Kevinchu77/MobileRobot/0.1.Hardware/0.1.Solidworks/switch/Rocker Switch_KCD1-11_2pin_03.png

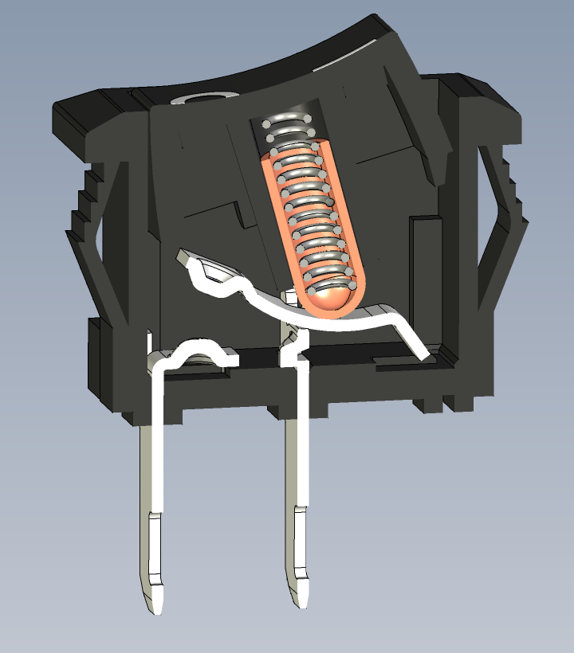
0.1.Hardware/0.1.Solidworks/switch/Rocker Switch_KCD1-11_2pin_03.png
