Kevinchu77/MobileRobot/README.md

# MobileRobot
Line Follower Robot

Date Start:
Date Finished:
