Kevinchu77/MobileRobot/0.1.Hardware/0.1.Solidworks/7c035552-377d-488c-9ed5-d222bd1f89a3.jpg

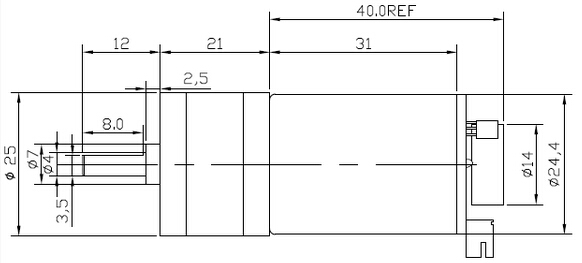
0.1.Hardware/0.1.Solidworks/7c035552-377d-488c-9ed5-d222bd1f89a3.jpg
