Kevinchu77/MobileRobot/0.1.Hardware/0.1.Solidworks/GA DONG CO GM 25 SERVOGEAR MOTOR.jpg

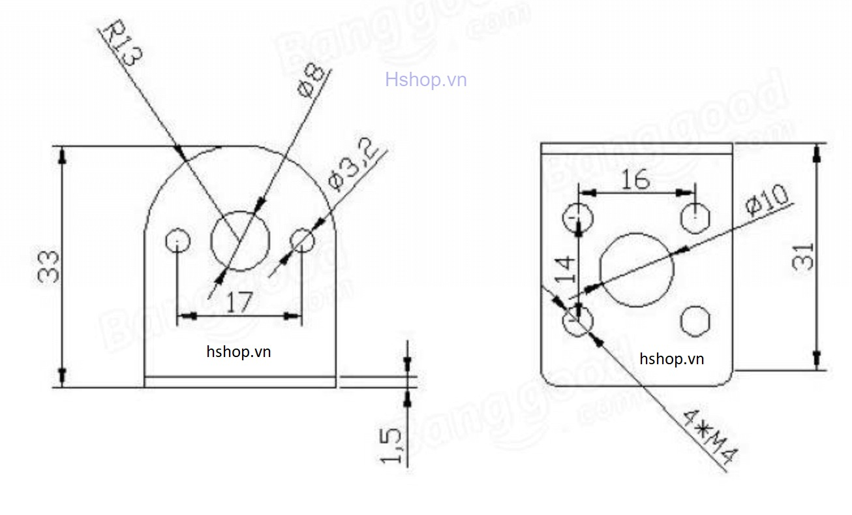
0.1.Hardware/0.1.Solidworks/GA DONG CO GM 25 SERVOGEAR MOTOR.jpg
