Kevinchu77/MobileRobot/0.1.Hardware/0.1.Solidworks/sensor_mid/Rendering/Rendering_1.jpg

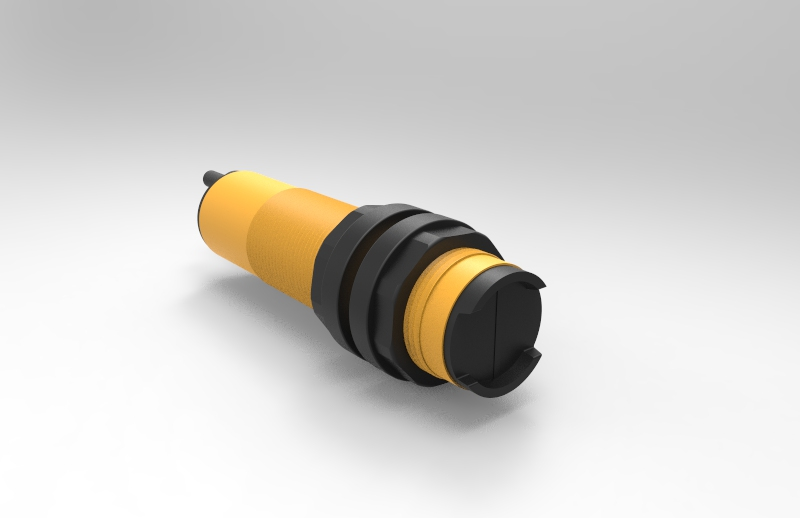
0.1.Hardware/0.1.Solidworks/sensor_mid/Rendering/Rendering_1.jpg
