Kevinchu77/MobileRobot/0.1.Hardware/0.1.Solidworks/sensor_mid/TCRT5000MOD.PNG

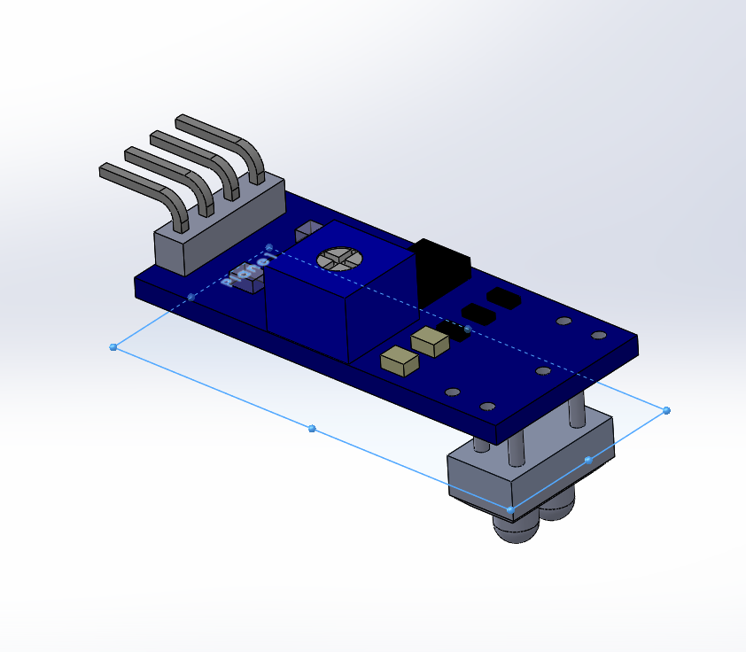
0.1.Hardware/0.1.Solidworks/sensor_mid/TCRT5000MOD.PNG
