Kevinchu77/MobileRobot/0.1.Hardware/0.1.Solidworks/switch/Rocker Switch_KCD1-11_2pin_01.png

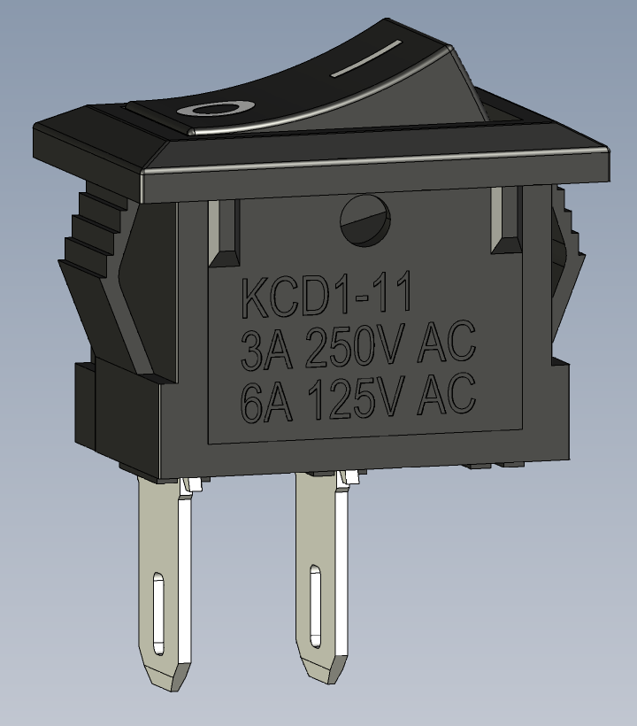
0.1.Hardware/0.1.Solidworks/switch/Rocker Switch_KCD1-11_2pin_01.png
