Kevinchu77/MobileRobot/0.1.Hardware/0.2. Image/top.JPG

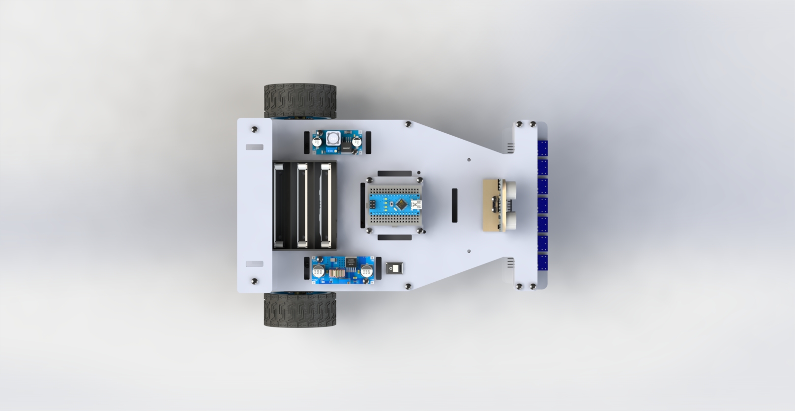
0.1.Hardware/0.2. Image/top.JPG
