Kevinchu77/MobileRobot/0.0.Materials/5.0024760.pdf

Line Follower Robot & Obstacle Detection Using PID Controller (https://www.researchgate.net/publication/345499688_Line_Follower_Robot_Obstacle_Detection_Using_PID_Controller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)

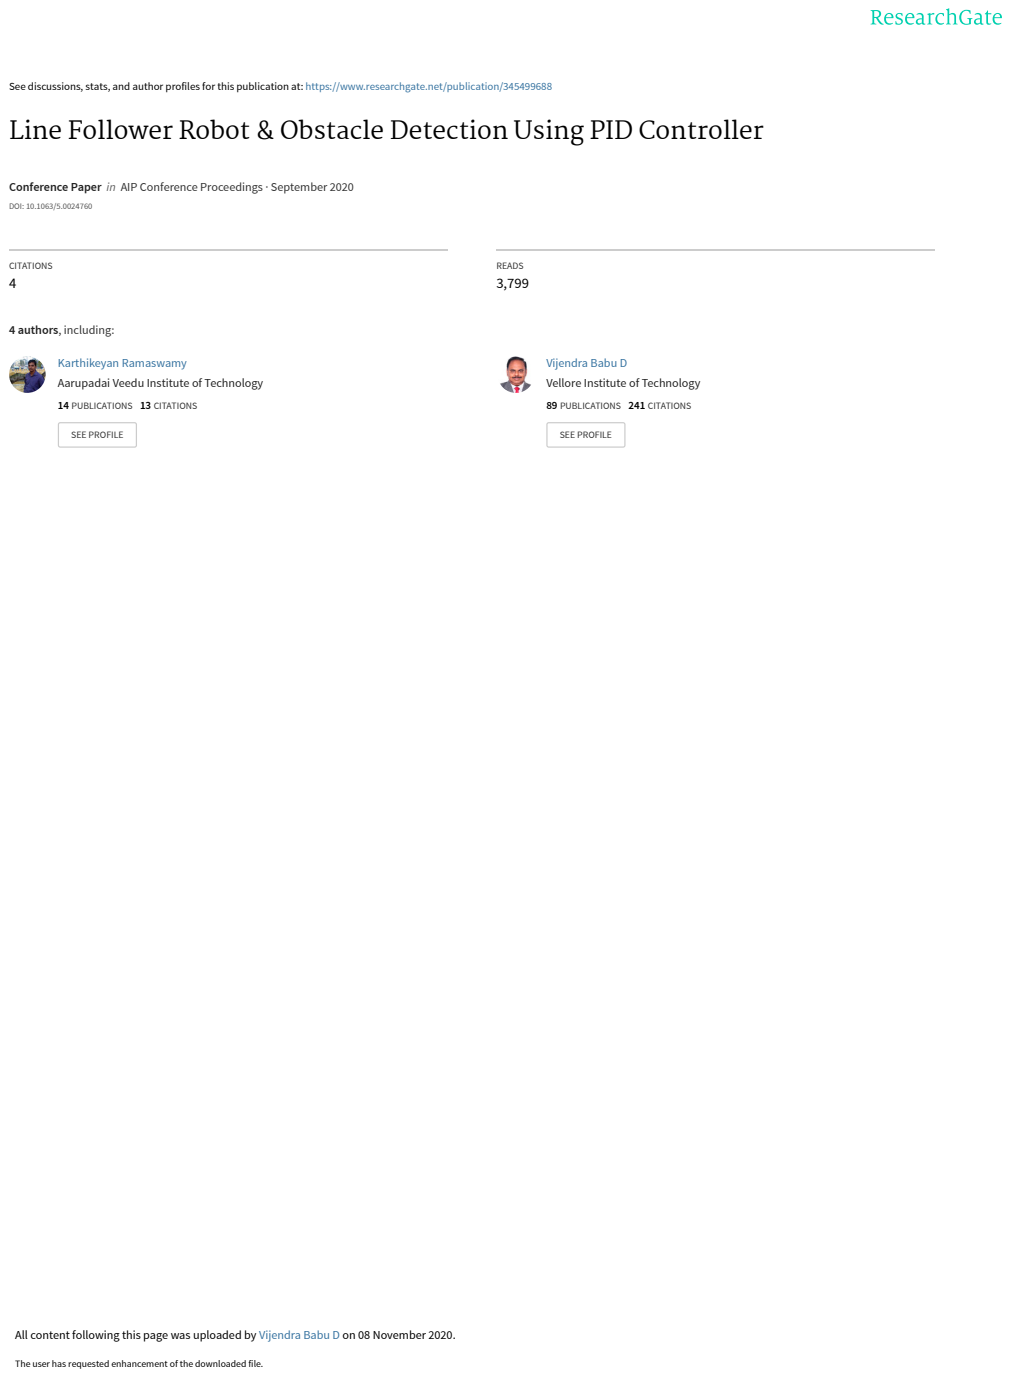
[picture p77: page 1]
DOI: 10.1063/5.0024760; CITATIONS 4; READS 3,799; 4 authors, including:; 14 PUBLICATIONS 13 CITATIONS; SEE PROFILE; 89 PUBLICATIONS 241 CITATIONS

See discussions, stats, and author profiles for this publication at: https://www.researchgate.net/publication/345499688

Conference Paper in AIP Conference Proceedings · September 2020

Karthikeyan Ramaswamy (https://www.researchgate.net/profile/Karthikeyan-Ramaswamy?el=1_x_5&_esc=publicationCoverPdf)
Aarupadai Veedu Institute of Technology (https://www.researchgate.net/institution/Aarupadai-Veedu-Institute-of-Technology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)

Vijendra Babu D (https://www.researchgate.net/profile/Vijendra-Babu-D?el=1_x_5&_esc=publicationCoverPdf)
Vellore Institute of Technology

All content following this page was uploaded by Vijendra Babu D (https://www.researchgate.net/profile/Vijendra-Babu-D?el=1_x_10&_esc=publicationCoverPdf) on 08 November 2020.

The user has requested enhancement of the downloaded file.

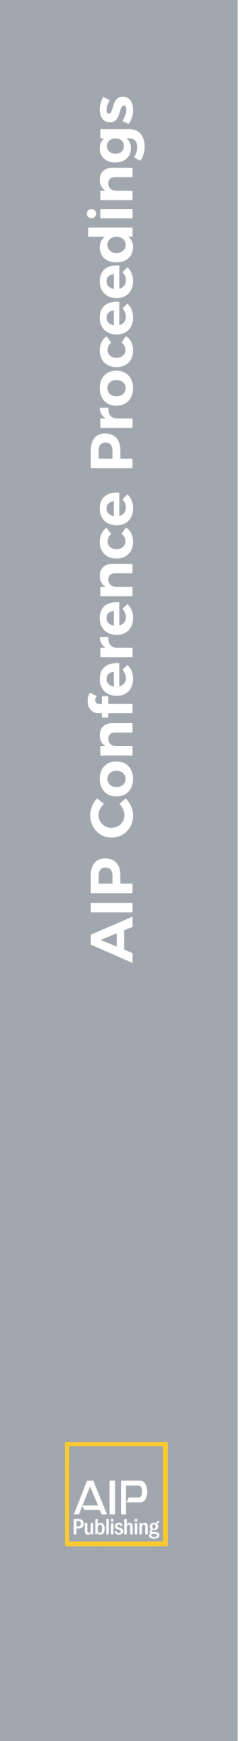
[picture p78: figure]
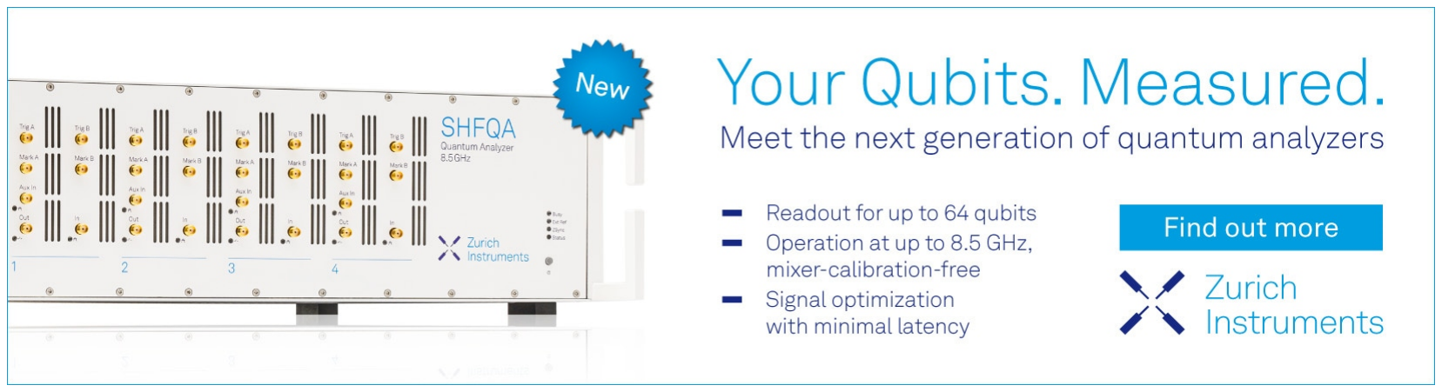
[picture p79: figure]

AIP Conference Proceedings 2271, 030005 (2020); https://doi.org/10.1063/5.0024760 | 2271, 030005

© 2020 Author(s).

# Line follower robot & obstacle detection using PID controller

Cite as: AIP Conference Proceedings 2271, 030005 (2020); https://doi.org/10.1063/5.0024760 Published Online: 28 September 2020

D. Vijendra Babu, (https://aip.scitation.org/author/Babu%2C+D+Vijendra) D. C. Jenniffer, (https://aip.scitation.org/author/Jenniffer%2C+D+C) and R. Karthikeyan (https://aip.scitation.org/author/Karthikeyan%2C+R)

### ARTICLES YOU MAY BE INTERESTED IN

Preface: International Conference on Mechanical, Electronics and Computer Engineering: ICMECE2020 (https://aip.scitation.org/doi/10.1063/12.0001149)
AIP Conference Proceedings 2271, 010001 (2020); https://doi.org/10.1063/12.0001149

Utilization of e-waste in flexible pavement (https://aip.scitation.org/doi/10.1063/5.0024752)
AIP Conference Proceedings 2271, 030001 (2020); https://doi.org/10.1063/5.0024752

Optimization of pitch distance of kevlar thread stitching in chopped GFRP composite laminates (https://aip.scitation.org/doi/10.1063/5.0024784)
AIP Conference Proceedings 2271, 030021 (2020); https://doi.org/10.1063/5.0024784

# Line Follower Robot & Obstacle Detection Using PID Controller

## D.Vijendra Babu¹,a), D.C.Jenniffer²

## , R.Karthikeyan³

1

Professor, ²

PG Student, ³
Assistant Professor, AarupadaiVeedu Institute of Technology, Vinayaka Mission’s Research Foundation, Deemed to be University, Chennai, India.
a) Corresponding author: vijendrababu@avit.ac.in

Abstract.Navigation is the significant feature in applications of Mobile Robots. Various navigation tools are available based on accuracy & complexity. PID Controller is used for designing a Line follower Robot. Array of multiple sensors detects the black surface and travel along the line. Arduino Uno continuously monitors the signal from the sensors and turns the Robot as the line getting detected. Obstacle detection is performed by Ultrasonic sensor. Line follower Robots are applicable in military, intruder alarm systems and so on.

Keywords. PID, Arduino, obstacle detection, line follower, ultrasonic sensor

### INTRODUCTION

Robotics is a branch of Engineering deals with concepts, design, manufacture and operation. Robotics involves multidisciplinary fields such as Computer Science, Electronics, Artificial intelligence, Nanotechnology & Mechatronics [1]. Line Tracking is significant and desired behavior of mobile robots which has significant importance in current scenario. Line tracking has evolved as the convenient and reliable navigation technique through which autonomous mobile robots navigate at indoor environment in a controlled manner [2]. A Line follower robot follows the predetermined path and determines its own procedure while interacting with obstacle. The path may be visible or invisible. In industries, it is mostly used to carry parcels in a track. With existing degree of autonomy, Mobile robots can move around in specific environment. Autonomous navigation is related to the availability of external sensors which acquires information from environment through visual images or distance. Path detection is determined by proximity sensor and Obstacle detection is determined by IR sensor [3]. Arduino MEGA R3 2650 is a Microcontroller based board recommended for Robotics & 3D Printers. It is compatible with most Uno boards [4].

### SYSTEM DESIGN

Arduino MEGA R3 2650, the most popular Proportional Integral Derivative (PID) controller is used. It is mostly used in industrial control applications for regulating variables as pressure, flow, level, temperature and so on [5].IR

International Conference on Mechanical, Electronics and Computer Engineering AIP Conf. Proc. 2271, 030005-1–030005-7; https://doi.org/10.1063/5.0024760 Published by AIP Publishing. 978-0-7354-3999-3/$30.00

Sensor uses LED for emitting light and measures the received light intensity for detecting the obstacle. Ultrasonic sensor measures the distance by using sound waves using sensors on its front [5-7]. It works in a range 3cm to 3m.The purpose of the motor driver for converting low current signal to high current signal for driving the motor coil [8-9]. It consists of 2 front drive motors and 2 back drive motors.Fig.1 (a) displays the Line follower unit, Fig.1
(b) shows the PID Controller-Arduino MEGA R3 2650 module. Fig. 1(c), Fig.1 (d) &Fig.1 (e) shows IR sensor, Ultrasonic sensor & Motor driver respectively.

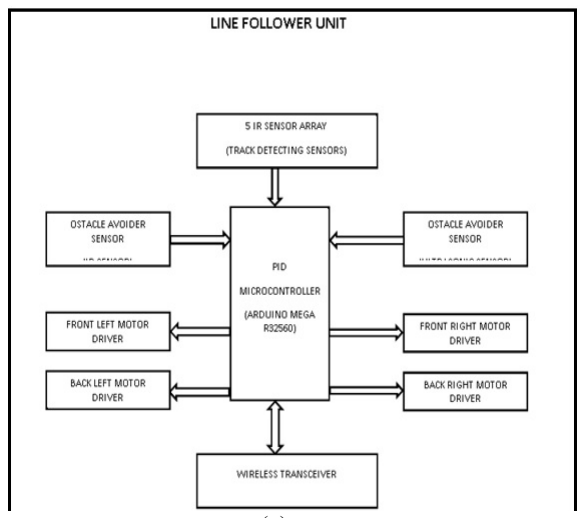
[picture p80: figure]

(a)

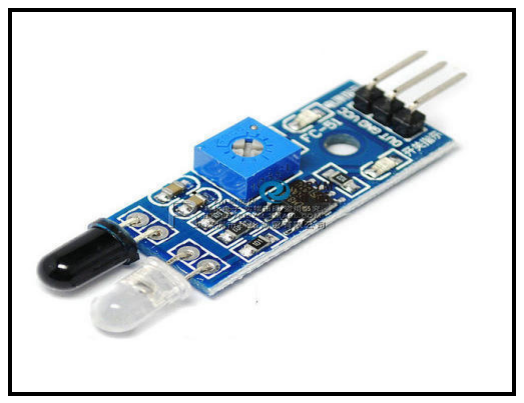
[picture p81: figure]
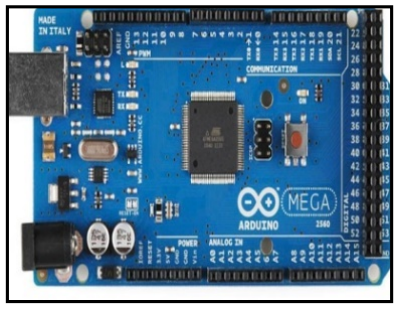
[picture p82: figure]

(b) (c)

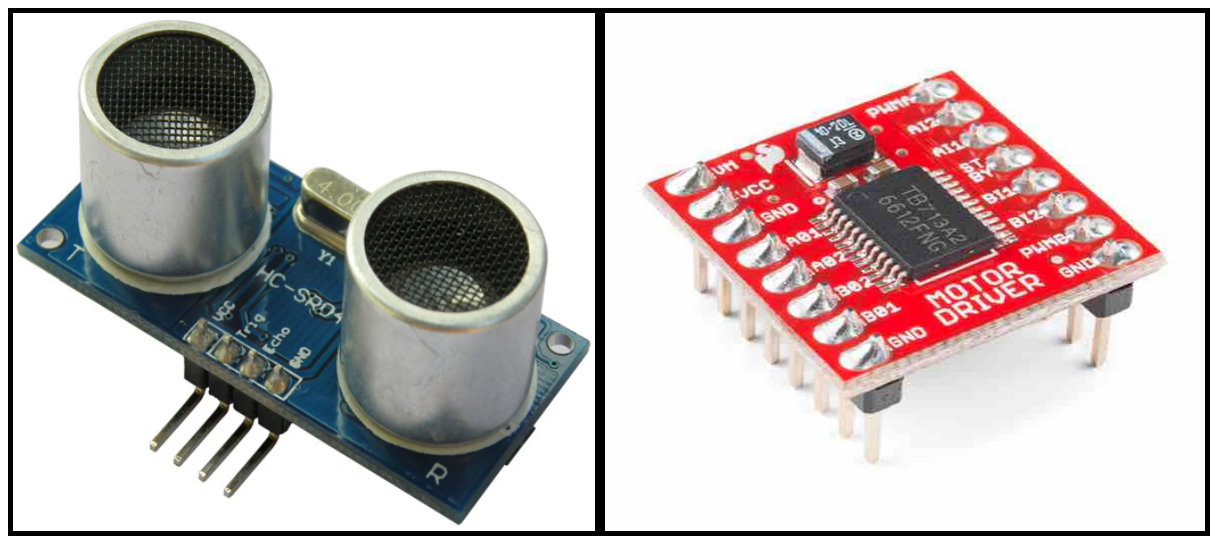
[picture p83: figure]

(d) (e)

FIGURE 1 : (a) Line Follower Unit (b) PID Controller –Arduino MEGA R3 2650
(c) IR Sensor (d) Ultrasonic Sensor (e) Motor driver

### HARDWARE MODULE

Using array of IR sensors, Line follower detects the black surface and travel in the specified path as it is an automated guided vehicle. As black surface absorbs and permits the Robot along its path as detected by Arduino Uno, which detects the changes and indicates to motor driver accordingly for movement. The motor speed is slowed down on the direction decided using PWM, while the other side motor runs at normal speed. Robot is stopped, if an obstacle is detected by Ultrasonic sensor in a range of 5 cm.Fig. 2, Fig.3& Fig.4 shows the Top view, Side view & Front view of the hardware module respectively.Fig.5 shows the IR sensor array view. Fig.6 shows the Moving forward status.Fig.7& Fig.8 shows Turning Left and Turning Right respectively.Fig.9 shows the Stop status.

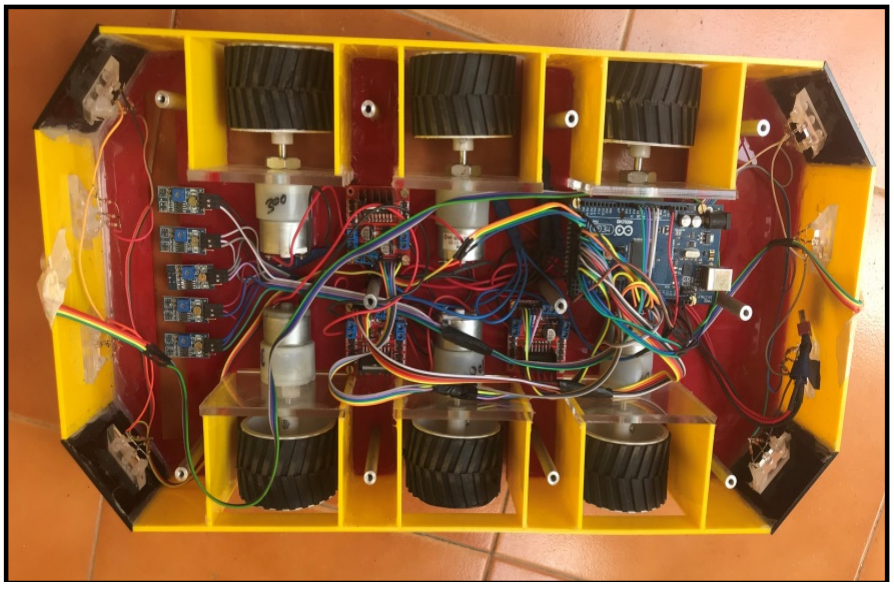
[picture p84: figure]

FIGURE 2 : Top view of Prototype

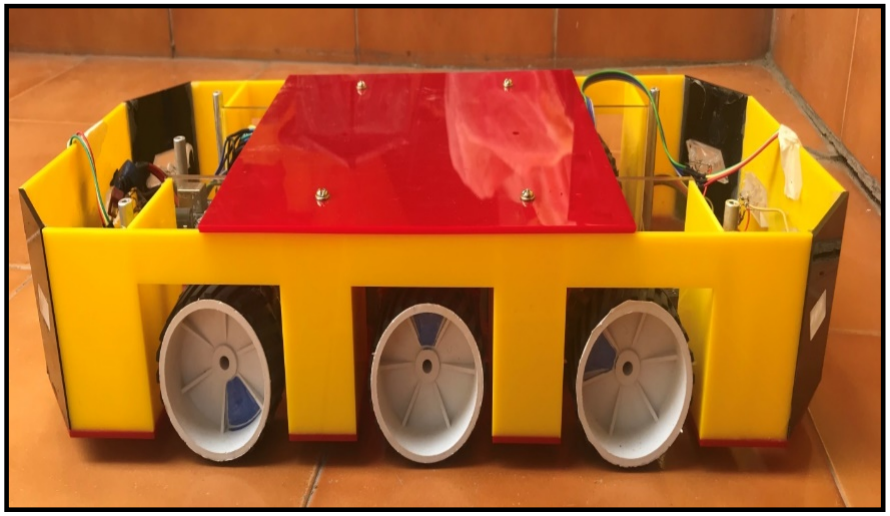
[picture p85: figure]

FIGURE 3 : Side view of Prototype

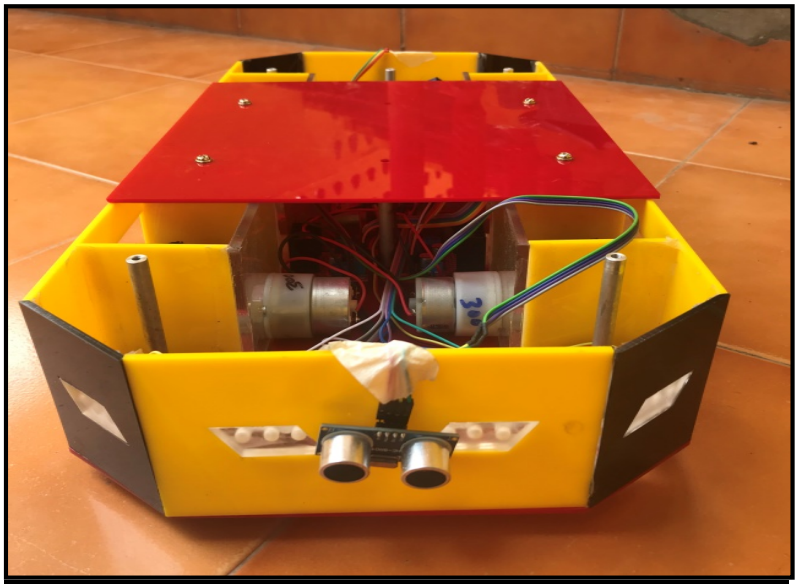
[picture p86: figure]

FIGURE 4 : Front view of Prototype

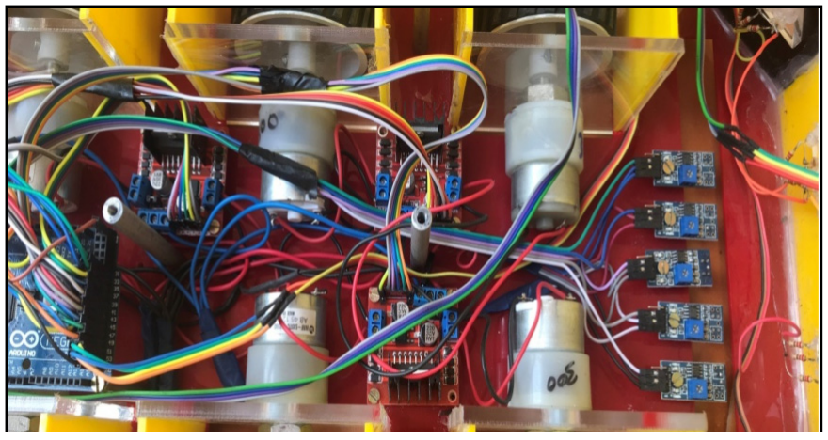
[picture p87: figure]

FIGURE 5 : Sensor array view

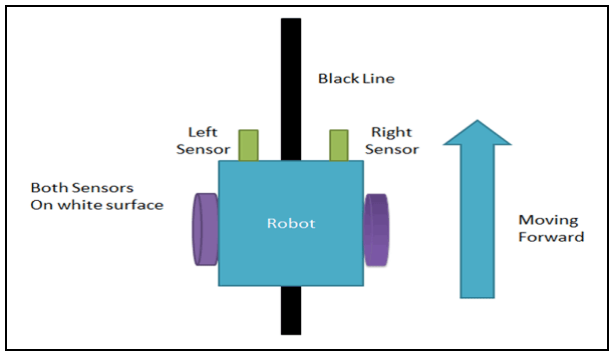
[picture p88: figure]

FIGURE 6 : Moving forward

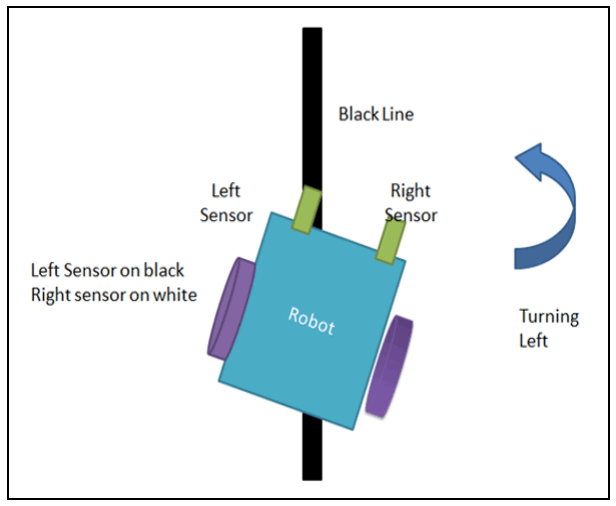
[picture p89: figure]

FIGURE 7 : Turning left

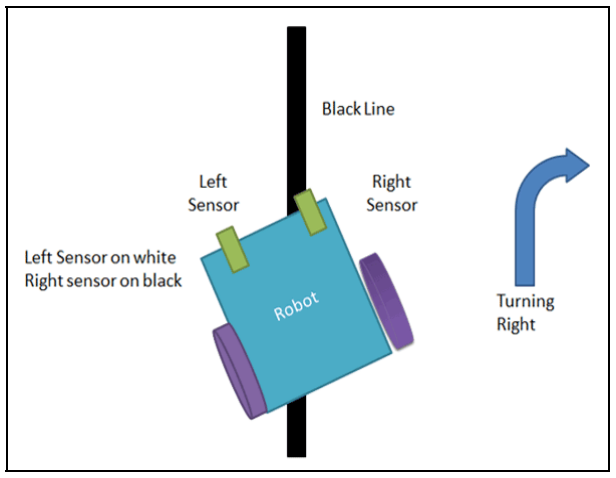
[picture p90: figure]

FIGURE 8 : Turning right

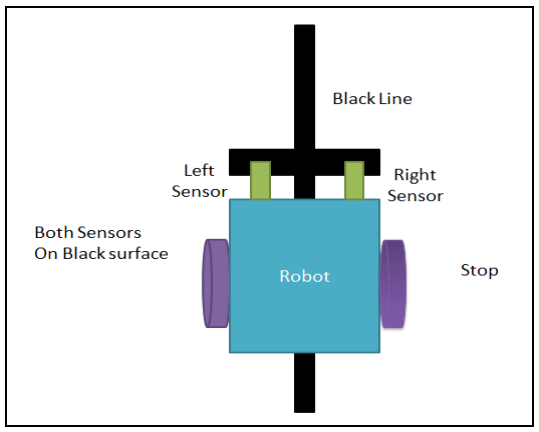
[picture p91: figure]

FIGURE 9 : Stop

LED is
track and
detection. F

used to indica
obstacles in th
Fig. 12 shows

te the turn of t
he path. Fig. 1
the Line follow

### RESULTS

the line follow
10 shows the r
wer Robot mot

### & DISCUS

wer Robot eithe
right turn of li
tion after obsta

### SSIONS

er Left or Righ
ine follower R
acle detection.

ht. PID control
Robot. Fig. 11

ller detects the
shows the Ob

exact
stacle

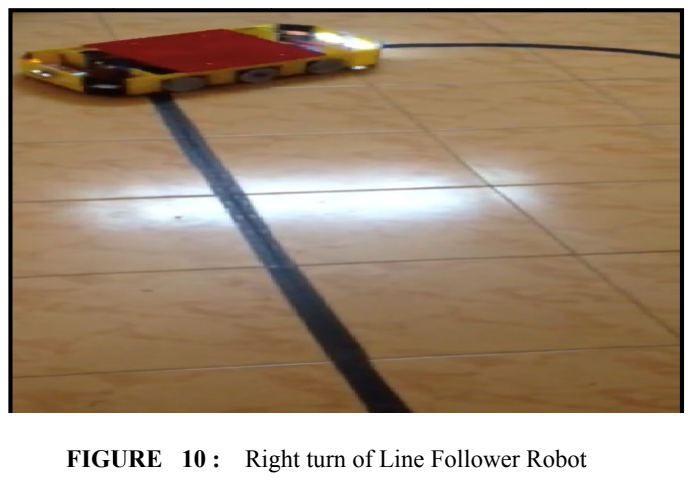
[picture p92: figure]
FIGU; URE 10 : Rig; ght turn of Line; Follower Robot
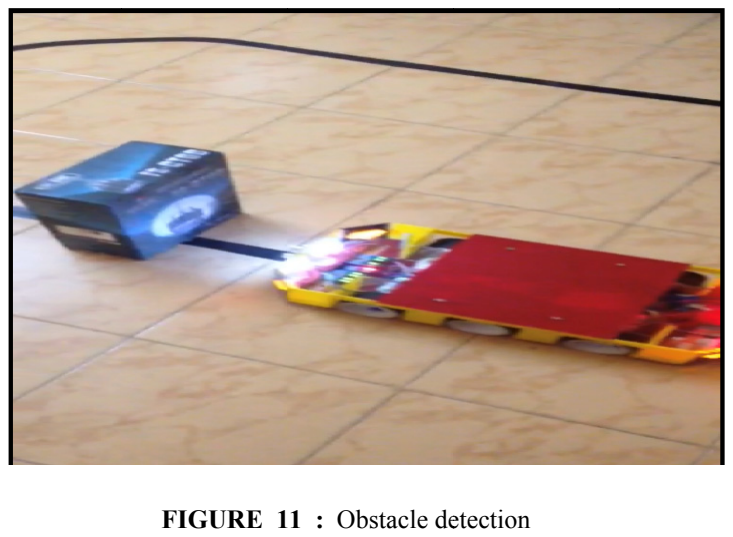
[picture p93: figure]
FIGURE 1; 1 : Obstacle de; etection
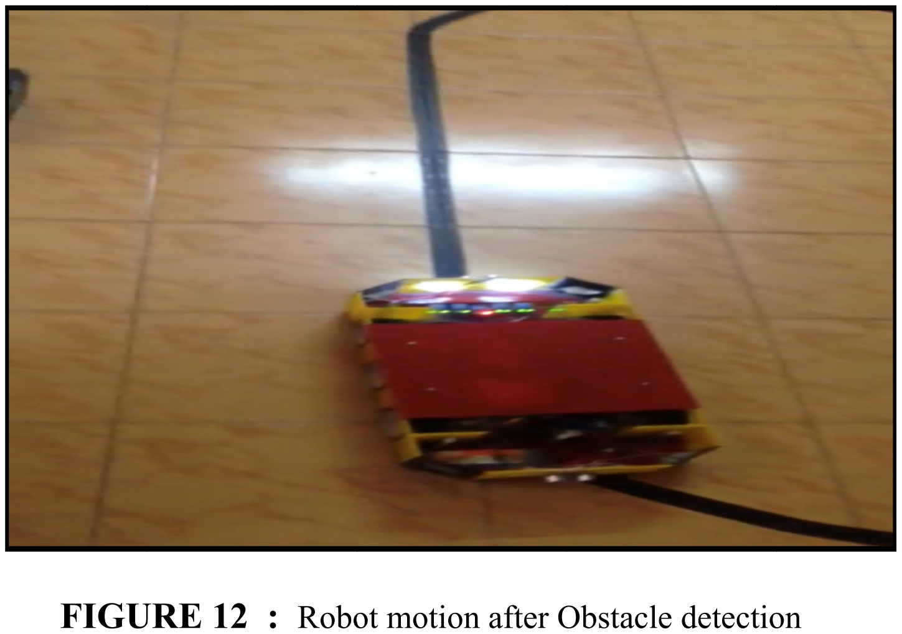
[picture p94: figure]
FIGU; URE 12 : Robo ot motion after O; Obstacle detectio

### CONCLUSION

The designed Line follower Robot detects the obstacle and follows the path effectively. The Camera used can be enhanced to capture images and send to intended user through Bluetooth or any wireless communication technologies for more control options.

## REFERENCES

1. M.Pakdaman and M.M. Sanaatiyan, "Design and Implementation of Line Follower Robot,” Second International Conference on Computer and Electrical Engineering, (Dubai, 2009),pp. 585-590.
2. B. Touchton, T. Galluzzo, D. Kent, and C. Crane, “Perception and planning architecture for autonomous ground vehicles”, IEEE Journals of Computer Society, (2006).
3. H. U. Zaman, M. M. H. Bhuiyan, M. Ahmed and S. M. T. Aziz, "A novel design of line following robot with multifarious function ability," International Conference on Microelectronics, Computing and Communications (MicroCom), (Durgapur, India, 2016), pp. 1-5.
4. J.Tian, M.Gao and E. Lu, "Dynamic Collision Avoidance Path Planning for Mobile Robot Based on Multi-sensor Data Fusion by Support Vector Machine,” International Conference on Mechatronics and Automation, (Harbin, 2007), pp. 2779-2783.
5. A. M. Alajlan, M. M. Almasri and K. M. Elleithy,"Multi-sensor based collision avoidance algorithm for mobile robot," Long Island Systems, Applications and Technology, (Farmingdale, NY, 2015), pp. 1-6.
6. D.Vijendra Babu, M.Karthick, C.Iyyapan, “Advanced User Interface of Wheelchair based on Android”, International Journal of Engineering and Advanced Technology, (India, 2019), pp.-2094-2096.
7. D.Vijendra Babu, S.K.Sivasubramanian, “Home automation through Eyeball motion for Disabled persons”,International Journal of Engineering and Advanced Technology, (2019), pp.2113-2116.
8. D.Vijendra Babu,S.Dhanushya,S.Aravind,V.P.Mohammed Aslam, “Arduino based Automatic License issuing system”, International Journal of Engineering and Advanced Technology,(2019),pp.2097-2099.
9. D.Vijendra Babu and Dr.N.R.Alamelu, “A Novel Morpho Codec Medical Video Compression based on Lifting Wavelet Transform”,Asian Journal of Scientific Research,(2014), pp. 85-93.

View publication stats (https://www.researchgate.net/publication/345499688)
