Kevinchu77/MobileRobot/0.0.Materials/Thuy___t-Minh-Final.pdf

ĐẠI HỌC QUỐC GIA THÀNH PHỐ HỒ CHÍ MINH

TRƯỜNG ĐẠI HỌC BÁCH KHOA

KHOA CƠ KHÍ

BỘ MÔN CƠ ĐIỆN TỬ

***

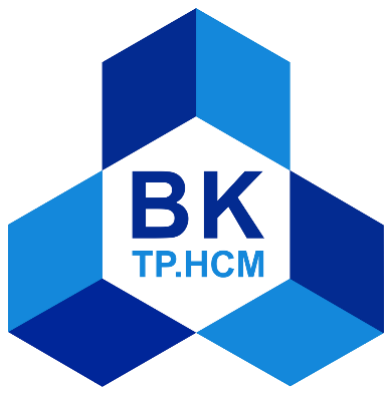
[picture p95: figure]

## BÁO CÁO ĐỒ ÁN

## MÔN: THIẾT KẾ HỆ THỐNG CƠ ĐIỆN TỬ

GVHD: TS. Phạm Công Bằng

DANH SÁCH THÀNH VIÊN

STT | Họ và tên | MSSV
1 | Nguyễn Ngọc Gia Hân | 1711237
2 | Nguyễn Văn Hậu | 1711256
3 | Phạm Đoàn Minh Duy | 1710044
4 | Lê Cảnh Hoàng | 1710095

TP.HCM, THÁNG 01/2021

ii

LỜI CẢM ƠN

Nhóm thực hiện đồ án xin gửi lời cảm ơn chân thành đến thầy TS. Phạm Công

Bằng, người trực tiếp hướng dẫn nhóm trong suốt quá trình thực hiện đồ án này. Thầy

đã hướng dẫn tận tình, tận tâm và sự chỉ bảo nhiệt tình của thầy đã giúp nhóm vượt qua

được nhiều vấn đề khó khăn.

Ngoài ra, nhóm cũng muốn gửi lời cảm ơn đến các bạn bè trong tập thể lớp

CK17KSCD đã cùng đồng hành và trợ giúp cho nhóm trong những lúc khó khăn, góp

phần giúp nhóm hoàn thành đồ án này.

Nhóm sinh viên thực hiện

Nguyễn Ngọc Gia Hân

Nguyễn Văn Hậu

Phạm Đoàn Minh Duy

Lê Cảnh Hoàng

iii

MỤC LỤC

iv

v

vi

DANH MỤC HÌNH ẢNH

Hình 1.5. Cấu trúc ba bánh (a,b,c); cấu trúc bốn bánh (d,e,f); dẫn động bánh trước

Hình 1.9. Nguyên lý hoạt động và sơ đồ mạch của cảm biến hồng ngoại TCRT5000

vii

Hình 3.10. Đồ thị quan hệ giữa vị trí thực và vị trí tính toán của tâm đường line so

Hình 4.5. Mức độ chính xác của hàm truyền vừa tìm so với giá trị đáp ứng đầu ra

viii

DANH MỤC BẢNG

ix

DANH SÁCH PHÂN CÔNG NHIỆM VỤ

STT | Họ tên | Nhiệm vụ
1 | Nguyễn Ngọc Gia Hân | - Nhóm trưởng - Thiết kế luật điều khiển dò line, mô phỏng - Xây dựng hàm truyền động cơ - Xây dựng bộ điều khiển cho hệ thống - Xây dựng sơ đồ khối cho hệ thống điều khiển
2 | Nguyễn Văn Hậu | - Tính toán lựa chọn động cơ - Lựa chọn vi điều khiển và xây dựng lưu đồ giải thuật - Mô hình hóa hệ thống - Lập trình các vi điều khiển - Vẽ bản vẽ giải thuật và bản vẽ điện
3 | Phạm Đoàn Minh Duy | - Đọc và test cảm biến - Thiết kế mạch cảm biến và mạch điện điều khiển - Thiết kế giải thuật cho xe đi qua ngã ba - Soạn thuyết minh
4 | Lê Cảnh Hoàng | - Thiết kế cơ khí, tính bền và dung sai - Vẽ phác thảo và hiệu chỉnh - Vẽ 3D và hiệu chỉnh - Soạn bản vẽ lắp và bản vẽ phương án

x

CHƯƠNG 1: TỔNG QUAN VÀ LỰA CHỌN PHƯƠNG ÁN

TỔNG QUAN VÀ LỰA CHỌN PHƯƠNG ÁN

### 1.1. Giới thiệu về robot dò line (AGV):

Robot dò line là một dạng của robot di động và được thiết kế để bám theo một quỹ

đạo cho trước. Hiện nay, robot dò line đã được ứng dụng rất nhiều trong cả lĩnh vực

công nghiệp lẫn giáo dục. Trong công nghiệp, robot dò line thường được biết đến với

tên gọi AGV (Automated guided vehicle) và việc ứng dụng nó đã thay đổi cách mà các

kho hàng được sắp xếp và vận hành trên toàn thế giới.

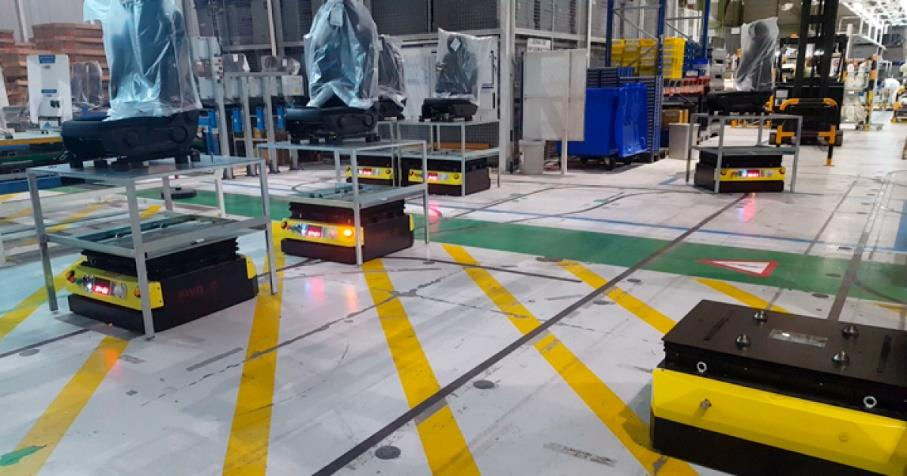
[picture p96: figure]

Hình 1.1. AGV dò line hoạt động trong nhà kho

Trong lĩnh vực giáo dục, robot dò line được sử dụng để dạy cho các sinh viên đặc

biệt là các sinh viên chuyên ngành cơ điện tử cách thức thiết kế, chế tạo và vận hành

một hệ thống cơ điện tử.

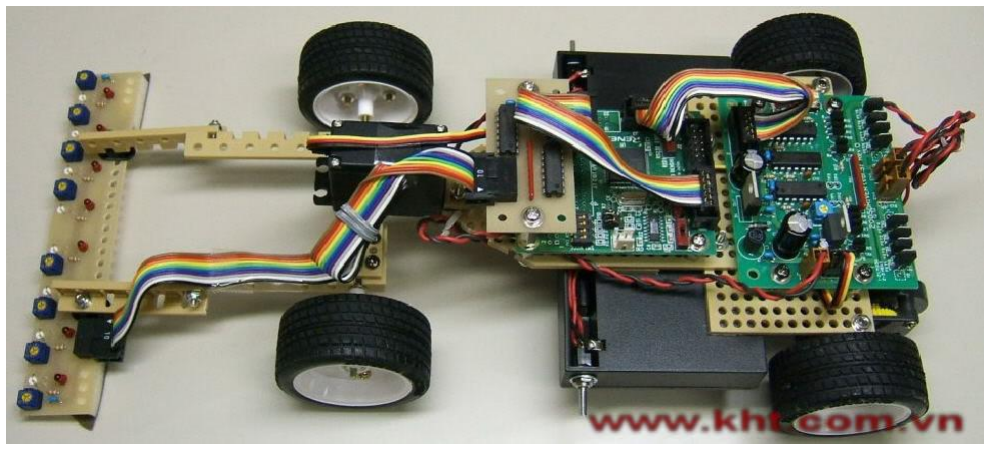
[picture p97: figure]

Hình 1.2. Robot dò line trong một cuộc thi học thuật

CHƯƠNG 1: TỔNG QUAN VÀ LỰA CHỌN PHƯƠNG ÁN

Hiện nay, các cuộc thi về robot dò line đã được tổ chức với số lượng và chất lượng

ngày càng tăng nhằm mục đích khuyến khích sinh viên vận dụng những gì đã được học

áp dụng dụng vào giải quyết các vấn đề của cuộc thi đặt ra. Phương châm “Learn by

doing” đã được chứng minh là giúp sinh viên hiểu sâu và có khả năng áp dụng linh hoạt

những gì mình được học. Các cuộc thi nổi tiếng về robot dò line có thể kể đến như: cuộc

thi LVBots Line following được tổ chức bởi Pololu, cuộc thi Robotchallenge 2015 Line

Follower & Line Follower Enhanced và nhiều cuộc thi khác.

### 1.2. Một số robot dò line ở các cuộc thi quốc tế

### 1.2.1. Robot uXbots

Robot uXbots là robot có cấu trúc ba bánh vi sai với hai bánh dẫn động được đặt

phía sau. Nó được tạo ra với mục đích giáo dục và đã tham gia cuộc thi Hispabots Competition và Robolid Competition được tổ chức ở Tây Ban Nha. uXbots có những

đặc điểm như:

- Dẫn động bằng hai động cơ DC Maxon
- Vận tốc tối đa: 3 m⁄s
- Cảm biến: cảm biến hồng ngoại và cảm biến quán tính IMU
- Giải thuật dò line: Giải thuật học đường đi và giải thuật thích nghi
- Giao tiếp: Bluetooth

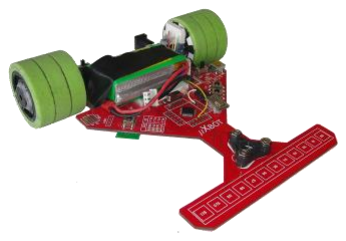
[picture p98: figure]

Hình 1.3. robot uXbots

### 1.2.2. Robot Chariot

Robot đã tham gia cuộc thi LVBots Line Following Competition được tổ chức bởi

Pololu vào tháng 4 năm 2015. Chariot có hình dáng như tên gọi của nó, là “một chiếc

CHƯƠNG 1: TỔNG QUAN VÀ LỰA CHỌN PHƯƠNG ÁN

xe kỵ binh” đạt tốc độ lớn nhất là 1,17m/s và giành được giải nhì trong cuộc thi đó.

Một số đặc điểm của Robot Chariot như:

- Dẫn động bằng hai động cơ DC Pololu 15,5D
- Vận tốc tối đa: 1,17 m⁄s
- Cảm biến: thanh cảm biến hồng ngoại QTR – 8RC
- Giải thuật điều khiển: PID để điều khiển hai động cơ

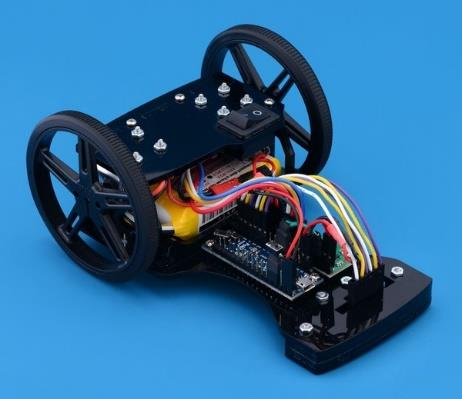
[picture p99: figure]

Hình 1.4. Robot Chariot

### 1.3. Đầu bài thiết kế

Mục tiêu của đầu bài thiết kế là thiết kế robot có khả năng bám theo quỹ đạo đề

cho một cách ổn định và có thời gian hoàn thành đường đi ngắn nhất có thể. Dựa theo

quy định của đề bài về tốc độ di chuyển của robot (vmin = 0,2 m/s) cũng như tham

khảo về tốc độ của một số mô hình robot dò line trong và ngoài nước, nhóm đặt ra yêu

cầu về vận tốc của xe:

Vận tốc tối đa của xe khi chạy: vmax = 0,6 m/s

### 1.4. Lựa chọn cấu trúc cơ khí

Robot dò line có rất nhiều cấu trúc cơ khí: cấu trúc hai bánh, cấu trúc ba bánh, cấu

trúc bốn bánh hay thậm chí cấu trúc sử dụng bánh xích hay bánh omni. Đối với mục tiêu

về tốc độ mà đầu bài thiết kế đã đặt ra thì chỉ có cấu trúc ba bánh và bốn bánh là khả thi

nhất để có thể chế tạo cũng như là có thể đạt được vận tốc như mong muốn. Chính vì

vậy, nhóm chỉ liệt kê các cấu trúc cơ khí khả thi thuộc 2 nhóm cấu trúc ba bánh và cấu

trúc bốn bánh.

Cấu trúc cơ khí được lựa chọn dựa trên 3 đặc điểm chính:

CHƯƠNG 1: TỔNG QUAN VÀ LỰA CHỌN PHƯƠNG ÁN

- Số lượng bánh xe
- Vị trí đặt các bánh dẫn động
- Loại động cơ dẫn động

Dựa theo số lượng bánh xe và vị trí đặt các bánh dẫn động, ta có các cơ cấu sau

khả thi:

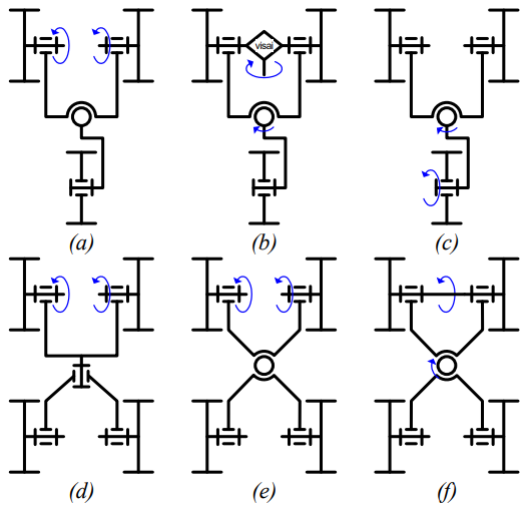
[picture p100: figure]

Hình 1.5. Cấu trúc ba bánh (a,b,c); cấu trúc bốn bánh (d,e,f); dẫn động bánh

trước (b,c); dẫn động bánh sau (a,d,e,f)

### 1.4.1. Số lượng bánh xe

Như đã nói ở trên, nhóm chỉ tập trung phân tích 2 loại cấu trúc là cấu trúc khung

xe ba bánh và cấu trúc khung xe bốn bánh.

Đặc điểm của cấu trúc khung xe ba bánh:

❖ Ưu điểm:

- Ba bánh luôn đồng phẳng
- Cấu trúc xe đơn giản và gọn nhẹ
- Lực cản nhỏ

CHƯƠNG 1: TỔNG QUAN VÀ LỰA CHỌN PHƯƠNG ÁN

❖ Nhược điểm:

- Không ổn định khi vào cua

Đặc điểm của cấu trúc khung xe bốn bánh:

❖ Ưu điểm:

- Giúp xe ổn định hơn khi vào cua
- Giúp phân phối đều lực kéo của động cơ
- Có thể chạy ở nhiều dạng địa hình

❖ Nhược điểm:

- Cần có cơ cấu đồng phẳng để giúp xe chạy ổn định
- Lực cản lớn hơn so với cấu trúc xe ba bánh

Do đề bài không yêu cầu tải và xe chỉ chạy trên sa bàn phẳng nên lựa chọn phương

án cấu trúc khung xe ba bánh. Ngoài ra, cấu trúc ba bánh cũng giúp xe chạy nhanh hơn,

phù hợp với yêu cầu thời gian chạy phải đạt mức ngắn nhất có thể mà đầu bài thiết kế

đã đặt ra.

### 1.4.2. Vị trí đặt các bánh chủ động

Cấu trúc khung xe ba bánh của robot dò line được phân ra làm hai dạng phụ thuộc

vào vị trí các bánh dẫn động: hai bánh dẫn động đặt phía sau và hai bánh dẫn động đặt

phía trước.

Bánh dẫn động đặt phía sau | Bánh dẫn động đặt phía trước

Hình 1.6. Hai dạng chính của cấu trúc khung xe ba bánh

Nhóm chọn phương án đặt phía sau vì khi hai bánh dẫn động ở phía sau sẽ giúp

kiểm soát trọng tâm xe tốt hơn. Ngoài ra, khi đặt hai bánh ở phía sau thì thời gian truyền

dữ liệu từ cảm biến đến động cơ sẽ dài hơn, cho phép động cơ có thời gian xử lý dữ liệu,

CHƯƠNG 1: TỔNG QUAN VÀ LỰA CHỌN PHƯƠNG ÁN

tránh xảy ra hiện tượng rung lắc do động cơ không đáp ứng được.

### 1.4.3. Loại động cơ dẫn động

Có rất nhiều loại động cơ có sẵn trên thị trường hiện nay có thể dùng để dẫn động

cho robot dò line. Dựa vào một số tiêu chí như giá cả, khả năng hoạt động, tần suất sử

dụng trong các robot dò line hiện hành,… nhóm lọc ra một số loại động cơ để phân tích

cụ thể ưu nhược điểm của từng loại.

a. Động cơ step:
❖ Ưu điểm:
- Điều khiển vị trí chính xác
- Moment xoắn là hằng số
- Không có vọt lố
- Dễ điều khiển

❖ Nhược điểm:

- Vận tốc nhỏ và không liên tục
- Moment xoắn nhỏ nếu so với động cơ DC cùng kích thước
b. Động cơ DC servo
❖ Ưu điểm
- Điều khiển vị trí chính xác
- Moment xoắn lớn
- Tốc độ quay cao
- Dễ điều khiển nhờ vào bộ driver

❖ Nhược điểm

- Giá cao
- Kích thước tương đối lớn
c. Động cơ DC
❖ Ưu điểm
- Moment xoắn lớn
- Tốc độ quay lớn
- Giá rẻ
- Có nhiều kích cỡ

CHƯƠNG 1: TỔNG QUAN VÀ LỰA CHỌN PHƯƠNG ÁN

❖ Nhược điểm

- Có vọt lố
- Rất khó để điều khiển chính xác vị trí

Do mục đích của xe là chạy nhanh nên các giải thuật điều khiển đều là điều khiển

tốc độ. Vì vậy, nhóm lựa chọn động cơ DC kết hợp với encoder để hồi tiếp vận tốc.

### 1.5. Lựa chọn cảm biến

Đối với robot dò line, có rất nhiều loại cảm biến để đo độ lệch của robot so với

line như: cảm biến hồng ngoại, cảm biến từ, camera,…

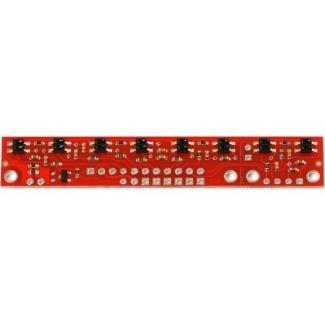
[picture p101: figure]
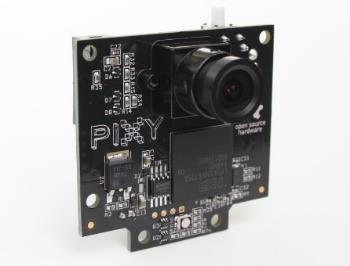
[picture p102: figure]
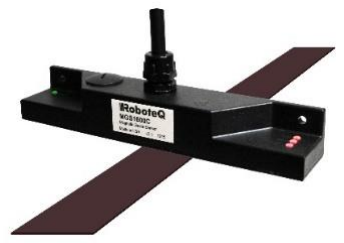
[picture p103: figure]

Camera Pixy5 | Thanh cảm biến hồng ngoại | Cảm biến từ
| QTR – 8RC | MGS1600C

Hình 1.7. Các loại cảm biến dùng cho robot dò line

Cảm biến được chọn dựa trên loại line được sử dụng. Đối với đồ án thiết kế là line

đen kẻ trên nền trắng nên phần này chỉ tập trung phân tích cảm biến hồng ngoại và

camera. Còn loại cảm biến từ thường được sử dụng trong các nhà kho hiện đại như nhà

kho của Amazon, cảm biến từ ít bị ảnh hưởng bởi nhiễu nhưng đòi hỏi chi phí đầu tư

ban đầu lớn.

### 1.5.1. Camera CMU

Camera CMU là một cảm biến giá rẻ và tiêu thụ năng lượng thấp dùng cho ứng

dụng robot di động. Camera sẽ chụp một số các bức ảnh trong đơn vị thời gian và các

bức ảnh sẽ được tách thành các Pixel để xử lý. Đối với robot dò line, các bức ảnh do

camera chụp sẽ là thông tin cho bộ xử lý tìm ra độ tương phản của line đen và nền trắng

(hoặc ngược lại) từ đó tính độ lệch của robot so với line. Độ chính xác của camera dựa vào ba yếu tố chính: độ phân giải, số khung hình trên giây (fps) và tốc độ của bộ xử lý.

CHƯƠNG 1: TỔNG QUAN VÀ LỰA CHỌN PHƯƠNG ÁN

Các thông số của camera CMU:

- Số khung hình trên giây: 26fps
- Độ phân giải: 176 × 255
- Tốc độ truyền: 115200 − 1200

Từ các thông số trên ta thấy rằng camera CMU có số khung hình trên giây rất thấp

mặc dù có tốc độ truyền dữ liệu rất cao. Điều này có nghĩa là đối với xe muốn chạy với

tốc độ cao thì CMU không thể xử lý kịp so với tốc độ chạy của robot. Thông thường

camera chỉ phù hợp với các ứng dụng AGV có tốc độ vận hành khá chậm. Do đó nên

phương án sử dụng cảm biến là camera không phù hợp với đầu bài thiết kế.

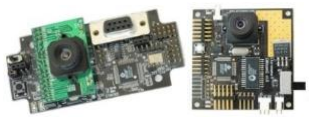
[picture p104: figure]

Hình 1.8. Camera CMU

### 1.5.2. Cảm biến hồng ngoại

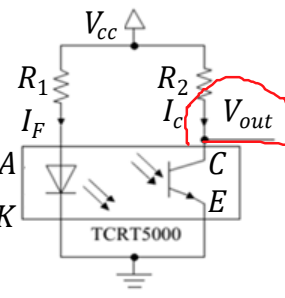
[picture p105: figure]
Vout; Vcc

A
K

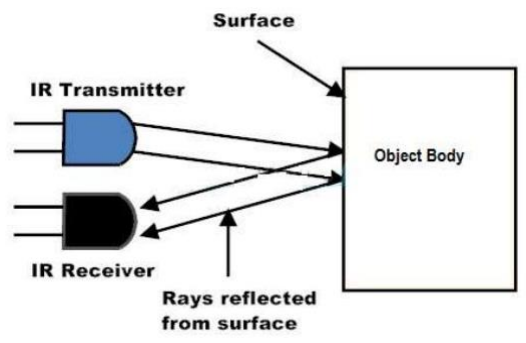
[picture p106: figure]

Hình 1.9. Nguyên lý hoạt động và sơ đồ mạch của cảm biến hồng ngoại

TCRT5000

Cảm biến hồng ngoại có hai LED hồng ngoại: LED phát và LED thu. Khi cảm

biến hoạt động, LED phát sẽ phát ra một tia hồng ngoại và tia hồng ngoại này khi đập

vào vật có màu trắng sẽ phản xạ lại LED thu. Khi tia hồng ngoại này gặp vật đen, tia đó

sẽ bị hấp thụ và LED thu không thể nhận được tia phản xạ.

Điện thế ở đầu ra trên hình 1.9 được tính theo công thức sau:

CHƯƠNG 1: TỔNG QUAN VÀ LỰA CHỌN PHƯƠNG ÁN

Vout =

RC
RC+RE
. Vcc | (1.1)

Với RC là điện trở nội của LED thu.

Khi LED thu không nhận được tia phản xạ thì giá trị của RC rất lớn (xấp xỉ hàng

trăm kΩ) nên công thức (1.1) có thể xấp xỉ thành Vout ≈ Vcc

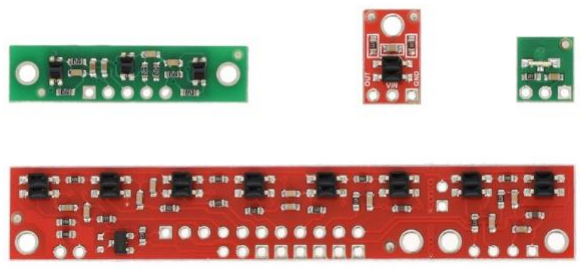
[picture p107: figure]

Hình 1.10. Các cảm biến hồng ngoại và thanh cảm biến hồng ngoại

Bằng cách kết hợp nhiều cảm biến hồng ngoại với nhau thành một thanh cảm biến

và đo các hiệu điện thế đầu ra của cảm biến, bộ xử lý có thể tính toán độ lệch của robot

so với line. Một số cách sắp xếp cảm biến thông dụng như: xếp theo dãy, xếp theo ma

trận, xếp theo hình mũi tên,…

Cảm biến sắp xếp theo

dãy

Cảm biến sắp xếp theo

ma trận

Cảm biến sắp xếp

theo hình mũi tên

Hình 1.11. Một số cách sắp xếp cảm biến thông dụng

Cảm biến hồng ngoại bao gồm 2 kỹ xử lý thông tin là kỹ thuật xử lý thông tin cảm

biến dạng digital và kỹ thuật xử lý thông tin cảm biến dạng analog.

❖ Kỹ thuật xử lý thông tin cảm biến dạng digital

Phần này trình bày một kỹ thuật để xử lý thông tin thu thập từ cảm biến. Kỹ thuật

này phân biệt mức điện áp ra thành hai mức là mức cao và mức thấp (ví dụ: điện áp từ

0V − 2V là mức 0 còn từ 3V − 5V là mức 1). Sau khi phân tích xong, bộ xử lý sẽ dựa

vào một thư viện đã xây dựng sẵn để tìm ra vị trí của line. Kỹ thuật này cho tốc độ xử

CHƯƠNG 1: TỔNG QUAN VÀ LỰA CHỌN PHƯƠNG ÁN

lý nhanh nhưng kém chính xác.

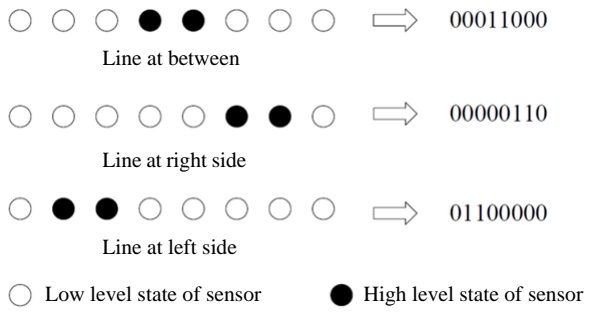
[picture p108: figure]

Line at between Line at right side Line at left side Low level state of sensor | High level state of sensor

Hình 1.12. Vị trí của line thông qua kỹ thuật xử lý digital

❖ Kỹ thuật xử lý thông tin cảm biến dạng analog

Không giống như kỹ thuật digital, kỹ thuật analog sử dụng trực tiếp giá trị ADC

để tính vị trí của line. Có hai dạng xử lý của kỹ thuật này: dạng xấp xỉ bậc hai và xấp xỉ

theo trọng số. Tuy tốc độ xử lý chậm hơn kỹ thuật digital nhưng bù lại kỹ thuật analog

cho độ chính xác cao hơn rất nhiều.

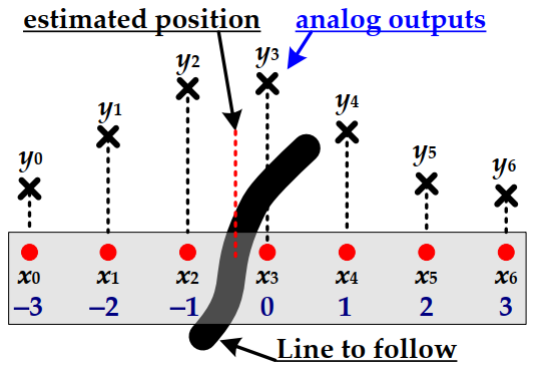
[picture p109: figure]
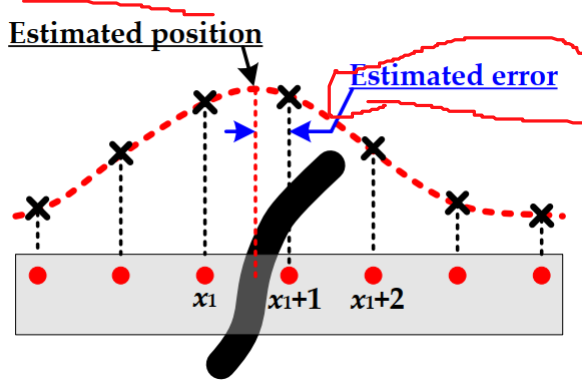
[picture p110: figure]

Xấp xỉ bậc 2 | Xấp xỉ theo trọng số

Hình 1.13. Giải thuật để tính toán vị trí của line trong kỹ thuật analog

Nhóm lựa chọn cảm biến hồng ngoại cùng với kỹ thuật xử lý thông tin cảm biến

dạng analog vì cảm biến hồng ngoại có tốc độ đáp ứng nhanh, phù hợp với mục tiêu

thiết kế. Ngoài ra, chi phí chế tạo một mạch cảm biến hồng ngoại cũng rẻ hơn so với chi

phí mua và chế tạo mạch cảm biến có gắn camera.

CHƯƠNG 1: TỔNG QUAN VÀ LỰA CHỌN PHƯƠNG ÁN

### 1.6. Lựa chọn cấu trúc điều khiển

Có hai cấu trúc chính cho bộ điều khiển: cấu trúc điều khiển phân cấp và cấu trúc

điều khiển tập trung.

Sensor

Driver | Microcontroller
Left motor | Encoder

Driver

Encoder | Right motor

Cấu trúc điều khiển tập trung

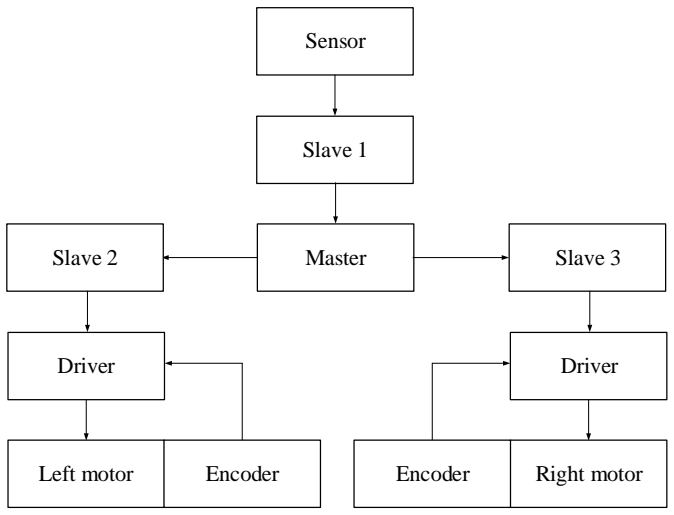
[picture p111: figure]
Sensor; Slave 1; Driver; Left motor; Encoder; Slave 2; Master; Right motor; Slave 3

Cấu trúc điều khiển phân cấp

Hình 1.14. Hai dạng cấu trúc điều khiển

Ở cấu trúc điều khiển tập trung, vi điều khiển trung tâm sẽ nhận dữ liệu từ cảm

biến, xử lý nó và xuất tín hiệu điều khiển các động cơ. Cấu trúc này dùng ít tài nguyên

và đơn giản nhưng nó đòi hỏi khả năng tính toán rất lớn của vi điều khiển chính và rất

khó để nâng cấp.

Ở bộ điều khiển phân cấp, nhiều vi điều khiển đóng vai trò tớ để xử lý các công

việc như xử lý dữ liệu cảm biến, điều khiển động cơ,… và giao tiếp hoặc nhận chỉ thị từ

một vi điều khiển trung tâm đóng vai trò là chủ. Các giao tiếp có thể sử dụng là giao tiếp

UART, I2C hoặc CAN,… Cấu trúc này giúp giảm khối lượng tính toán cho vi điều khiển

CHƯƠNG 1: TỔNG QUAN VÀ LỰA CHỌN PHƯƠNG ÁN

trung tâm và mỗi vi điều khiển tớ chỉ tập trung tính toán cho nhiệm vụ của nó. Cấu trúc

này dễ nâng cấp, nhưng tốn nhiều tài nguyên và dễ bị nhiễu hay mất dữ liệu khi truyền.

Nhóm lựa chọn cấu trúc điều khiển phân cấp vì:

- Giảm khối lượng công việc cho các vi điều khiển
- Dễ kiểm soát và sửa chữa cũng như nâng cấp chương trình điều khiển
- Các công việc thiết kế có thể được thực hiện song song

### 1.7. Lựa chọn giải thuật dò line

Đối với robot dò line, cách thông dụng nhất để điều khiển robot bám theo line là

tách riêng bộ điều khiển thành hai tầng điều khiển: tầng điều khiển cao là giải thuật để

robot bám line và tầng điều khiển thấp là giải thuật điều khiển các động cơ.

Động cơ DC là hệ SISO (Single Input – Single Output). Điều này có thể giải thích

rằng đầu vào của động cơ là điện áp cấp (hay pwm) còn đầu ra của động cơ là vận tốc

quay (RPM). Đối với hệ SISO, bộ điều khiển PID là thích hợp để sử dụng.

Đối với hệ robot dò line hoặc xét là robot di động, đây là một hệ MIMO (Multiple

Input – Multiple Output) với đầu vào của hệ là hai vận tốc góc của hai động cơ

(RPM1, RPM2) còn đầu ra của hệ là ba thông số trong hệ tọa độ Descartes: xA, yA,φ.

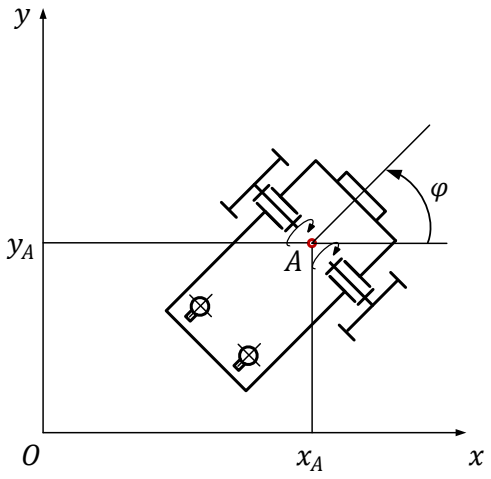
[picture p112: figure]

Hình 1.15. Vị trí robot trong hệ tọa độ Descartes

Đối với hệ MIMO, có các giải thuật để điều khiển là Fuzzy, Lyapunov hoặc bộ

điều khiển PD dựa theo thuật toán Linearization feedback.

CHƯƠNG 1: TỔNG QUAN VÀ LỰA CHỌN PHƯƠNG ÁN

Bảng 1.1. Ví dụ đơn giản cho luật điều khiển Fuzzy

Left LED | Mid LED | Right LED | State | Control output
0 | 1 | 0 | Middle | v = vr | ω = 0
1 | 0 | 0 | Left | v = vr | ω = −δω
0 | 0 | 1 | Right | v = vr | ω = δω
Different state | | | N/A | v = 0 | ω = 0
Giá trị của δ có thể được tìm qua mô phỏng.

Các luật điều khiển đều có ưu và nhược điểm nhưng chúng đều phục vụ một trong

hai mục đích điều khiển:

- Điều khiển cả v và ω để robot bám theo line
- Cố định vận tốc v = vmax, điều khiển ω để robot bám line

Nhóm lựa chọn bộ điều khiển PID vì nó phù hợp với động cơ DC đã chọn trong

phần cấu trúc cơ khí. Ngoài ra, bộ điều khiển PID cũng là bộ điều khiển có công dụng

rất rộng cùng với thuật toán điều khiển tương đối dễ hiểu và dễ lập trình.

CHƯƠNG 2: THIẾT KẾ CƠ KHÍ

THIẾT KẾ CƠ KHÍ

### 2.1. Lựa chọn bánh xe

### 2.1.1. Bánh chủ động

Khi lựa chọn bánh xe chủ động cần quan tâm đường kính và bề dày của bánh xe.

Đường kính và bề dày lớn sẽ giúp xe chạy nhanh hơn nhưng sẽ làm khối lượng xe tăng.

Tham khảo các mẫu bánh xe có sẵn trên thị trường, nhóm tác giả quyết định chọn bánh

xe cao su V65 có đường kính là 65mm và bề dày 25mm.

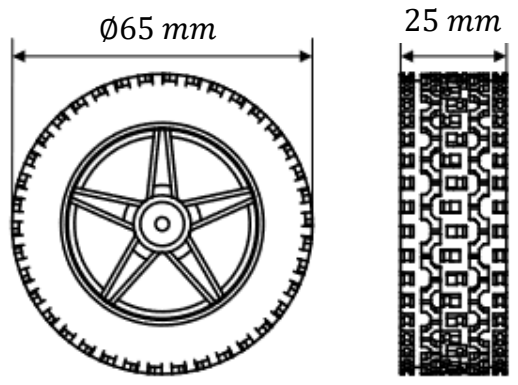
[picture p113: figure]

Hình 2.1. Bánh xe chủ động của robot dò line

### 2.1.2. Bánh bị động

Hai loại bánh bị động thường được sử dụng cho robot dò line là bánh tự lựa (bánh mắt trâu) và bánh caster. Nhóm tác giả lựa chọn bánh mắt trâu vì có khối lượng nhẹ hơn

các loại bánh tự lựa khác.

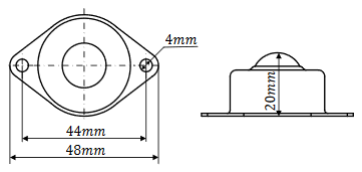
[picture p114: figure]

Hình 2.2. Kích thước bánh mắt trâu

CHƯƠNG 2: THIẾT KẾ CƠ KHÍ

### 2.2. Tính toán chọn động cơ dẫn động

Giả sử các thông số của robot dò line như sau:

- Vận tốc tối đa robot có thể đạt được là 0,6 m/s
- Khối lượng của robot là m = 2 kg
- Robot tăng tốc từ 0 đến 0,6 m/s trong 1 s. Do đó gia tốc của robot là a =

0,6 m/s

2

Lấy gia tốc trọng trường g = 9,81 m/s

2

Ta có: vmax = ωmax. rw = 0,6 m/s
Với rw = 32,5 mm = 0,0325 m là bán kính bánh dẫn.

Suy ra: ωmax =

vmax
rw

=

0,6
0,0325

= 18,46 (rad/s) = 176,29 (rpm)

Áp dụng các phương trình động học lên bánh xe dẫn động:

Fms

Fframe

P

Rz

Fa

Tm

Iwεw

Hình 2.3. Mô hình động lực học của bánh xe chủ động

Trong đó:

- Tm là moment xoắn của động cơ
- Ww là trọng lực của bánh xe và phần trọng lực của khung xe tác dụng lên bánh

chủ động

- Fframe là phản lực theo phương ngang do khung xe tác động lên bánh chủ động
- Fa là lực quán tính riêng của bánh xe
- Rz

là phản lực do mặt đất tác dụng lên bánh xe

- Fw là lực ma sát sinh ra do chuyển động của bánh xe
- Iwεw là thành phần quán tính xoay của riêng bánh xe

CHƯƠNG 2: THIẾT KẾ CƠ KHÍ

Dựa theo yêu cầu thiết kế, vận tốc xe trong suốt quá trình di chuyển chỉ đạt tối đa

là 0,6 m/s nên xem như xe không bị lật trong suốt quá trình chuyển động.

Do khối lượng xe nhỏ, bánh xe xem như không biến dạng khi xe di chuyển. Ta có

phương trình cân bằng động lực học cho bánh xe chủ động:
{
Fw = Fa + Fframe
P = Rz
Tm = Iwεw + Fwrw

(2.1)

Sử dụng phương trình cân bằng moment trong hệ phương trình (2.1), ta có:

Tm =

1
2

mw(rw

2 − rℎ

2
)εw + (Fframe + mwaw)rw
(2.2)

Trong đó:

- mw: khối lượng bánh xe chủ động
- aw: gia tốc dài bánh xe chủ động
- rw: bán kính bánh xe chủ động
- εw: gia tốc góc bánh xe chủ động
- rℎ: bánh kính lỗ lắp trục bánh xe vào trục động cơ

Do tâm bánh xe chủ động gắn chặt với trục động cơ, bánh xe chuyển động song

phẳng nên gia tốc của xe cũng chính là gia tốc dài của bánh xe chủ động, aw =

vmax
t

=

0,6
1

= 0,6 m/s

2
. Suy ra, gia tốc góc bánh xe chủ động:

εw =

aw
rw

=

0,6
32,5. 10⁻³ = 18,61 (rad/s

2
)

Lực do khung xe tác động lên bánh xe chủ động được tính bằng cách tháo rời bánh

xe chủ động khỏi trục và thay thế bằng các phản lực tác động lên robot.

Moving direction

Fa

Ftrac

P

Z1 Fr1

Hình 2.4. Các lực tác động lên thân robot

CHƯƠNG 2: THIẾT KẾ CƠ KHÍ

Các ngoại lực tác động lên robot ở hình 2.4 là:

- Fa: lực quán tính của cả robot, Fa = Mrobotaw
- G: trọng lượng của robot.
- Ftrac

: lực kéo tổng hợp do hai bánh chủ động sinh ra. khi robot di chuyển trên

đường thẳng thì Ftrac = 2Fframe.

- Fri

: lực ma sát tác dụng lên bánh xe thứ i, giả thiết khối lượng phân bố đều trên

các bánh, Fri = ZiC

- Zi

: phản lực do nền tác dụng lên bánh xe thứ i, giả thiết khối lượng phân bố đều

trên các bánh, Zi =

1
3

Mrobotg

Xét cân bằng lực theo phương ngang ta có:

Ftrac = Mrobot

. aw +

1
3
Mrobot. g. C | (2.3)

Với các thông số đầu bài: Mrobot = 2kg, aw = 0,6 m/s

2
, theo [10] hệ số ma sát

lăn C = 0.015, ta có:

Ftrac = 2.0,6 +

1
3

. 2.9,81 . 0,015

= 1,298 (N)

Suy ra:

Fframe =

1
2

Ftrac =

1
2

. 1,298 = 0,65 (N)

Thay các thông số vào phương trình (2.2) ta có:

Tm =

1
2

. 0,05. (32,5

2 − 5,5

2

). 10⁻⁶
. 18,61 + (0,65 + 0,05 . 0,6). 0,0325

= 0,0226 (Nm)

Khi robot vào cua, vận tốc góc động cơ có thể tăng lên, và momen xoắn có thể

thay đổi nên ta chọn hệ số an toàn = 1,5 . Do đó, vận tốc góc và momen xoắn động cơ

cần có là:

ω ≥ 176,29 . 1,5 = 264,45 (rpm)
Tm ≥ 0,0226 .1,5 = 0,0339 (Nm) = 0,339 (kgf. cm)

Với các thông số đã tính toán, nhóm tác giả lựa chọn động cơ GA25.

CHƯƠNG 2: THIẾT KẾ CƠ KHÍ

Thông số kỹ thuật của động cơ GA25:

- Tỉ số truyền: 1: 34
- Điện áp hoạt động: 3 − 12 VDC
- Tốc độ không tải: 320 rpm
- Dòng không tải: 80 mA
- Vận tốc có tải: 284 rpm
- Dòng có tải: 600 mA
- Momen hoạt động: 1,8 kgf. cm
- Độ phân giải encoder: 374 ppr

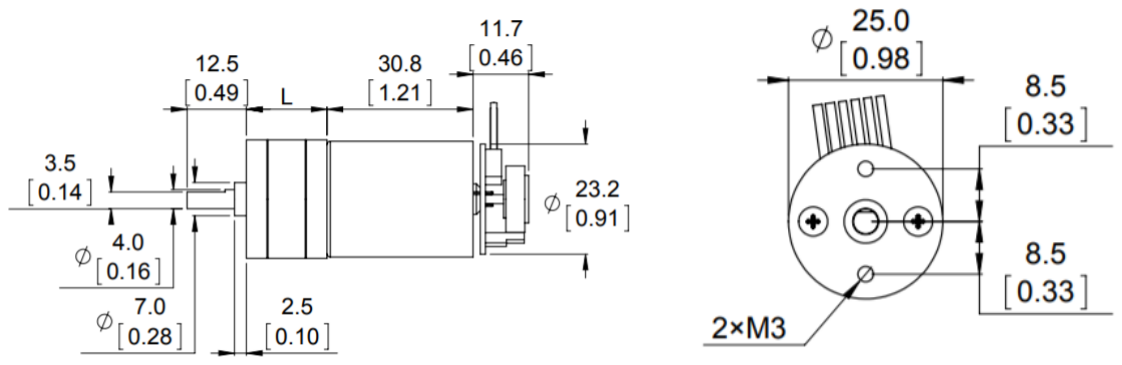
[picture p115: figure]

Hình 2.5. Kích thước động cơ GA25

### 2.3. Tính toán thiết kế khung xe

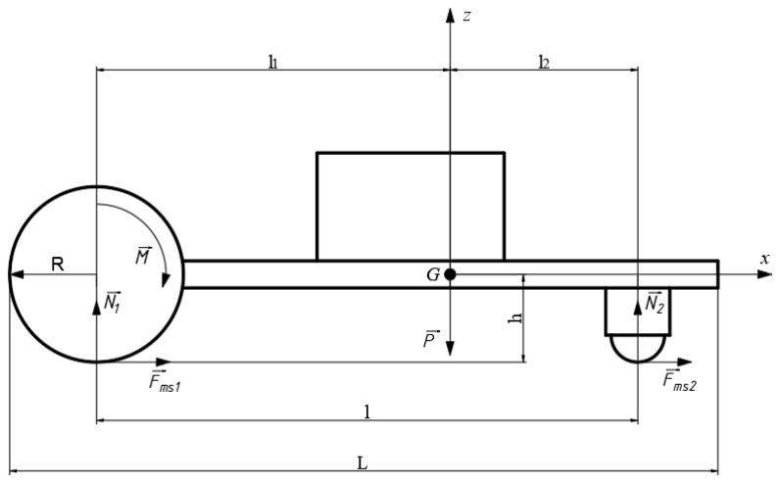
[picture p116: figure]

Hình 2.6. Sơ đồ phân tích động lực học của xe

CHƯƠNG 2: THIẾT KẾ CƠ KHÍ

Đặt giả thiết trọng tâm của cả khung xe sẽ nằm trên mặt phẳng đi qua trục bánh xe

và song song với mặt đất.

Dựa vào định luật 2 Newton và các phương trình cân bằng, ta có hệ phương trình

động lực học của xe như sau:

{

∑Fx = ma

∑Fy = 0

∑MG = 0

- {

Fms1 + Fms2 = ma
N1 + N2 = mg
N1

l1 − N2

l2 − Fms1ℎ − Fms2ℎ = 0

Ta lại có:

N1

l1 − N2

l2 = maℎ → a =

(mg − N2

)l1 − N2
l2
mℎ
Trong quá trình xe tăng tốc thì quan hệ giữa độ lớn gia tốc và các kích thước xe

phải đảm bảo giữ bánh trước của xe tiếp xúc với mặt đường. Do đó ta đó điều kiện:

N2 ≥ 0

Từ phương trình trên, suy ra đc N2 =

mgl1−maℎ
l1+l2

≥ 0

Với các thông số g = 9,81 m/s

2
, a = 0,6 m/s

2
thì để thỏa điều kiện trên khi thiết

kế khung xe phải đảm bảo chiều cao khung xe thỏa mãn tỉ số

ℎ
l1

≤

9,81
0,6

= 16.35

Do l1 nhỏ hơn chiều dài của khung xe nên và giả sử trọng tâm xem nằm trong

khoảng từ (0,1 ÷ 0,4)L (do khối lượng xe có xu hướng dồn về phía sau) thì khi thiết kế

phải chọn tỉ số giữa chiều cao và chiều dài khung xe nằm trong khoảng từ

(0,1 ÷ 0,4)L = 1,65 ÷ 6,54

Chiều cao h là tổng của chiều dài gá động cơ và bán kính bánh xe. Ta có chiều dài

gá động cơ mà nhóm sử dụng là 18,5 mm, do đó ℎ = 22,5 + 32,5 = 50 mm

Sau khi ước lượng bố trí mạch điện và các linh kiện điện tử trên khung xe, nhóm

chọn chiều dài khung xe là 225 mm.

Kiểm nghiệm lại điều kiện giữa chiều cao và khoảng cách, ta thấy

225
50

= 4,5 nên

CHƯƠNG 2: THIẾT KẾ CƠ KHÍ

thỏa điều kiện đã đặt ra.

### 2.4. Mô hình 3D

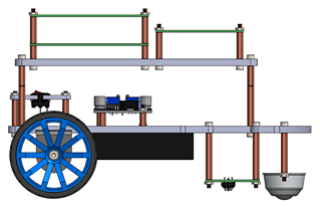
[picture p117: figure]

Hình chiếu đứng

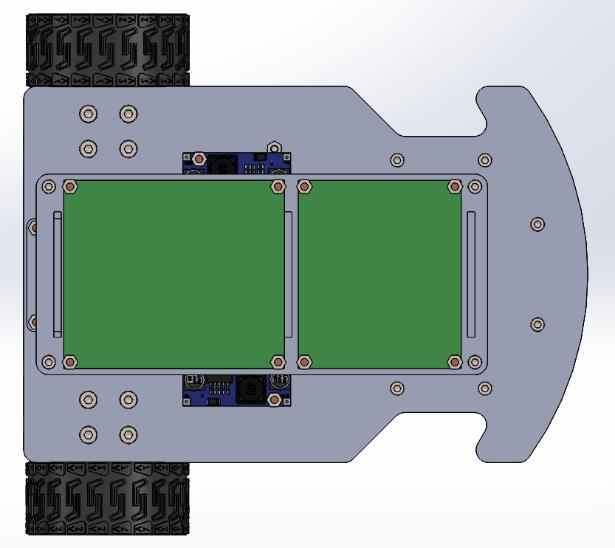
[picture p118: figure]

Hình chiếu bằng

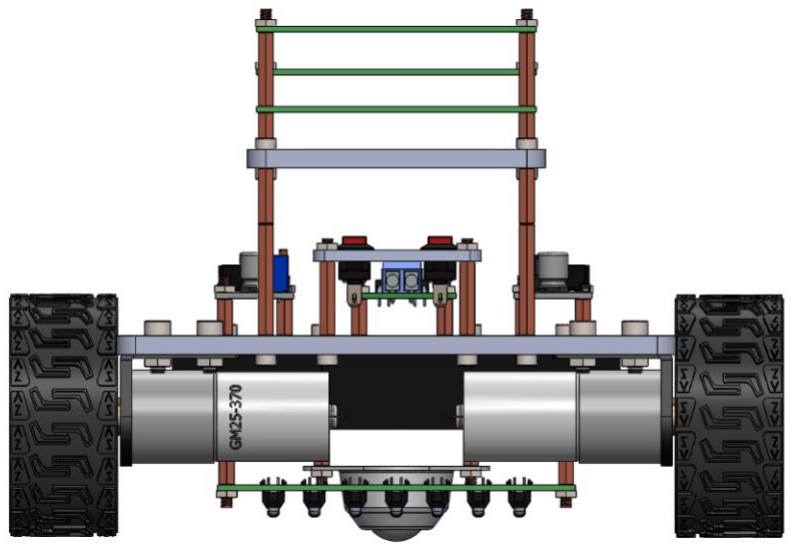
[picture p119: figure]

Hình chiếu cạnh

Hình 2.7. Mô hình 3D của xe

CHƯƠNG 3: THIẾT KẾ ĐIỆN

THIẾT KẾ ĐIỆN

### 3.1. Lựa chọn linh kiện

### 3.1.1. Cảm biến dò line

Yêu cầu: cảm biến có đầu phát LED hồng ngoại và đầu thu là phototransistor

So sánh:

Bảng 3.1. So sánh đặc tính kỹ thuật của TCRT5000 và TCRT1000

Tên cảm biến | TCRT5000 | TCRT1000 | Đơn vị
Kích thước (D x R x C) | 10,2 x 5,8 x 7 | 7 x 4 x 2,5 | mm
Phạm vi hoạt động | 0,2 - 15 | 0,2 - 4 | mm
Khoảng cách hoạt động tốt nhất | 2,5 | 1 | mm
Dòng điện đầu ra thông thường | 1 | 0,5 | mA

Kết luận: chọn cảm biến TCRT5000

### 3.1.2. Vi điều khiển

Dựa vào phương án điều khiển phân cấp mà nhóm đã chọn, yêu cầu 1 master và 2

slave để điều khiển 2 động cơ.

Yêu cầu:

- Master có timer để phục vụ việc điều phối giao tiếp giữa các vi điều khiển
- Master và Slave phải hỗ trợ các chuẩn giao tiếp thông dụng như UART, I²C, SPI
- Slave phải có bộ ngắt dùng cho việc đếm sự kiện để đọc encoder

Sau khi tìm hiểu, nhóm nhận thấy có các dòng vi điều khiển như Arduino, PIC16F,

STM32 thỏa các yêu cầu trên. Nhóm lựa chọn dòng PIC vì nhóm đã quen sử dụng vi

điều khiển dòng này. Cụ thể nhóm lựa chọn Master là vi điều khiển PIC16F877A, 2

CHƯƠNG 3: THIẾT KẾ ĐIỆN

Slave là vi điều khiển PIC16F73 do đây là các vi điều khiển mà nhóm có sẵn.

### 3.1.3. Driver

Yêu cầu:

- Vout, max > 12 V
- Iout, max > 1,3 A
- Tần số hoạt động của driver phải đủ lớn để hoạt động được với tần số của xung

PWM từ vi điều khiển (500 Hz)

Nhóm cân nhắc giữa driver L298N và driver TB6612

So sánh:

Bảng 3.2. Thông số kỹ thuật của driver L298N và TB6612

Đặc tính kỹ thuật | L298N | TB6612 | Đơn vị
Điện áp đầu ra, Vout | 6 – 35 | 15 | V
Dòng đầu ra, Iout | 2 | 3,2 | A
Tần số hoạt động, f | 40 | 100 | KHz

Kết luận: Nhóm lựa chọn driver cho động cơ là TB6612.

### 3.2. Lựa chọn chuẩn giao tiếp

Yêu cầu:

- Hỗ trợ giao tiếp giữa 1 Master và 2 Slave
- Tốt độ truyền tối thiểu là 8 kbps
- Hoạt động ổn định ở khoảng cách gần

Nhóm cân nhắc giữa 2 loại chuẩn giao tiếp là I²C và SPI. Chuẩn SPI có tốc độ

truyền cao hơn chuẩn I²C nhưng lại bị ảnh hưởng bởi nhiễu nhiều hơn.

CHƯƠNG 3: THIẾT KẾ ĐIỆN

- Kết luận: Chọn chuẩn giao tiếp là I²C

### 3.3. Thiết kế mạch cảm biến

### 3.3.1. Thông số kỹ thuật của cảm biến TCRT5000

Bảng 3.3. Thông số kỹ thuật của cảm biến RCRT5000

- Kích thước (L × W × H − mm) | 10,2 × 5,8 × 7
- Cao độ hoạt động (mm) | 0,2 − 15
- Dòng chịu lớn nhất | IC = 1mA,IFmax = 60mA
- Góc phát | 16⁰
- Góc thu | 30⁰
- Chức năng lọc nhiễu ánh sáng ban ngày | Có
- Bước sóng tia hồng ngoại | 950nm

### 3.3.2. Chọn số lượng cảm biến

Yêu cầu:

- Số lượng cảm biến phải vừa đủ để vừa đảm bảo độ phân giải cao, phạm vi phát

hiện rộng, vừa đảm bảo khối lượng xử lý không quá nhiều.

- Số lượng cảm biến phải là số lẻ để thuận lợi cho việc điều khiển.

Kết luận:

Nhóm tác giả lựa chọn số lượng cảm biến là 7.

### 3.3.3. Tính toán các điện trở trên mạch cảm biến

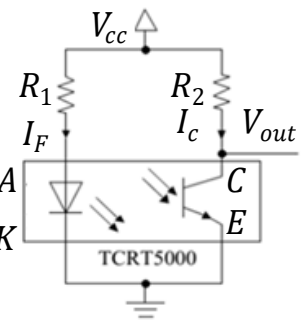
[picture p120: figure]
Vout; Vcc

A
K

Hình 3.1. Sơ đồ nguyên lý của một module cảm biến

CHƯƠNG 3: THIẾT KẾ ĐIỆN

Gọi VF là điện áp giữa hai điểm A, K. Theo tài liệu [5], VF = 1,25 V, kết hợp với

điều kiện về dòng của cảm biến IF < 60 mA, ta tính được điện trở R1
là:

R1 =

Vcc − VF
IF

>

5 − 1,25
60 . 10⁻³ = 62,5 Ω | (3.1)

Chọn R1 = 330 Ω, suy ra IF = 11,4 mA.

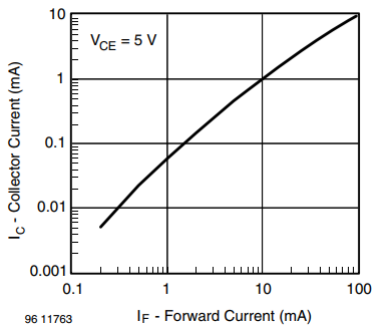
[picture p121: figure]

Hình 3.2. Đồ thị mối quan hệ giữa IC và IF [5]

Dựa vào hình 3.2, suy ra IC = 1,1 mA.

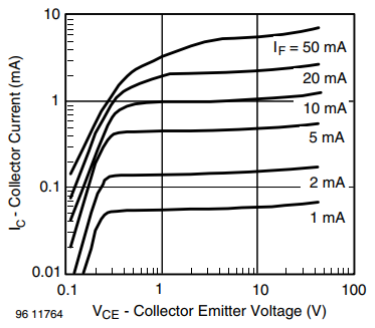
[picture p122: figure]

Hình 3.3. Đồ thị mối quan hệ giữa VCE và IC [5]

Với IC = 1,1 mA và IF = 11,4 mA, dựa vào hình 3.3, ta suy được VCE = 1 V (điện

áp giữa hai điểm C, E).

Với VCE = 1 V, điện trở R2 được tính theo công thức:

CHƯƠNG 3: THIẾT KẾ ĐIỆN

R2 =

Vcc − VCE
IC

>

5 − 1
1,1 . 10⁻³ = 3636,7 Ω | (3.2)

Chọn R2 = 3,9 kΩ.

### 3.3.4. Khảo sát khoảng cách đến mặt sa bàn của cảm biến

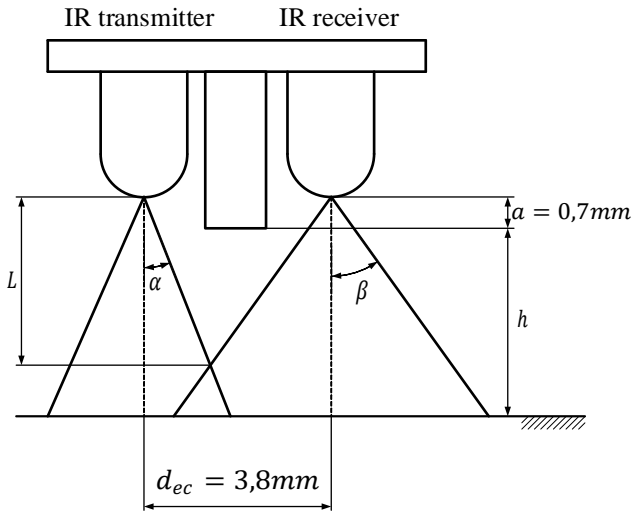
[picture p123: figure]
IR transmitter; IR receiver; dec

Hình 3.4. Mô hình cao độ từ cảm biến đến sa bàn

Dựa vào hình 3.4, cao độ L được tính toán:

L =

dec
tan α + tan β

=

3,8
tan 16⁰ + tan 30⁰ = 4,4 mm

(3.3)

Vậy cao độ nhỏ nhất của cảm biến tới sa bàn là:

ℎmin = L − 0,7 = 4,4 − 0,7 = 3,7 mm | (3.4)

Dựa vào cao độ nhỏ nhất ℎmin, cao độ phù hợp được khảo sát qua thực nghiệm.

Trong thí nghiệm, module cảm biến được gá thẳng đứng và di chuyển cao dần so với

nền sa bàn. Nền sa bàn được sử dụng là nền trắng và nền đen.

Thí nghiệm được thực hiện như sau:
- Bước 1: Gá cảm biến ở độ cao phù hợp so với nền sa bàn
- Bước 2: Di chuyển cảm biến dọc theo nền đen rồi nền trắng để đọc kết quả

analog trả về

- Bước 3: Thay đổi độ cao của cảm biến so với sa bàn, sau đó lặp lại bước 2

CHƯƠNG 3: THIẾT KẾ ĐIỆN

- Bước 4: Sau khi thử hết các độ cao trong khoảng hoạt động của cảm biến,

thay bằng cảm biến khác và lặp lại từ bước 1 cho đến khi đủ số cảm biến.

Kết quả khảo sát được trình bày trong hình dưới đây:

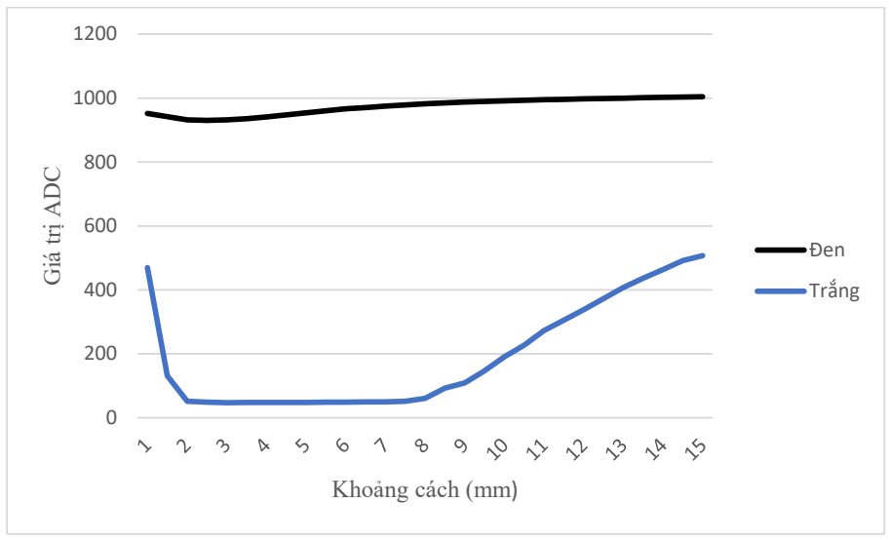
[picture p124: figure]
Giá trị ADC; Khoảng cách (mm); Đen; Trắng

Hình 3.5. Kết quả khảo sát cao độ phù hợp

Dựa vào hình 3.5, tại cao độ 8 mm, độ chênh lệch về giá trị ADC của cảm biến

đọc về tại nền trắng và nền đen là cao nhất nên cao độ phù hợp để lắp cảm biến là 8 mm.

### 3.3.5. Khảo sát khoảng cách giữa hai cảm biến phù hợp

Khoảng cách giữa hai cảm biến cần được chọn để hai cảm biến không giao thoa

với nhau và trả về kết quả phù hợp.

Thí nghiệm được thực hiện như sau:
- Bước 1: gá hai cảm biến ở cùng cao độ 8 mm so với nền sa bàn.
- Bước 2: dịch chuyển cảm biến thứ nhất từ tâm line ra xa 20 mm, đọc giá trị

ADC.
- Bước 3: cố định cảm biến thứ nhất, dịch chuyển cảm biến thứ hai ra xa

20 mm, đọc giá trị ADC cảm biến thứ hai.

- Bước 4: thay đổi cảm biến và lặp lại các bước như trên.

CHƯƠNG 3: THIẾT KẾ ĐIỆN

Step 1
Step 2
0 | 2 | 4 | 6 | 8 | 10 | 12 | 14 | 16 0

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
1000

18 20

Hình 3.6. Kết quả khảo sát khoảng cách giữa 2 cảm biến

Dựa vào kết quả khảo sát ở hình 3.6, khoảng cách phù hợp giữa hai cảm biến là từ

13 − 18 mm, chọn 13 mm.

### 3.3.6. Thiết kế và chế tạo cảm biến

Sau khi xác định được các thông số về kích thước của mạch cảm biến, sơ đồ nguyên

lý mạch cảm biến và mô hình 3D được dựng lên sau đây.

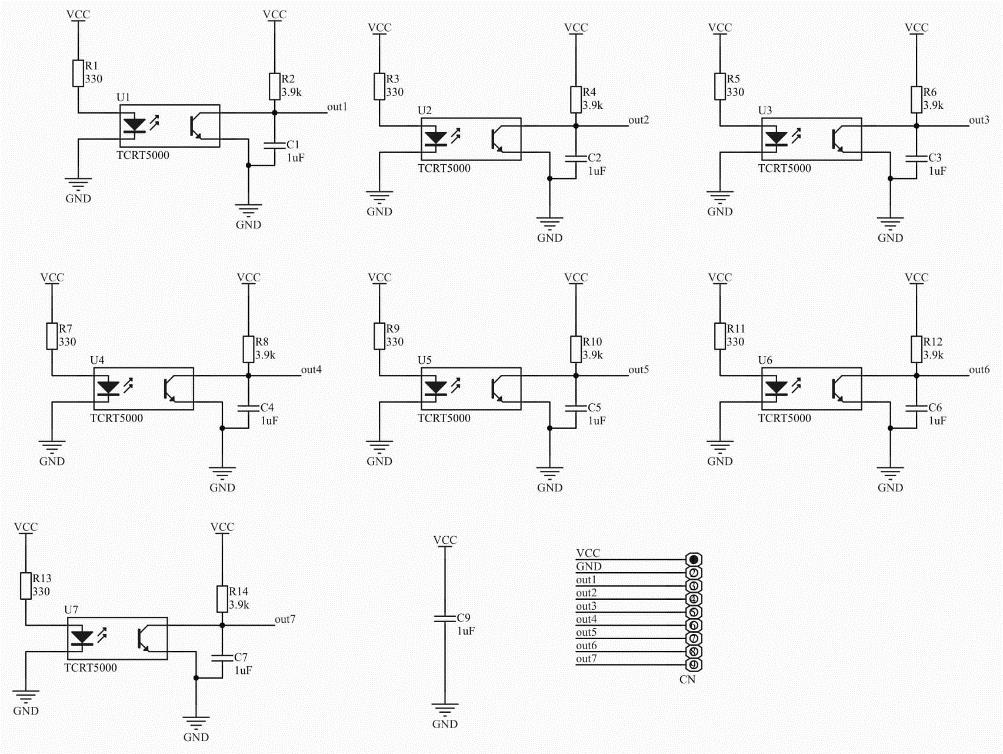
[picture p125: figure]

Hình 3.7. Sơ đồ nguyên lý của dãy cảm biến

Khoảng cách (mm)

Giá trị ADC

CHƯƠNG 3: THIẾT KẾ ĐIỆN

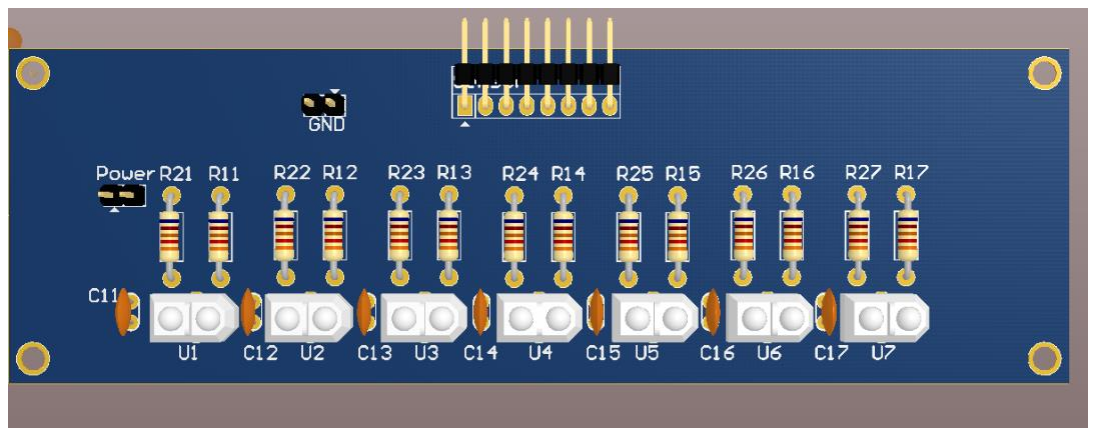
[picture p126: figure]

Hình 3.8. Mô hình 3D của cảm biến

### 3.3.7. Calib cảm biến

Vì các giá trị ADC của từng cảm biến khi hoạt động là khác nhau, phụ thuộc vào

áp cấp và điều kiện test nên cần calib để đưa các giá trị đó về cùng một khoảng.

Phương trình calib như sau:

yj
i

= ymin +

ymax − ymin

xmaxi − xmini

. (xj
i

− xmini

) | (3.5)

Trong đó:

- xmaxi

, xmini

– giá trị ADC lớn nhất và nhỏ nhất của cảm biến thứ i.

- ymax, ymin – giá trị ADC ngưỡng trên và ngưỡng dưới của khoảng đo.
- xj
i

– giá trị ADC của cảm biến thứ i ngay tại thời điểm đọc.

- yj
i

– giá trị sau khi calib.

Giá trị ADC ngưỡng trên và ngưỡng dưới được quy ước là ymax = 900, ymin =

50. Công thức calib cho từng cảm biến được trình bày dưới bảng sau đây:

Bảng 3.4. Công thức calib cho từng cảm biến

Sensor | xmini | xmaxi | yj0
x1 | 399 | 912 | yj0 = 50 + 1.6569(xj1 – 399)
x2 | 444 | 929 | yj0 = 50 + 1.7525(xj2 – 444)
x3 | 501 | 942 | yj0 = 50 + 1.9274(xj3 – 501)
x4 | 400 | 938 | yj0 = 50 + 1.9274(xj4 – 501)

CHƯƠNG 3: THIẾT KẾ ĐIỆN

Đặt cảm biến tại 3 vị trí so với đường line: nền trắng, nền đen, vùng giao giữa nền

trắng và nền đen, đọc giá trị ADC trả về của từng cảm biến tại 3 vị trí

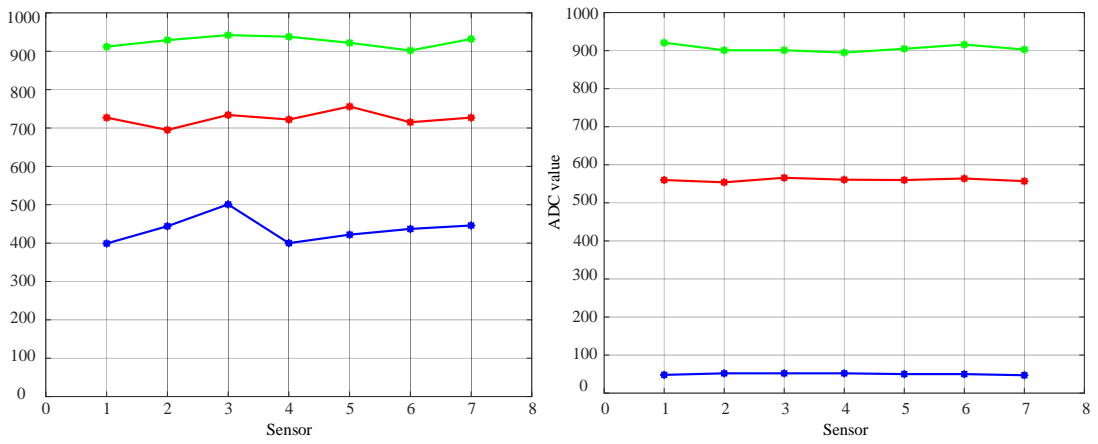
[picture p127: figure]
Sensor; ADC value 1000

ADC value

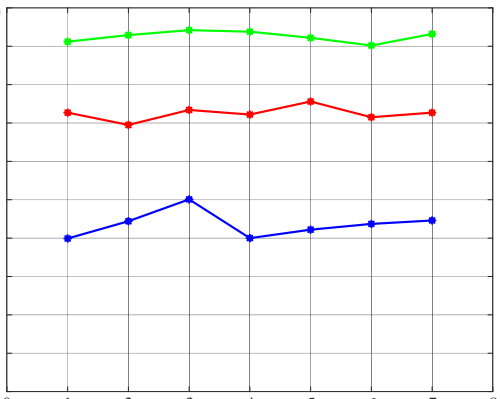
[picture p128: figure]

Hình 3.9. Kết quả các giá trị cảm biến trước và sau khi calib

Giải thuật dùng để xử lý dữ liệu từ cảm biến là giải thuật xấp xỉ trọng số. Phương

trình tính ra khoảng cách tâm cảm biến và tâm line như sau:

x =

∑ xi
. yi

n
i=1
∑ yi

n
i=1
d | (3.6)

Trong đó:

- xi

là trọng số của cảm biến so với line

- yi

là giá trị ADC đọc về của cảm biến thứ i

- x là tọa độ tâm cảm biến so với tâm line
- d là khoảng cách giữa 2 cảm biến

Kết quả test cảm biến được trình bày trong hình dưới đây:

x5 | 422 | 922 | yj0 = 50 + 1.7(xj5 – 422)
x6 | 437 | 902 | yj0 = 50 + 1.828(xj6 – 437)
x7 | 446 | 932 | yj0 = 50 + 1.749(xj7 – 446)

CHƯƠNG 3: THIẾT KẾ ĐIỆN

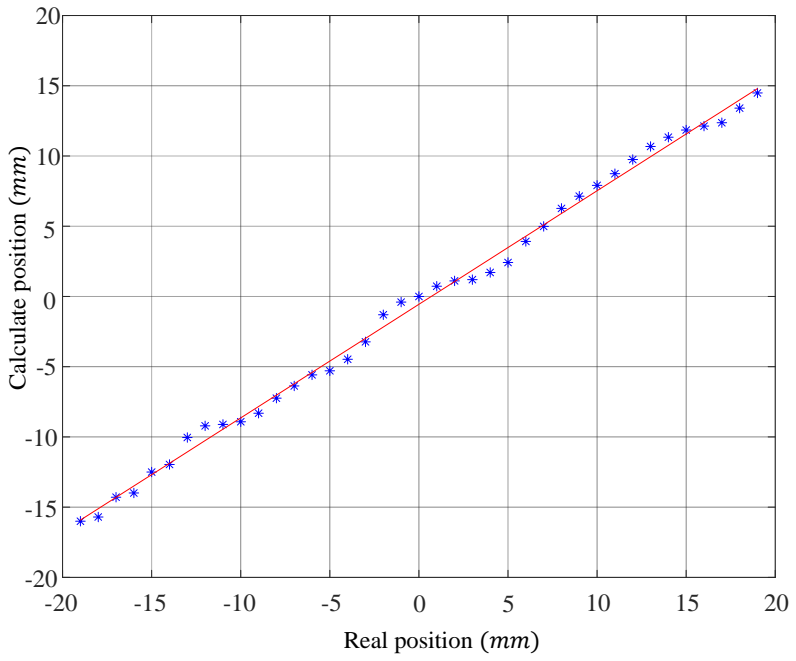
[picture p129: figure]
Real position (mm); Calculate position (mm)

Hình 3.10. Đồ thị quan hệ giữa vị trí thực và vị trí tính toán của tâm

đường line so với tâm cảm biến

Ta tìm được hàm nội suy bậc nhất mối quan hệ giữa vị trí thực của line và vị trí do

cảm biến tính toán là:

y = 0,8084x − 0,5577 | (3.7)

Tuy nhiên, trong quá trình thực nghiệm thì với mỗi địa điểm thực nghiệm sẽ có

điều kiện ánh sáng khác nhau nên mỗi lần thực nghiệm phải calib lại cảm biến lại vị trí

đó. Ta thấy trong hình 3.10 sai lệch lớn nhất của tâm line có giá trị gần 5 mm. Thực hiện

che chắn cảm biến khi chạy thực nghiệm sẽ làm giảm sai lệch này.

### 3.4. Tính toán mạch công suất

Bảng 3.5. Dòng và áp cần thiết cho mạch công suất

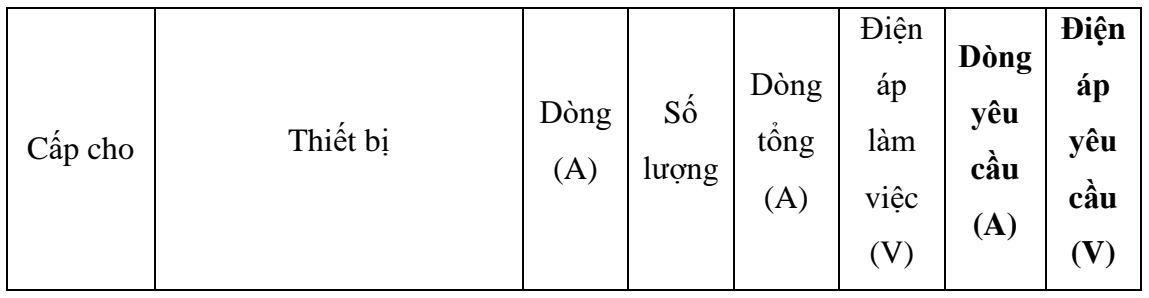
[picture p130: figure]
Cấp cho; Thiết bị; Dòng; lượng; tổng; Điện; làm; việc; yêu; cầu

CHƯƠNG 3: THIẾT KẾ ĐIỆN

Mạch động lực | DC motor + driver L298N | 1,3 | 2 | 1,3 | 12 | 2,6 | 12
Mạch điều khiển | Cảm biến TCRT5000 | 0,02 | 7 | 0,14 | 5 | 0,2 | 5
| PIC16F73 | --- | 2 | --- | 5
| Encoder | --- | 2 | --- | 3.3
| PIC16F887 | --- | 1 | --- | 5

Đối với mạch động lực, ta cấp nguồn 12 V và dòng cần thiết là 2,6 A. Đối với

mạch điều khiển, ta cấp nguồn 5 V, còn dòng cần thiết không đáng kể.

Nhóm sử dụng pin 18650 có điện áp ngưỡng là 3,7 V, khi sạc đầy có thể đạt 4 V,

dung lượng 2500 mAh, dòng xả tối đa 20 A.

Để tạo nguồn 12 V, nhóm sử dụng 4 pin (có thể đạt 16 V) kết hợp với mạch giảm

áp LM2596 giảm xuống 12 V để cấp nguồn cho mạch động lực.

Để tạo nguồn 5 V, nhóm sử dụng 2 pin (có thể đạt 8 V) kết hợp với mạch giảm áp

LM2596 giảm xuống 5 V để cấp nguồn cho mạch điều khiển.

CHƯƠNG 4: MÔ HÌNH HÓA HỆ THỐNG

MÔ HÌNH HÓA HỆ THỐNG

Dựa theo yêu cầu đề bài, ta thấy robot dò line chỉ chạy trên bề mặt phẳng, nghĩa là

những ngoại lực gần như không thay đổi trong quá trình chuyển động. Mặt khác, theo

đầu bài thiết kế, ta chỉ quan tâm đến vận tốc của robot khi đi trên sa bàn và vị trí của

robot so với đường line. Do đó, nhóm lựa chọn phân tích động học cho robot.

### 4.1. Phương trình động học của robot

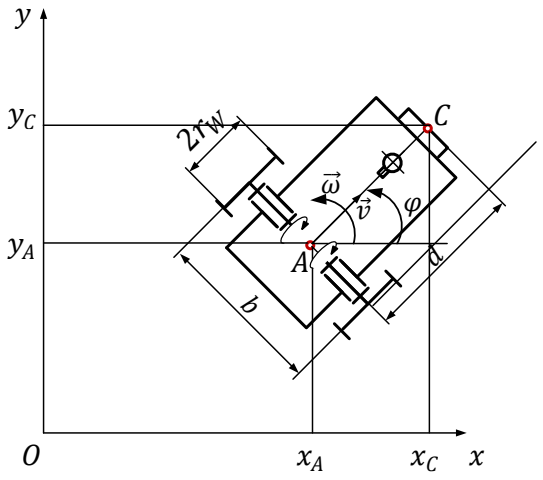
[picture p131: figure]

Hình 4.1. Trạng thái của robot trong hệ tọa độ Oxy

Gọi A là trung điểm của đoạn thẳng nối hai tâm bánh xe, điểm C là tâm của cảm

biến và là điểm track của robot. Các thông số về kích thước b, d, rw được định nghĩa

trên hình 4.1. v , ω lần lượt là vận tốc dài và vận tốc góc của robot trong hệ tọa độ Oxy.

Phương trình động học của robot viết tại điểm A là:
[

ẋA
ẏA
φ̇

] = [

cos φ 0
sin φ 0
0 1

][
v
ω
] | (4.1)

Từ các quan hệ hình học xC = xA + d. cos φ , yC = yA + d. sin φ và φc = φ ta có

phương trình động học viết tại điểm track C là:
[

ẋc
ẏA
φ̇

] = [

ẋA − φ̇. d. sin φ
ẏA + φ̇. d. cos φ
ω
] | (4.2)

CHƯƠNG 4: MÔ HÌNH HÓA HỆ THỐNG

### 4.2. Khảo sát đặc tính động cơ

Đối với động cơ DC thông thường, hàm truyền biểu diễn mối quan hệ giữa tín hiệu

điện áp cấp cho động cơ và tốc độ góc của trục là một hàm bậc hai. Điều này có hai khó

khăn chính trong việc mô hình hóa động cơ:

- Khó khăn trong việc đo các thông số nội của động cơ như Rdc, Ldc, hệ số giảm

chấn bdc

- Mối quan hệ giữa đầu vào và đầu ra cho mục đích điều khiển vận tốc là bậc hai

gây khó khăn cho việc điều khiển

Đề giải quyết khó khăn đó, phương pháp khảo sát hộp đen được sử dụng với cách

làm như sau:

- Kết hợp động cơ và một mạch driver để giúp tuyến tính hóa hàm truyền của động

cơ
- Xem hệ động cơ + driver là một hộp đen để khảo sát đáp ứng với các tín hiệu cấp

từ đó xấp xỉ hàm truyền của hệ đó

### 4.2.1. Xác định tần số lấy mẫu và số mẫu cần lấy

Tốc độ lớn nhất của động cơ qua hộp số khi không tải: ωmax = 320 (rpm)

Þ

Tốc độ lớn nhất của động cơ khi không tải: ωmax = 320.34 = 10880 (rpm)

Chọn sai số điều khiển tốc độ động cơ là 5% → 544 (rpm)

Do đó cần phải chọn thời gian lấy mẫu sao cho trong khoảng thời gian lấy mẫu này

số xung đọc được lớn nhất là 9 xung.

Þ

Chu kỳ nhỏ nhất của tín hiệu gốc là Tℎ = 0,11 (s)

Để khôi phục được tín hiệu thì thời gian lấy mẫu Ts ≤

Tℎ
2

= 0,055 (s)

Þ

Chọn Ts = 0,01 (s)

Xác định số mẫu cần lấy (dựa theo tiêu chuẩn Nyquist) là:

nδt = mT → n =

m.0,05
0,01

= 5m (Với m là số nguyên).

Þ

Chọn: n = 20
Þ

m = 100 mẫu.

### 4.2.2. Khảo sát khoảng tuyến tính động cơ

CHƯƠNG 4: MÔ HÌNH HÓA HỆ THỐNG

Sử dụng vi điều khiển PIC16F73 cấp xung cho driver và đếm xung trả về từ kênh

A của động cơ, ta vẽ được đồ thị sau:

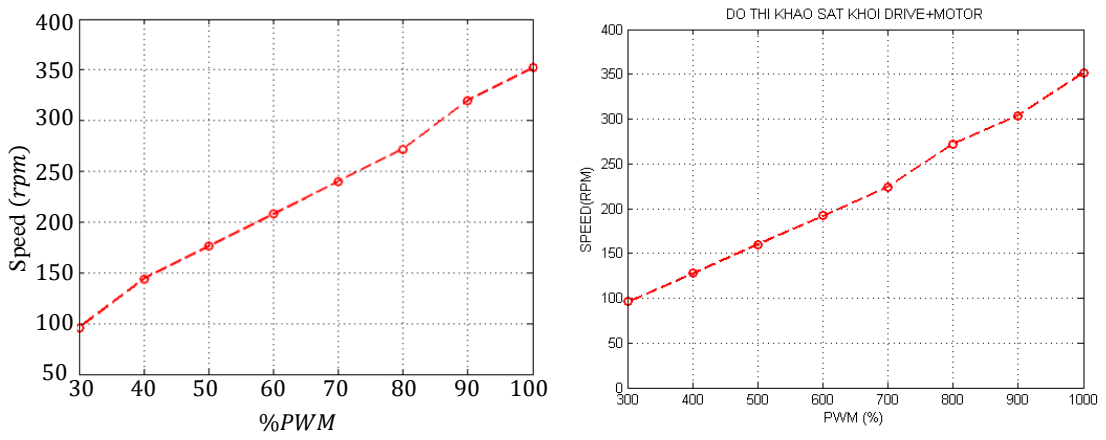
[picture p132: figure]
%PWM; Speed (rpm)
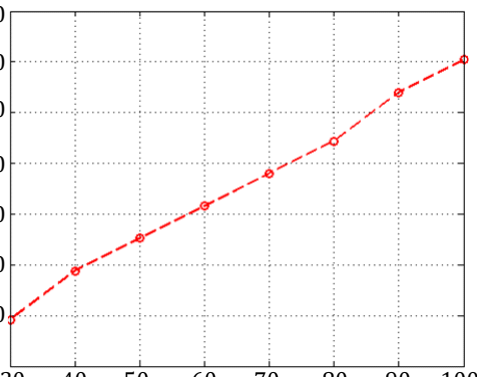
[picture p133: figure]

a. Khối driver + động cơ 1 | b. Khối driver + động cơ 2

Hình 4.2. Đồ thị khảo sát khối driver + động cơ

Dựa vào đồ thị biểu diễn, ta thấy mối liên hệ giữa đầu vào (%PWM) và đầu ra

(rpm) gần như tuyến tính.

### 4.2.3. Khảo sát đáp ứng để tìm hàm truyền động cơ

Hàm truyền của động cơ có thể được ước lượng bằng “System Identification

Toolbox” trong phần mềm Matlab thông qua giá trị đầu vào và giá trị đáp ứng đầu ra củ

động cơ.
Miêu tả quy trình: Đầu vào là một giá trị cố định. Để tăng tính thuyết phục, ta sẽ

khảo sát với những giá trị cố định khác nhau. Đầu tiên, nhóm cho đầu vào là 100%PWM

0

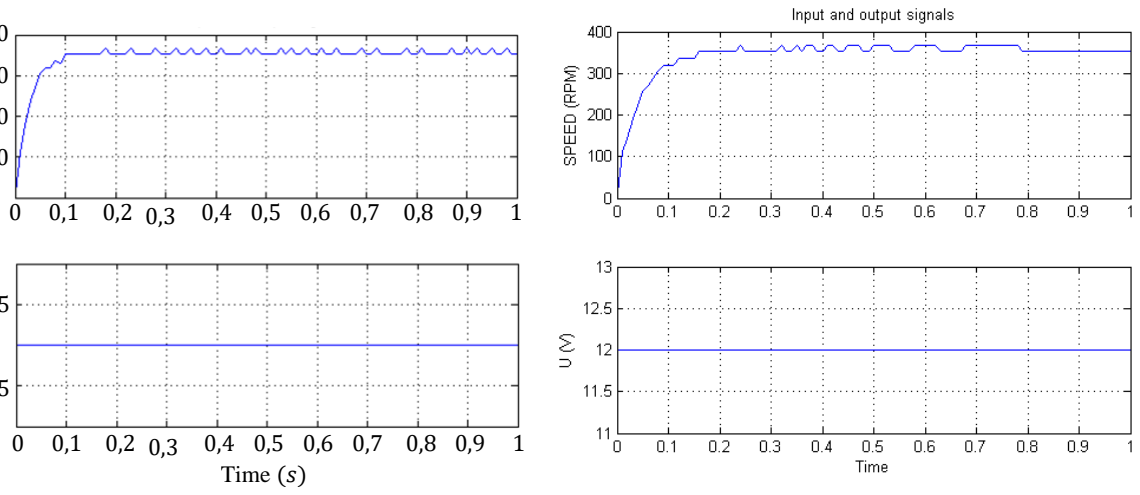
[picture p134: figure]
0 0,1 0,2 0,3 0,4 0,5 0,6 0,7 0,8 0,9 1 Time (s)

# 100 200 300 400 Speed ⁽rpm⁾

11 11,5

12

12,5

13

U (V)

a. Động cơ 1 | b. Động cơ 2

Hình 4.3. Đáp ứng động cơ với đầu vào 100% PWM

CHƯƠNG 4: MÔ HÌNH HÓA HỆ THỐNG

Sử dụng Tool System Identification của MATLAB:

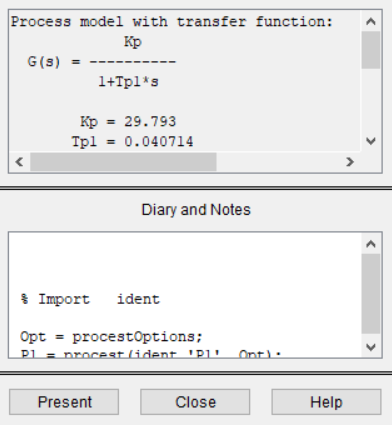
[picture p135: figure]
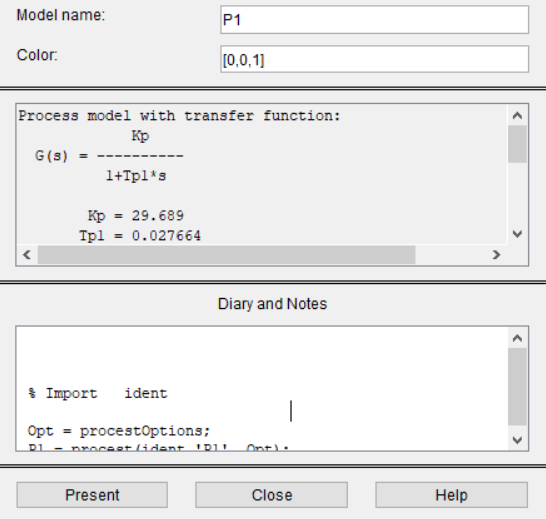
[picture p136: figure]

a. Động cơ 1 | b. Động cơ 2

Hình 4.4. Hàm truyền tìm được bằng “System Identification Toolbox”

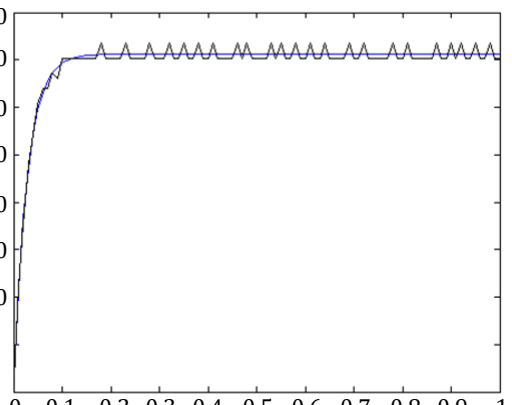
[picture p137: figure]

0 0,1 0,2 0,3 0,4 0,5 0,6 0,7 0,8 0,9 1

# 50 100 150 200 250 300 350 400 Speed ⁽rpm⁾

0

Time (s)

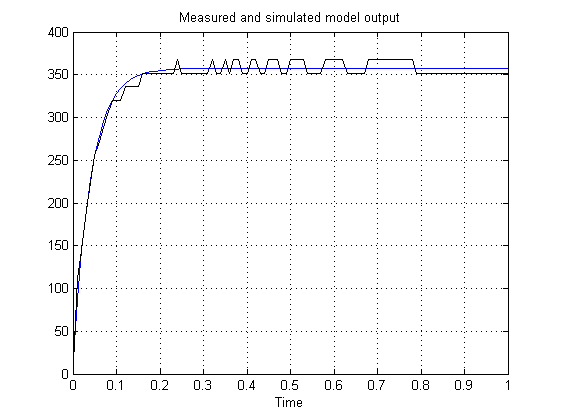
[picture p138: figure]

a. Động cơ 1 | b. Động cơ 2

Hình 4.5. Mức độ chính xác của hàm truyền vừa tìm so với giá trị đáp ứng đầu

ra của động cơ

Lặp lại các bước trên với giá trị đầu vào 60% PWM (là vận tốc động cơ chạy), ta

được:

Bảng 4.1. Hàm truyền tìm được với giá trị cố định 60% PWM

Giá trị đầu vào (%PWM)

Hàm truyền động cơ 1

tìm được

Hàm truyền động cơ 2

tìm được

CHƯƠNG 4: MÔ HÌNH HÓA HỆ THỐNG

60% PWM

30,184
0,026848s + 1

29,141
0,044255s + 1

CHƯƠNG 5: THIẾT KẾ BỘ ĐIỀU KHIỂN

THIẾT KẾ BỘ ĐIỀU KHIỂN

### 5.1. Thiết kế bộ điều khiển PID cho động cơ

### 5.1.1. Tiêu chí thiết kế bộ điều khiển

Với các hàm truyền tìm được, nhóm sử dụng hàm truyền động cơ 2 Gdc(s) =

29.141
0,044255s+1

để thiết kế bộ điều khiển PID. Các chỉ tiêu cho bộ điều khiển như sau:

- Độ vọt lố POT ≤ 10%
- Thời gian xác lập ts ≤ 0,1 s
- Sai số xác lập ≤ 5%

### 5.1.2. Tính toán hàm truyền bộ điều khiển

Mô hình của hệ gồm bộ điều khiển PID và động cơ như sau:

+
GPID | Gdc
R(s) | ω(s)

Hình 5.1. Mô hình của hệ điều khiển

Hàm truyền của bộ điều khiển PID:

GPID = Kp +

Ki
s
+ Kds | (5.1)

Hàm truyền của động cơ có dạng:

Gdc =

K
Ts + 1

(5.2)

Phương trình đặc trưng của hệ kín:

1 + GPID. Gdc = 0 | (5.3)

1 + (Kp +

Ki
s

+ Kds) . (

K
Ts + 1

) = 0

CHƯƠNG 5: THIẾT KẾ BỘ ĐIỀU KHIỂN

s

2 +

1 + KKp
T + KKd

. s +

KKi
T + KKd

= 0

Phương trình đặc trưng của hệ là dạng bậc hai, vì vậy đáp ứng của hệ sẽ có dạng giống với đáp ứng của hệ dao động bậc hai.

Từ chỉ tiêu độ vọt lố, ta có:

POT = e

−

ξπ
√1−ξ
2
. 100% = 10% | (5.4)

Suy ra: ξ = 0,59.

Từ chỉ tiêu thời gian xác lập, tính theo tiêu chuẩn 2%, ta có:

ts =

3
ξ. ωn
= 0,1s | (5.5)

Suy ra: ωn = 50,85.

Với ξ = 0,59; ωn = 50,85 thì dạng của phương trình đặc trưng của hệ là:

s

2 + 2ξωns + ωn

2 = 0 | (5.6)

Đồng nhất hệ số với (4.3) ta được hệ phương trình sau:

{

1 + KKp
T + KKd

= 2ξωn

KKi
T + KKd

= ωn

2

(5.7)

Ta nhận thấy hệ (5.7) là hệ phương trình 3 ẩn – 2 phương trình nên cần chọn trước

một nghiệm để giải. Qua khảo sát, nhóm nhận thấy Kp = 0,4 là phù hợp với động cơ

nên chọn Kp = 0,4. Thế K = 29.141 ; T = 0,044255

Với Kp = 0,4; giải hệ (5.7) ta được: Ki = 18,7174,Kd = 0,00572.

Vậy, bộ điều khiển PID có hàm truyền là:

GPID = 0,4 +

18,7174
s
+ 0,00572. s | (5.8)

Thực hiện tương tự cho động cơ 2, các hệ số của bộ điều khiển PID của động cơ 2

là: Kp = 0,4 , Ki = 18,7174,Kd = 0,00572.

50 100 150 200 2500

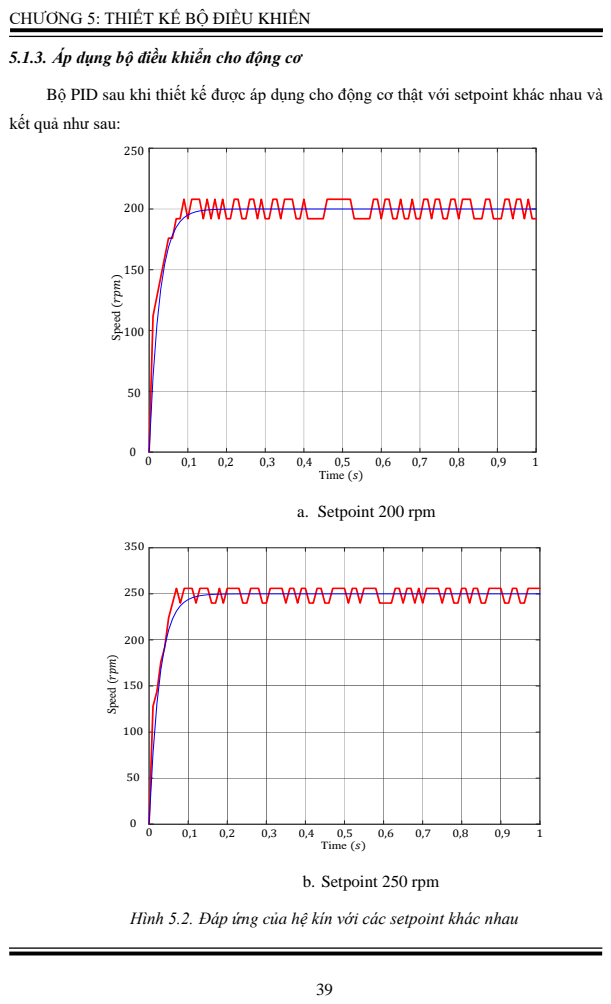
[picture p139: page 49]
Speed (rpm); Time (s); a. Setpoint 200 rpm; b. Setpoint 250 rpm

CHƯƠNG 5: THIẾT KẾ BỘ ĐIỀU KHIỂN

5.1.3. Áp dụng bộ điều khiển cho động cơ

Bộ PID sau khi thiết kế được áp dụng cho động cơ thật với setpoint khác nhau và
kết quả như sau:

Hình 5.2. Đáp ứng của hệ kín với các setpoint khác nhau

CHƯƠNG 5: THIẾT KẾ BỘ ĐIỀU KHIỂN

Nhận xét:

- Setpoint càng lớn (200 ÷ 300 rpm) thì độ vọt lố càng nhỏ (5 ÷ 8%); Với

dải tốc độ thấp 100 rpm ÷ 150 rpm thì vọt lố cao.

- Thời gian đáp ứng của động cơ nằm trong khoảng 0,08s ÷ 0,1 s.
- Sai số xác lập 2% - 5%

Kết luận: Bộ điều khiển PID đã thiết kế phù hợp với các yêu cầu đặt ra.

### 5.2. Thiết kế luật điều khiển

Đối với bài toán tracking của mobile robot, luật điều khiển được thiết kế để robot

có thể bám theo một quỹ đạo được robot tham khảo vạch ra trong hệ tọa độ. Ở trong đồ

án này, nhóm sử dụng luật điều khiển dạng hồi tiếp tuyến tính vì các lý do sau:

- Cảm biến sử dụng chỉ có thể đo độ lệch theo phương ngang của robot
- Tốc độ chạy lớn, đòi hỏi thời gian xử lý nhanh

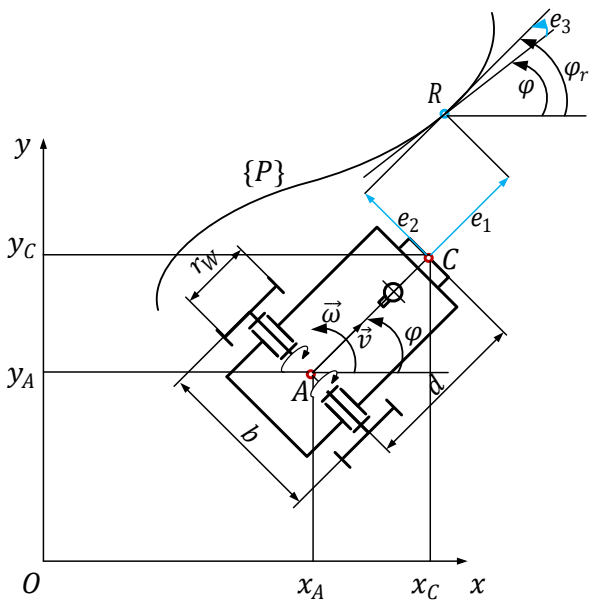
[picture p140: figure]

Hình 5.3. Mô hình động học của robot

Giả sử, có một robot tham khảo P với điểm R là điểm tham chiếu vẽ nên trong mặt

phẳng quỹ đạo {P} là quỹ đạo cần track. Robot tham khảo sẽ di chuyển với vận tốc

không đổi là vr = vmax (vmax là vân tốc đua cực đại của robot đang thiết kế), tạo ra các

vận tốc góc tham chiếu là ωr(t) và hướng tham chiếu là φr

. Để robot track được theo

quỹ đạo thì các sai số về vị trí và hướng e1
, e2

, e3 được tạo ra và được trình bày trên hình

CHƯƠNG 5: THIẾT KẾ BỘ ĐIỀU KHIỂN

5.3, luật điều khiển được thiết kế nhằm 2 mục đính chính sau:

- Luật điều khiển tác động vào robot để làm cho ei → 0, i = 1̅,3̅ khi t → ∞.
- Luật điều khiển giúp robot đạt được vận tốc vr

Phương trình động học của điểm tham chiếu R của robot tham khảo là:
[

ẋr
ẏr
φ̇r

] = [

cos φr | 0
sin φr | 0
0 | 1

][
vr
ωr
] | (5.9)

Phương trình các sai số viết trong hệ tọa độ robot là:
[

e1
e2
e3

] = [

cos φ sin φ 0
− sin φ cos φ 0
0 | 0 | 1

][

xr − xc
yr − yc
φr − φ
] | (5.10)

Đạo hàm hai vế phương trình (4.4), ta được:
[

ė1
ė2
ė3

] = [

vr

. cos e3
vr

. sin e3
ωr

] + [

−1 | e2
0 | −d − e1
0 | −1

][
v
ω
] | (5.11)

Đặt đầu vào sơ khởi usk = [v ω]

T
. Dựa vào hình 4.2 và phương trình (5.11), ta có điểm cân bằng của hệ phi tuyến (5.11) là: X0 = [e10 e20 e30]

T = [0 0 0]

T khi đầu vào là

Usk0 = [vr ωr

]

T
. Tuyến tính hóa hệ (5.11) xung quanh điểm cân bằng X0 với đầu vào

Usk0
ta được:
[

ė1
ė2
ė3

] = [

0 | −ωr | −vr
−ωr | 0 | vr
0 | 0 | 0

][

e1
e2
e3

] + [

−1 | 0
0 | −d
0 | −1

][
v
ω
] | (5.12)

Trong thực tế, việc đo đạt e1

là không cần thiết nhờ giả sử robot chuyển động với

vận tốc v = vr

. Do đó giả sử e1 ≈ 0. Thu gọn (5.12) và đặt lại luật điều khiển chỉ điều

khiển ω là u = ω ta được:
[

ė2
ė3

] = [

0 vr
0 0

][

e2
e3

] + [

−d
−1
] u | (5.13)

Phương trình (5.13) là phương trình không gian trạng thái dạng x = Aẋ + Bu, bài

toán trở thành thiết kế luật điều khiển hồi tiếp u = −Kx cho hệ.

CHƯƠNG 5: THIẾT KẾ BỘ ĐIỀU KHIỂN

Kiểm tra tính điều khiển được của hệ:

M = [B AB] = [

0 vr
vr | 0
] → rank(M) = 2 ≠ 0 | (5.14)

Vậy hệ điều khiển được.

Đặt K = [K1 K2

]

Phương trình đặc trưng của hệ:

|sI − A + BK| = 0 →

2
2 | 1 r | r
s | k v s k v − | − | = 0 | (5.15)

Phân tích phương trình (5.15) về dạng
2 | 2 2 | 0 n | n
s | s + | + | = ξω | ω | , đồng nhất thức ta có
{

2ξωn = −k2vr
ωn

2 = −k1vr

(5.16)

Độ vọt lố mong muốn là 10% nên ξ = 0,59

Thời gian xác lập ts = 0,1 s nên theo tiêu chuẩn 2% ωn =

4
ξts

= 67,8

Từ luật điều khiển u = −Kx = −k1x1−k2x2 , thay phương trình x1

̇ = x2
ta được

u = −k1x1−k2x1

̇ → u = −

k1
a

e −

k2
a
e | (5.17)

Đặt KP = −

k1
a

, KD = −

k2
a

, phương trình (5.17) trở thành u = KPe+KDė

Từ công thức (5.16), ta có

{

k2 = −

2ξωn
vr

= −80,004

k1 = −

ωn

2
vr

= −4596,84

(5.18)

Với a = d = 225, từ (5.18) ta suy ra KP = 20,43, KD = 0,355, vậy luật điều

khiển PD cho robot dò theo line là u = ω = 20,43e + 0,355ė

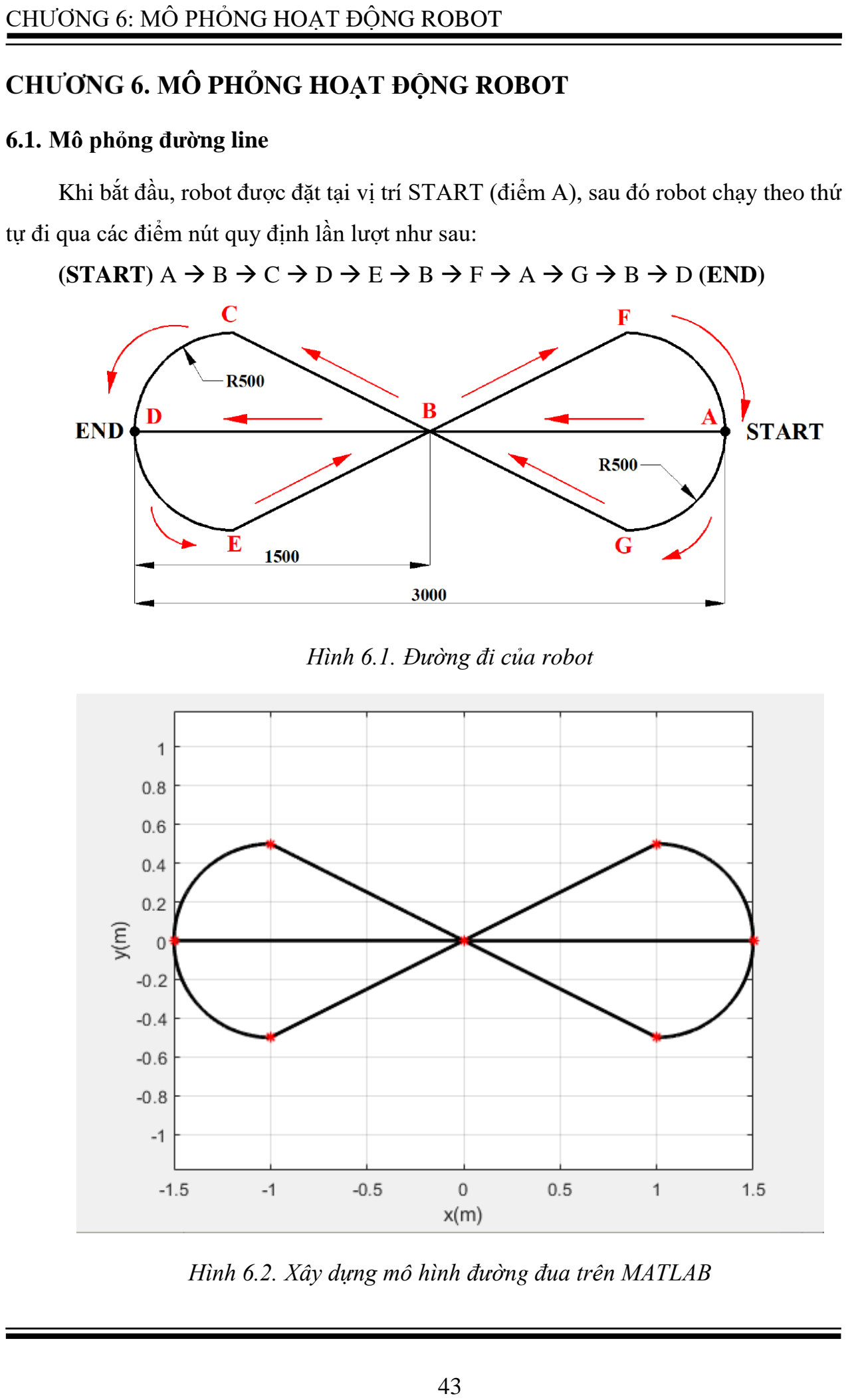
[picture p141: page 53]

CHƯƠNG 6: MÔ PHỎNG HOẠT ĐỘNG ROBOT

MÔ PHỎNG HOẠT ĐỘNG ROBOT

### 6.1. Mô phỏng đường line

Khi bắt đầu, robot được đặt tại vị trí START (điểm A), sau đó robot chạy theo thứ

tự đi qua các điểm nút quy định lần lượt như sau:

(START) A → B → C → D → E → B → F → A → G → B → D (END)

Hình 6.1. Đường đi của robot

Hình 6.2. Xây dựng mô hình đường đua trên MATLAB

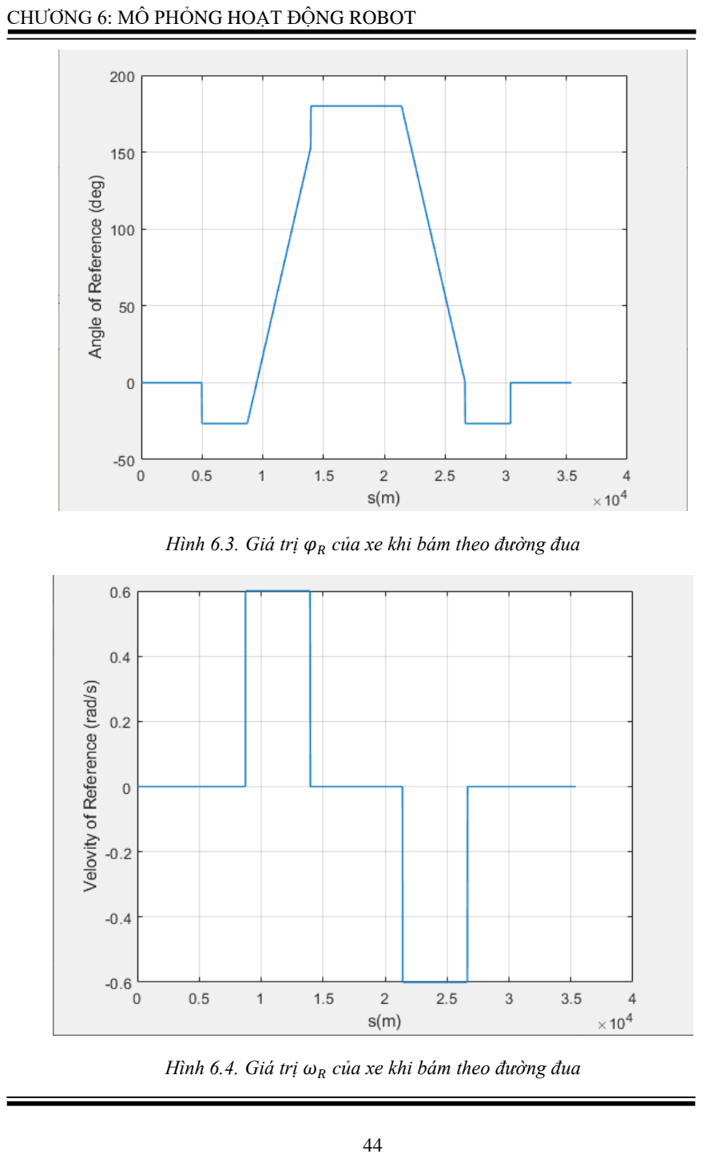
[picture p142: page 54]

CHƯƠNG 6: MÔ PHỎNG HOẠT ĐỘNG ROBOT

Hình 6.3. Giá trị φR của xe khi bám theo đường đua

Hình 6.4. Giá trị ωR của xe khi bám theo đường đua

CHƯƠNG 6: MÔ PHỎNG HOẠT ĐỘNG ROBOT

### 6.2. Mô phỏng robot dò line theo đề bài yêu cầu

Các thông số được sử dụng để mô phỏng hoạt động của robot dò line đi theo yêu

cầu đề bài:

Bảng 6.1. Bảng thông số mô phỏng

Vận tốc xe vr | 0,6 | m/s
Thời gian lấy mẫu | 0,001 | s
Thời gian lấy mẫu cảm biến | 0,1 | s
Thời gian lấy mẫu động cơ | 0,01 | s

Phần này trình bày kết quả mô phỏng robot dò line theo luật điều khiển và giải

thuật điều khiển đã thiết kế. Phần mềm mô phỏng được sử dụng là MATLAB.

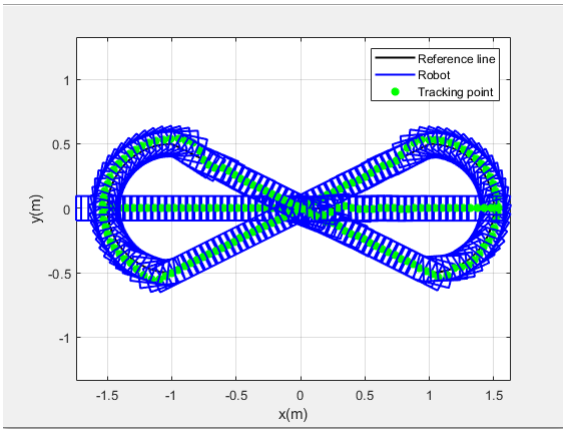
[picture p143: figure]

Hình 6.5. Kết quả robot bám theo line

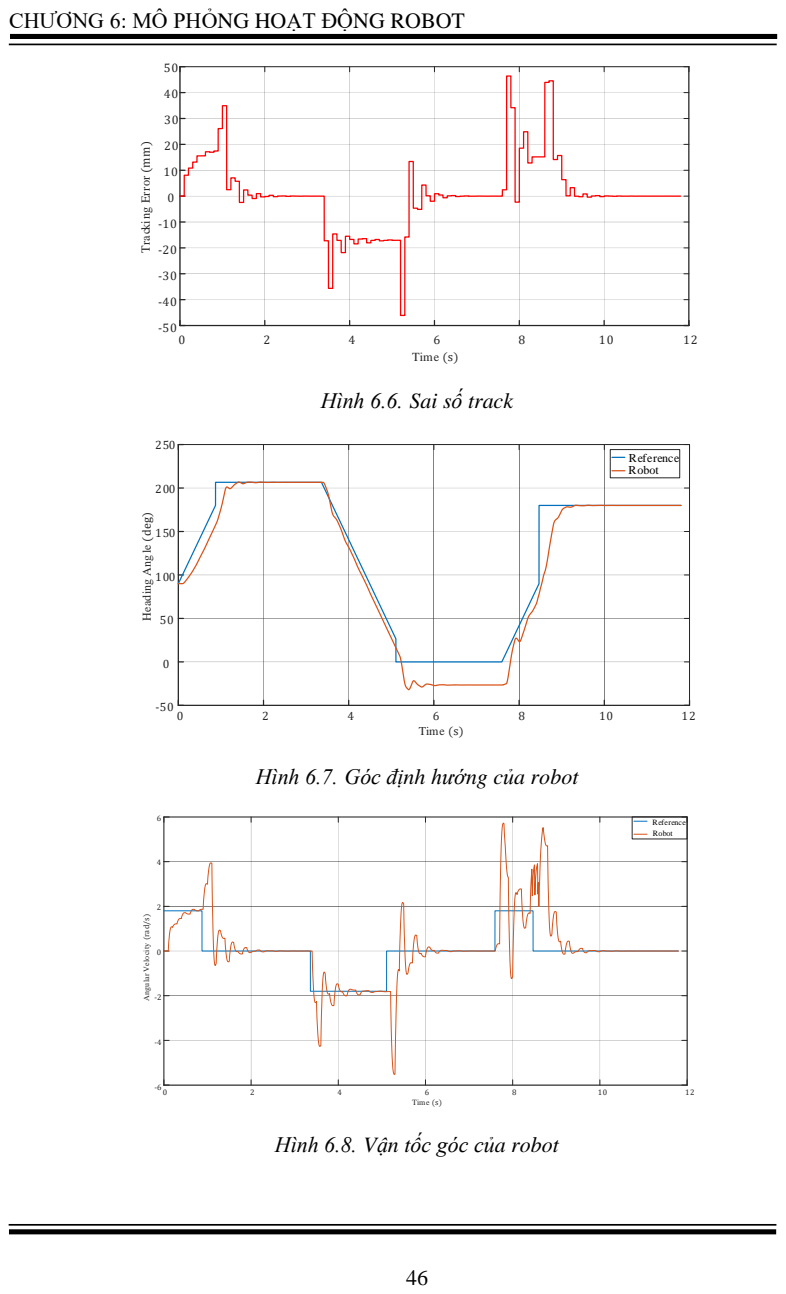
[picture p144: page 56]
Time (s); Reference Robot

CHƯƠNG 6: MÔ PHỎNG HOẠT ĐỘNG ROBOT

Tracking Error (mm)

Hình 6.6. Sai số track

Head ing Ang le (deg)

Hình 6.7. Góc định hướng của robot

Angular Velocity (ra d/s)

Hình 6.8. Vận tốc góc của robot

CHƯƠNG 6: MÔ PHỎNG HOẠT ĐỘNG ROBOT

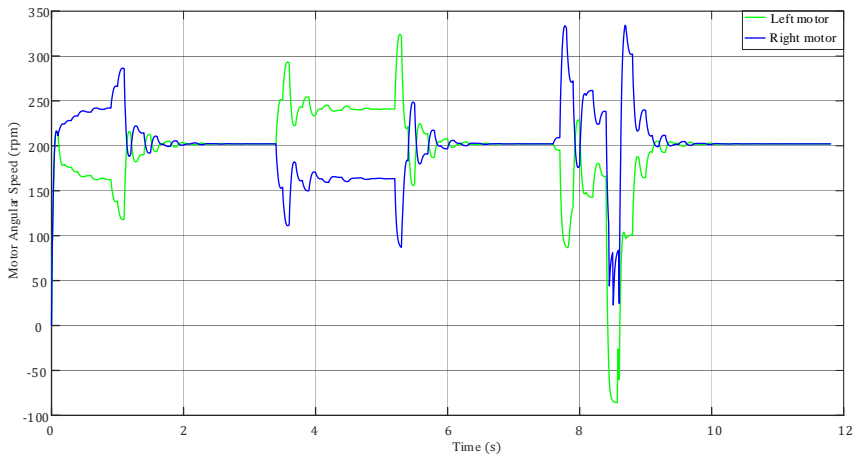
[picture p145: figure]
Left motor; Right motor; Time (s) Motor Angular Speed ⁽rpm⁾

Hình 6.9. Vận tốc góc của hai động cơ

Nhận xét:

- Đồ thị sai số track có dạng bậc thang vì được biểu diễn theo dạng rời rạc với thời

gian lấy mẫu là thời gian lấy mẫu của cả robot Tsys, giữa hai khoảng lấy mẫu thì

hệ thống không đo sai số.

- Sai số track lớn nhất trong cả quá trình bám line là 46,4 mm
- Trong quá trình chạy trên đường thẳng, sai số track dao động rất nhỏ ±2 mm và

bằng 0 sau khi ổn định. Trong quá trình chạy trên đường cong, sai số xác lập ổn

định ±15 mm (khi chạy trên đường cong thì sai số xác lập cần khác 0 để duy trì

tốc độ góc giúp robot đổi hướng). Sai số bị vọt lên tại các điểm đổi hướng bất

ngờ: từ khúc cua vào đường thẳng, từ đường thẳng vào cua nhưng sai số vọt lố đó

nhanh chóng giảm xuống mức độ ổn định

Kết luận:

Vậy bộ điều khiển và giải thuật điều khiển đã thiết kế cho kết quả tốt và đạt yêu

cầu thiết kế.

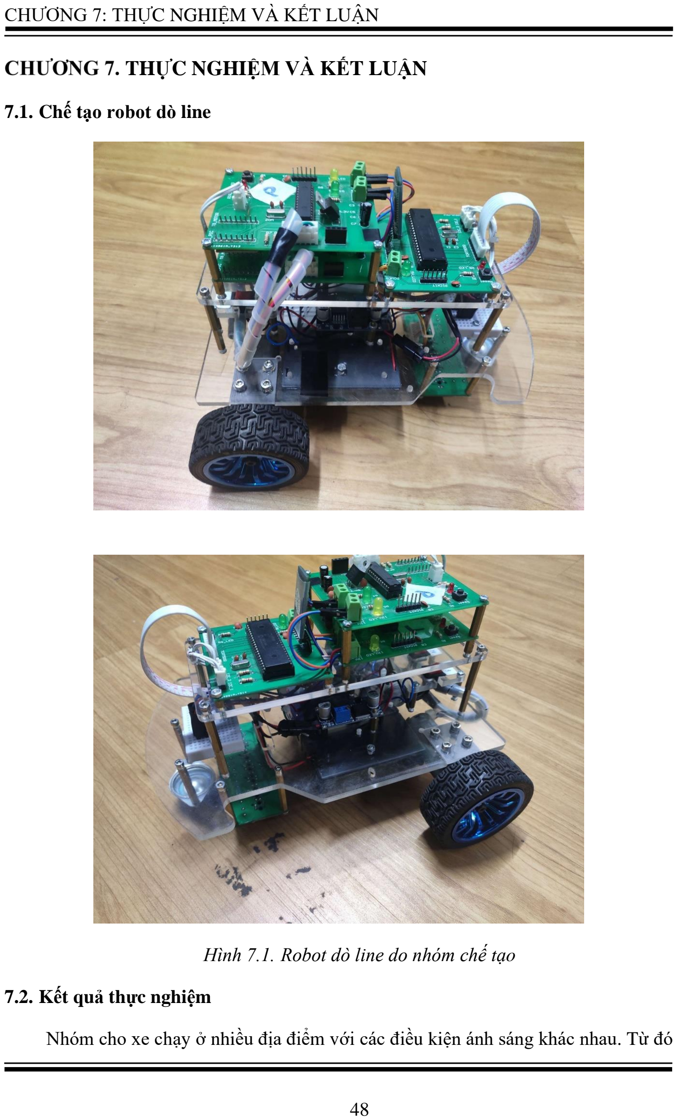
[picture p146: page 58]

CHƯƠNG 7: THỰC NGHIỆM VÀ KẾT LUẬN

THỰC NGHIỆM VÀ KẾT LUẬN

### 7.1. Chế tạo robot dò line

Hình 7.1. Robot dò line do nhóm chế tạo

### 7.2. Kết quả thực nghiệm

Nhóm cho xe chạy ở nhiều địa điểm với các điều kiện ánh sáng khác nhau. Từ đó

CHƯƠNG 7: THỰC NGHIỆM VÀ KẾT LUẬN

nhóm ghi nhận một số kết quả như sau:

- Vận tốc nhanh nhất robot di chuyển trên sa bàn là 0,4 m/s
- Thời gian robot hoàn thành sa bàn nhanh nhất mà nhóm ghi nhận lại được là 28 s,

với tổng chiều dài di chuyển trên sa bàn là 10,614 m thì tốc độ trung bình của xe

trong quá trình di chuyển là vtb =

10,614
28

= 0,379 (m/s), so với yêu cầu đề bài

vận tốc tối thiểu là 0,2 m/s thì quá trình thực nghiệm cho thấy xe đã đạt yêu cầu

về vận tốc của đề bài

- Trong quá trình xe chạy trên sa bàn, xe vẫn còn bị rung lắc, đặc biệt là ở các đoạn

cua từ đường thẳng sang đường cong

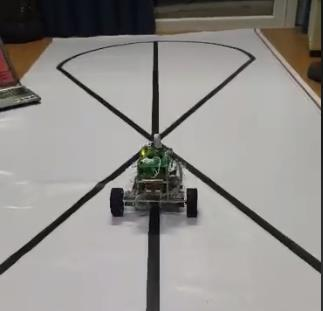
[picture p147: figure]

Hình 7.2. Xe ở trạng thái ổn định, chuẩn bị qua nút giao

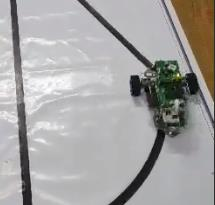
[picture p148: figure]

Hình 7.3. Xe qua điểm chuyển giữa đường thẳng và đường cong

CHƯƠNG 7: THỰC NGHIỆM VÀ KẾT LUẬN

Nhận xét kết quả thực nghiệm:

- Vận tốc khi thực nghiệm thấp hơn so với vận tốc mô phỏng, sai số cũng cao hơn

so với sai số khi mô phỏng. Nguyên nhân do khi mô phỏng đã bỏ qua các yếu tố

như: khối lượng của xe, ma sát giữa bánh xe và sa bàn, sai số đồng trục của hai

bánh xe, nhiễu từ môi trường ảnh hưởng đến ánh sáng và độ phẳng của động cơ,…

- Nhóm nhận thấy do chiều dài của mạch cảm biến thiết kế còn ngắn nên dẫn đến

những đoạn chuyển trạng thái xe bị mất ổn định, có khả năng vượt ra khỏi đường

line
- Với mỗi địa điểm thực nghiệm cần calib lại cảm biến. Việc calib chưa hiệu quả

làm xe chạy không ổn định và dễ vượt khỏi line.

### 7.3. Kết luận và đề xuất

Thông qua Đồ án môn học Thiết kế hệ thống Cơ Điện Tử, nhóm đã hiểu được

nguyên lý hoạt động của robot dò line cũng như chế tạo thành công mô hình robot dò

line. Tuy nhiên, kết quả thực nghiệm có nhiều sai lệch so với lý thuyết và kết quả mô

phỏng. Do đó, nhóm đưa ra một số đề xuất để cải thiện hoạt động của robot dò line:

- Tăng chiều dài mạch cảm biến để bắt line tốt hơn
- Thiết kế bộ phận che chắn cảm biến tốt hơn để hạn chế tối đa ảnh hưởng từ môi

trường
- Phát triển thuật toán để cảm biến tự calib ứng với các điều kiện ánh sáng khác

nhau khi hoạt động
- Tối ưu giải thuật dò line, đặc biệt là ở nút giao và các điểm chuyển giữa đường

thẳng và đường cong

TÀI LIỆU THAM KHẢO

TÀI LIỆU THAM KHẢO

[1] Tan Tien Nguyen, Thanh Tung Tran, Sang Bong Kim, Mechatronics System

Design through Project – A Case Study, VCM 2016
[2] Trần Thanh Tùng, “Nghiên cứu, thiết kế robot dò line theo phương pháp thiết

kế hệ thống cơ điện tử”, Trường Đại học Bách Khoa

[3] Website: http://dani.foroselectronica.es/silvestre-uxbot-line-following-

champions-148/

[4] Website: https://www.pololu.com/blog/487/brandons-line-following-robot-

the-chariot (https://www.pololu.com/blog/487/brandons-line-following-robot-the-chariot)

[5] TCRT5000 datasheet
[6] PIC16F877A datasheet
[7] PIC16F73 datasheet
[8] Nguyễn Thị Phương Hà, Lý thuyết điều khiển hiện đại
