Kevinchu77/MobileRobot/0.1.Hardware/0.1.Solidworks/sensor_mid/senser_psd_2_asm.stp

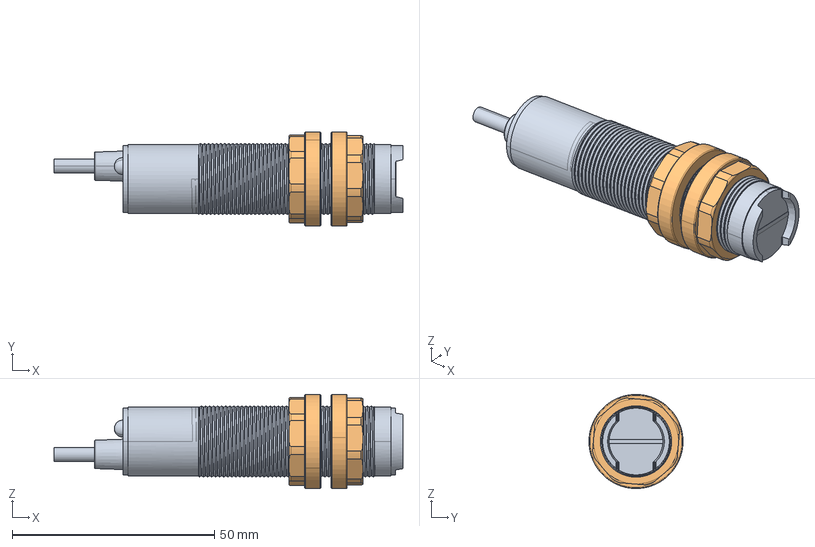
[picture p149: CAD file, 2023-02-20]
0.1.Hardware/0.1.Solidworks/sensor_mid/senser_psd_2_asm.stp
86.2 x 23.2 x 23.2 mm
SENSOR_PSD_2
SENSOR_PSD_2_NUT x 2
