Kevinchu77/MobileRobot/0.1.Hardware/0.1.Solidworks/Mica/3mm_base_mainboard.DXF

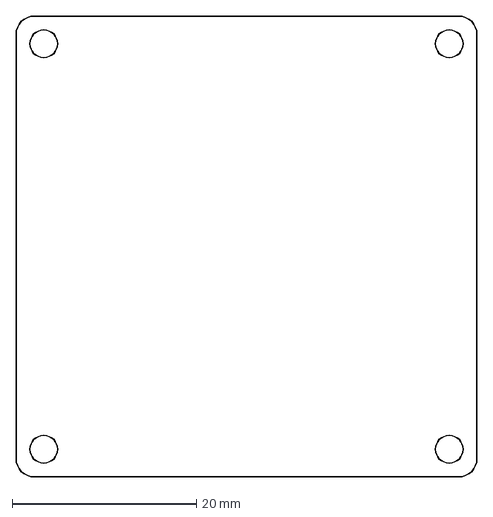
[picture p150: CAD file, 2023-02-20]
0.1.Hardware/0.1.Solidworks/Mica/3mm_base_mainboard.DXF
50.0 x 50.0 mm
