Kevinchu77/MobileRobot/0.1.Hardware/0.1.Solidworks/sensor_mid/LineSensorAssy.step

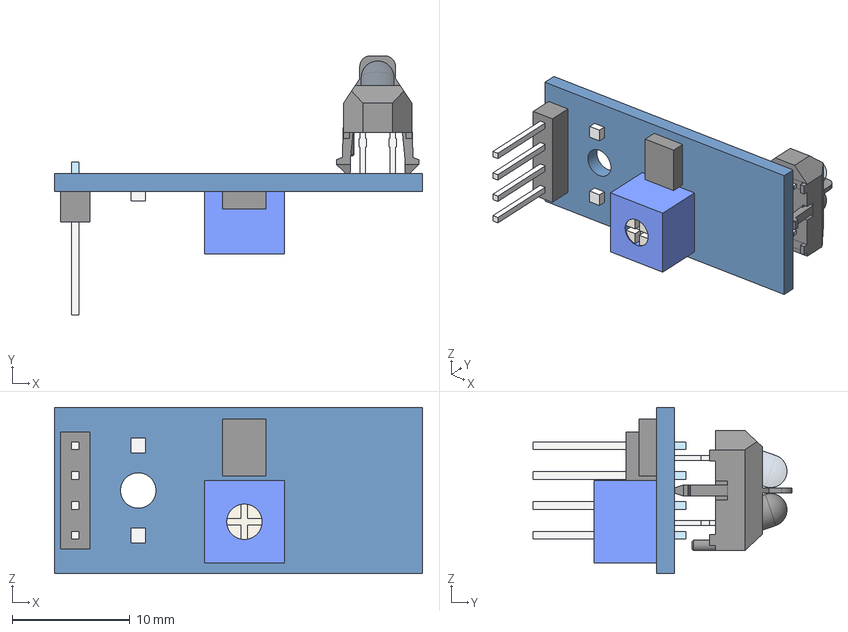
[picture p151: CAD file, 2023-02-20]
0.1.Hardware/0.1.Solidworks/sensor_mid/LineSensorAssy.step
31.2 x 22.0 x 14.1 mm
Metal Contacts x 4
TCRT5000 v1
LEDs x 2
