Kevinchu77/MobileRobot/0.1.Hardware/0.1.Solidworks/sensor_mid/photoelectric sensor.SLDASM

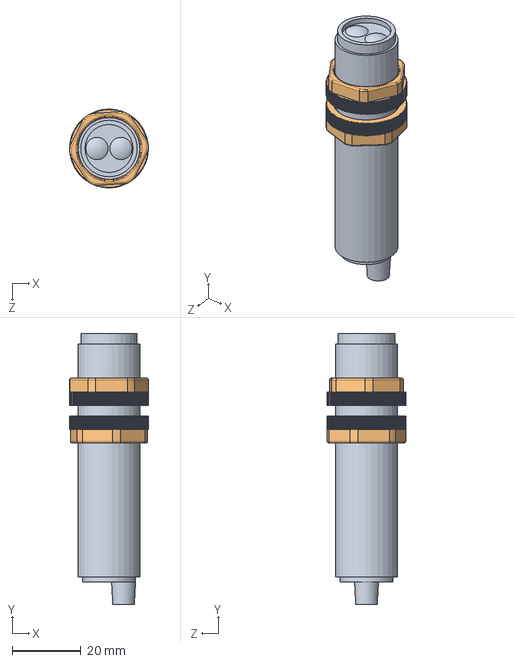
[picture p152: CAD file, 2023-02-20]
0.1.Hardware/0.1.Solidworks/sensor_mid/photoelectric sensor.SLDASM
23.0 x 79.0 x 23.0 mm
sensor photo elektrik
sensor clamp x 2
