Kevinchu77/MobileRobot/0.1.Hardware/0.1.Solidworks/lm2596/LM2596 DC to DC Buck Converter 3 A/LM2596 with and without cooler.SLDASM

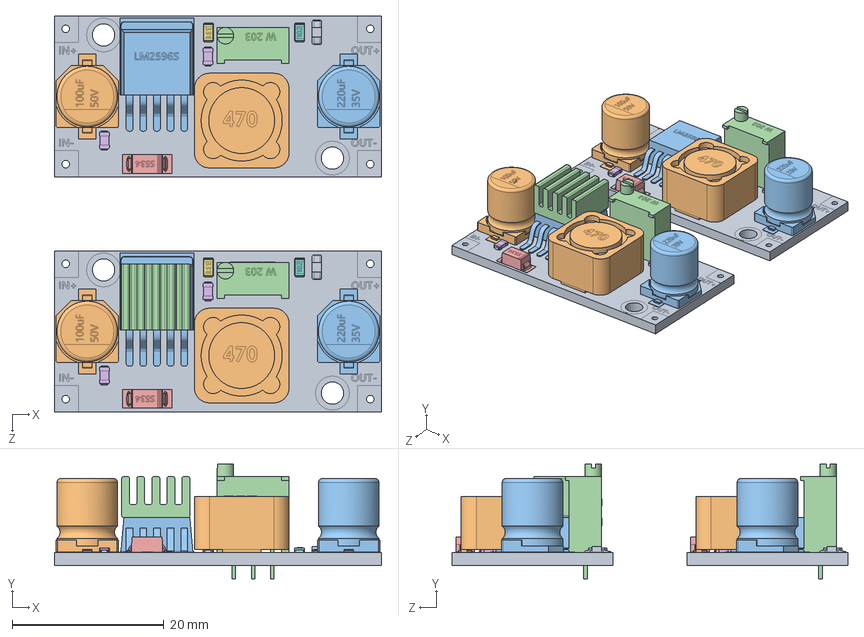
[picture p154: CAD file, 2023-02-20]
0.1.Hardware/0.1.Solidworks/lm2596/LM2596 DC to DC Buck Converter 3 A/LM2596 with and without cooler.SLDASM
43.2 x 15.1 x 52.3 mm
lm2596board x 2
smd100uF x 2
smd220uF x 2
TrimmerW203 x 2
smdS537diode x 2
smdceramiccapacitor x 4
smdResistor331 x 2
smdResistor102 x 2
smdLED x 2
smbInductor470 x 2
LM2596S x 2
IC Cooler
