Kevinchu77/MobileRobot/0.1.Hardware/0.1.Solidworks/ball castor CY 15A .step.SLDASM

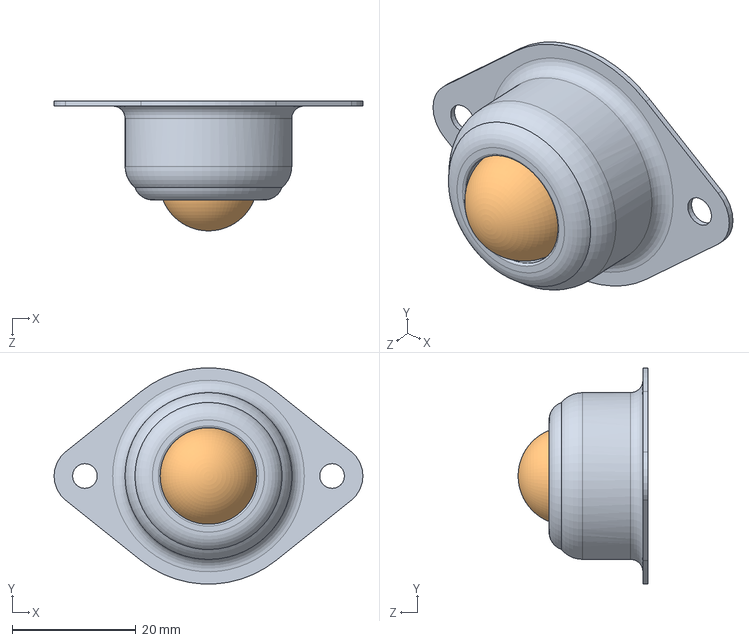
[picture p155: CAD file, 2023-02-20]
0.1.Hardware/0.1.Solidworks/ball castor CY 15A .step.SLDASM
50.0 x 34.9 x 21.0 mm
shell.step
ball.step
