Kevinchu77/MobileRobot/0.1.Hardware/0.1.Solidworks/blue_wheel_v1.SLDASM

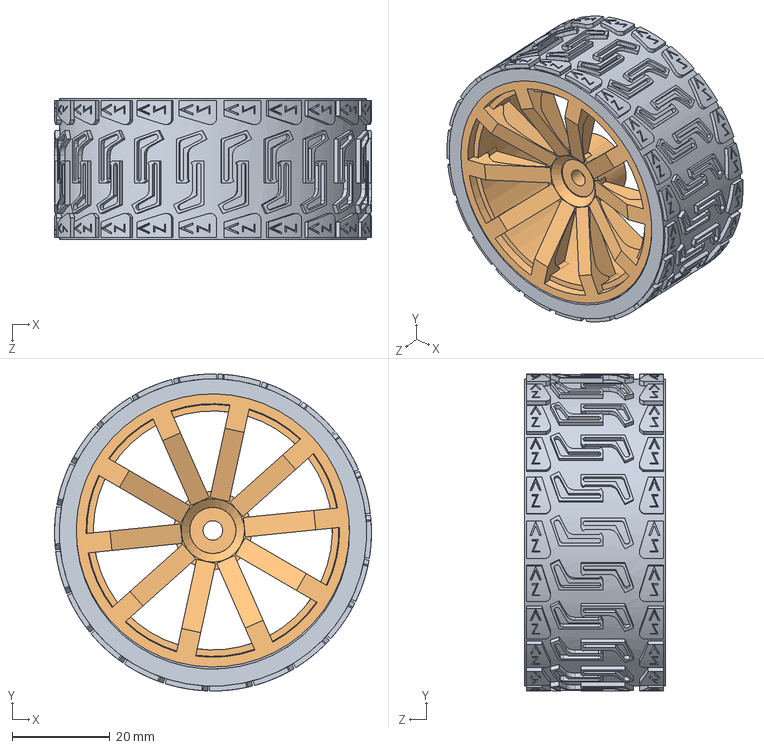
[picture p156: CAD file, 2023-02-20]
0.1.Hardware/0.1.Solidworks/blue_wheel_v1.SLDASM
65.0 x 65.0 x 29.0 mm
65mm tire
blue_wheel_frame
