Kevinchu77/MobileRobot/0.1.Hardware/0.1.Solidworks/blue_wheel_with_adapter.SLDASM

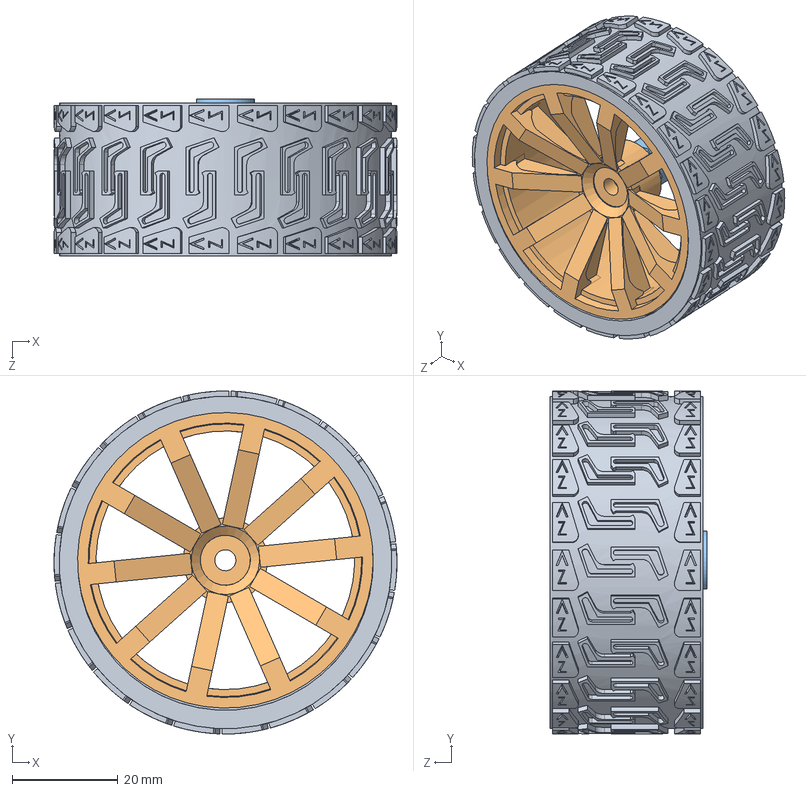
[picture p157: CAD file, 2023-02-20]
0.1.Hardware/0.1.Solidworks/blue_wheel_with_adapter.SLDASM
65.0 x 65.0 x 29.8 mm
65mm tire
blue_wheel_frame
motor_adapter
