Kevinchu77/MobileRobot/0.1.Hardware/0.1.Solidworks/Hold_18650-2p.stp.SLDASM

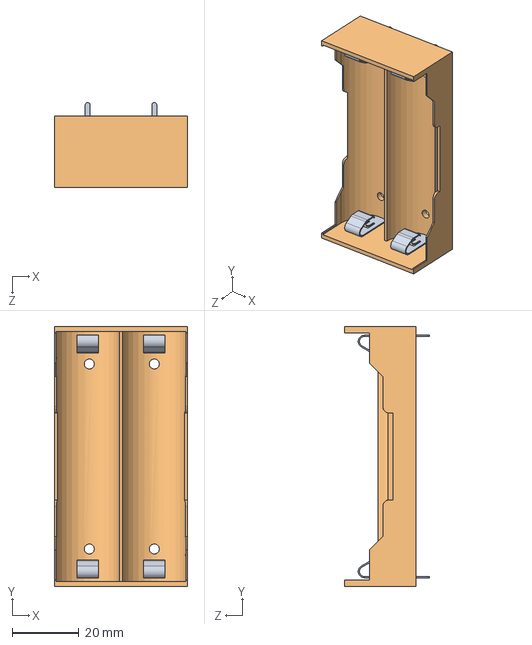
[picture p158: CAD file, 2023-02-20]
0.1.Hardware/0.1.Solidworks/Hold_18650-2p.stp.SLDASM
40.0 x 78.0 x 25.5 mm
Hold_18650-2p-prt0.stp x 4
Hold_18650-2p-prt1.stp
