Kevinchu77/MobileRobot/0.1.Hardware/0.1.Solidworks/Arduino nano.STEP.SLDASM

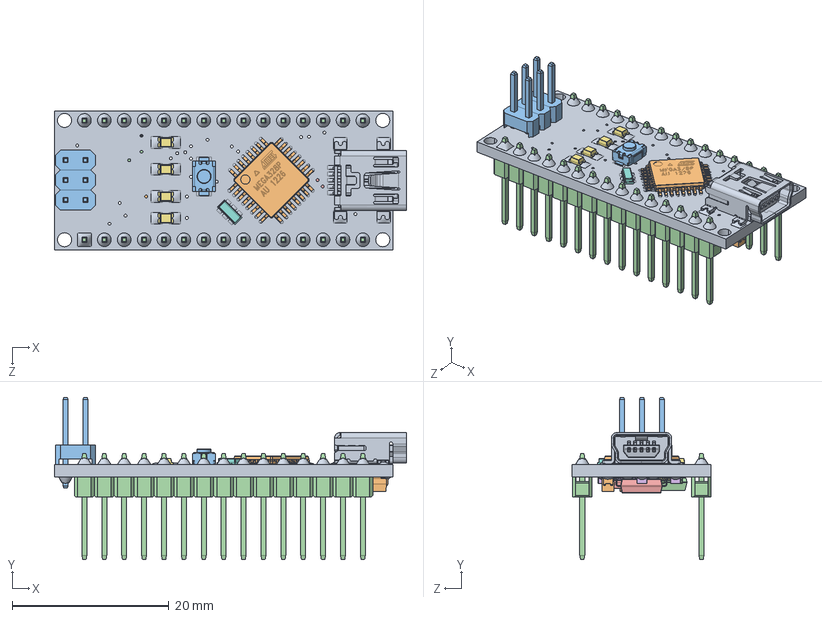
[picture p159: CAD file, 2023-02-20]
0.1.Hardware/0.1.Solidworks/Arduino nano.STEP.SLDASM
45.0 x 20.7 x 17.8 mm
nano board.STEP
atmega328.STEP
PLD-2.step.STEP x 3
1x15 Male Pin Header.STEP x 2
FTDI FT232RL.STEP
User Library-C0805-2.step.STEP x 5
0805 Chip SMD LED (2x1.2mm).step.STEP x 4
SMD Crystal 16MHz.STEP
Mini B USB.STEP
Tantalum Capacitor 475C A3216.STEP x 2
Pushbutton3x4x2.STEP
C5 FD10 Reg.STEP
Diode MBR0520.STEP
102 RESISTOR PACK.STEP
189 RESISTOR PACK.STEP
