Kevinchu77/MobileRobot/0.1.Hardware/0.1.Solidworks/IRsensors.STEP.SLDASM

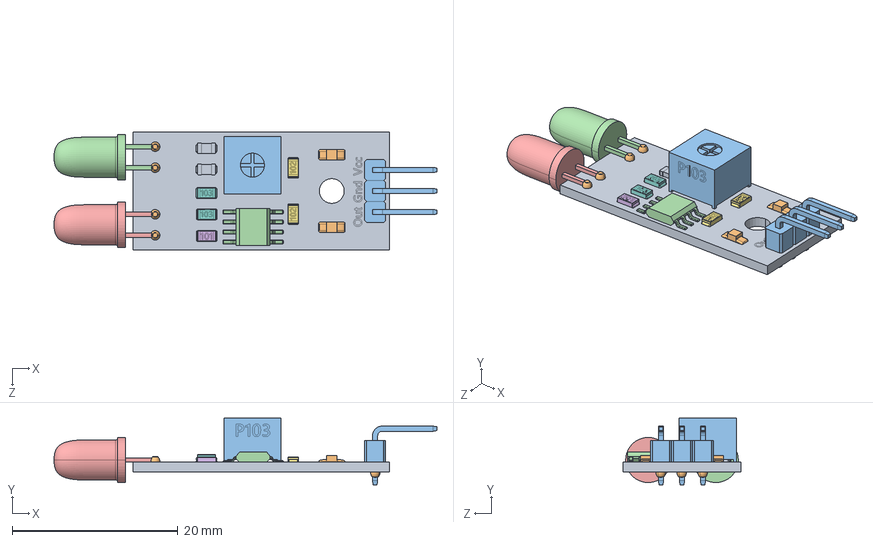
[picture p160: CAD file, 2023-02-20]
0.1.Hardware/0.1.Solidworks/IRsensors.STEP.SLDASM
46.3 x 8.05 x 14.2 mm
IRboard.STEP
solder.STEP x 7
90headerMale.STEP x 3
blackLEDIRsensor.STEP
whiteLEDIRsensor.STEP
smdResistor101.STEP
smdResistor102.STEP x 2
smdResistor103.STEP x 2
smdceramiccapacitor.STEP x 2
smdLED.STEP x 2
smdTrimmerP103.STEP
smdChip8pin.STEP
