Kevinchu77/MobileRobot/0.1.Hardware/0.1.Solidworks/test_sensor_base.SLDASM

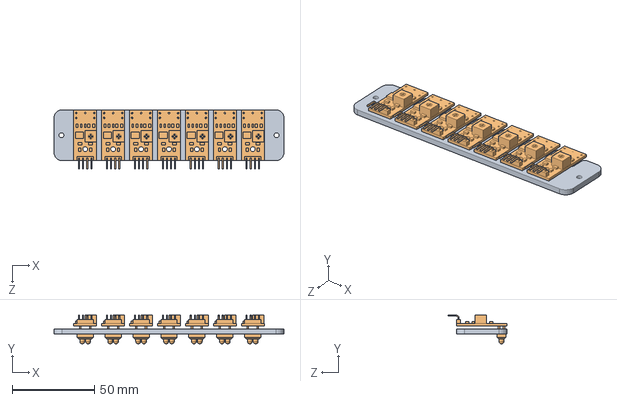
[picture p161: CAD file, 2023-02-20]
0.1.Hardware/0.1.Solidworks/test_sensor_base.SLDASM
140.0 x 17.6 x 36.2 mm
base_sensor
TCRT5000mod x 7
