Kevinchu77/MobileRobot/0.1.Hardware/0.1.Solidworks/kcd1.stp.SLDASM

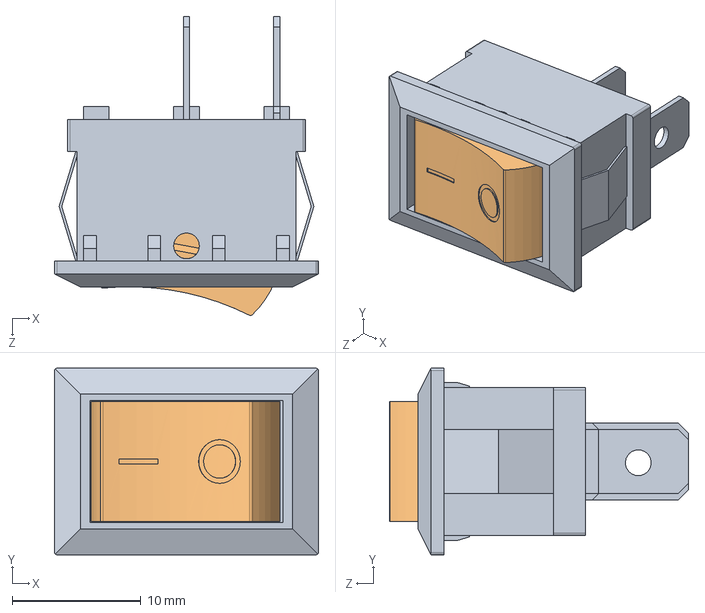
[picture p162: CAD file, 2023-02-20]
0.1.Hardware/0.1.Solidworks/kcd1.stp.SLDASM
20.5 x 14.5 x 23.2 mm
kcd1-prt0.stp
kcd1-prt1.stp
