Kevinchu77/MobileRobot/0.1.Hardware/0.1.Solidworks/base_mainboard.SLDPRT

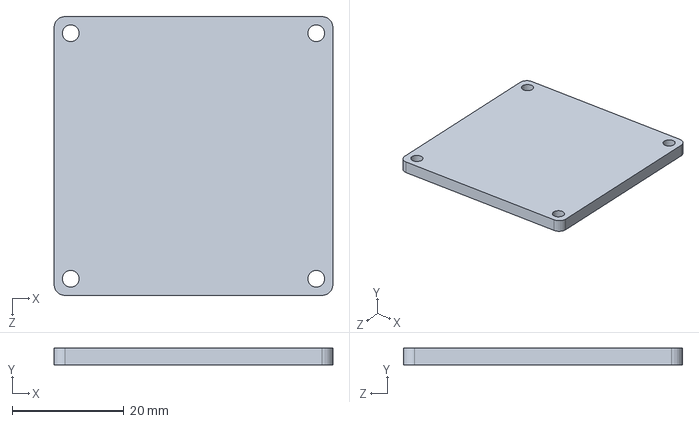
[picture p163: CAD file, 2023-02-20]
0.1.Hardware/0.1.Solidworks/base_mainboard.SLDPRT
50.0 x 3.00 x 50.0 mm
