Kevinchu77/MobileRobot/0.1.Hardware/0.1.Solidworks/arduino/Arduino Nano/nano board.SLDPRT

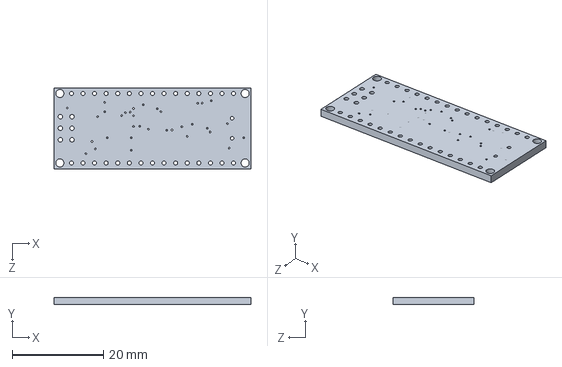
[picture p164: CAD file, 2023-02-20]
0.1.Hardware/0.1.Solidworks/arduino/Arduino Nano/nano board.SLDPRT
43.2 x 1.60 x 17.8 mm
