Kevinchu77/MobileRobot/0.1.Hardware/0.1.Solidworks/arduino/arduino.SLDPRT

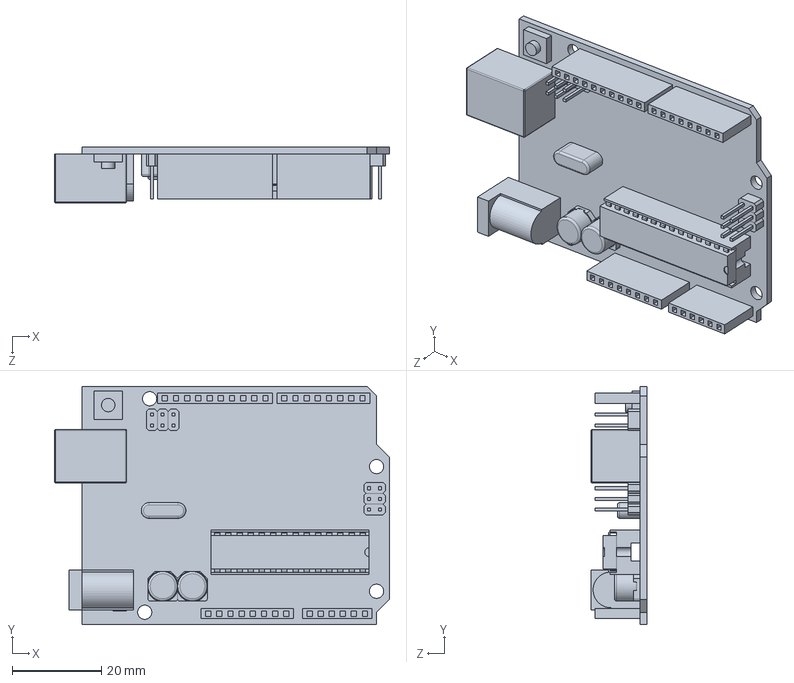
[picture p165: CAD file, 2023-02-20]
0.1.Hardware/0.1.Solidworks/arduino/arduino.SLDPRT
75.0 x 53.3 x 12.5 mm
