Kevinchu77/MobileRobot/0.1.Hardware/0.1.Solidworks/board/BreadBord.STEP

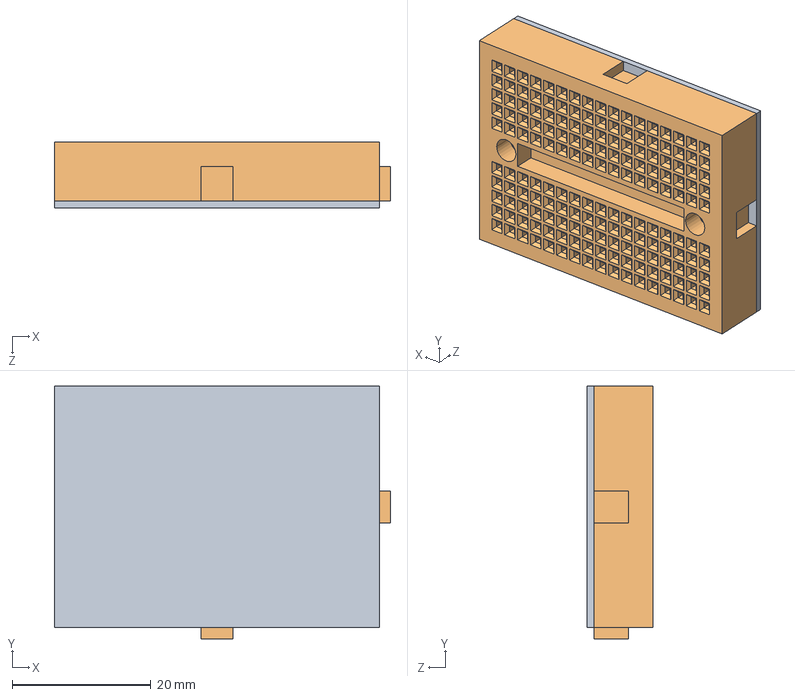
[picture p166: CAD file, 2023-02-20]
0.1.Hardware/0.1.Solidworks/board/BreadBord.STEP
48.4 x 36.4 x 9.50 mm
