Kevinchu77/MobileRobot/0.1.Hardware/0.1.Solidworks/hexagonal_spacer_MF_M3_H05_HEX5.5_FTD3_MTL6.step.SLDPRT

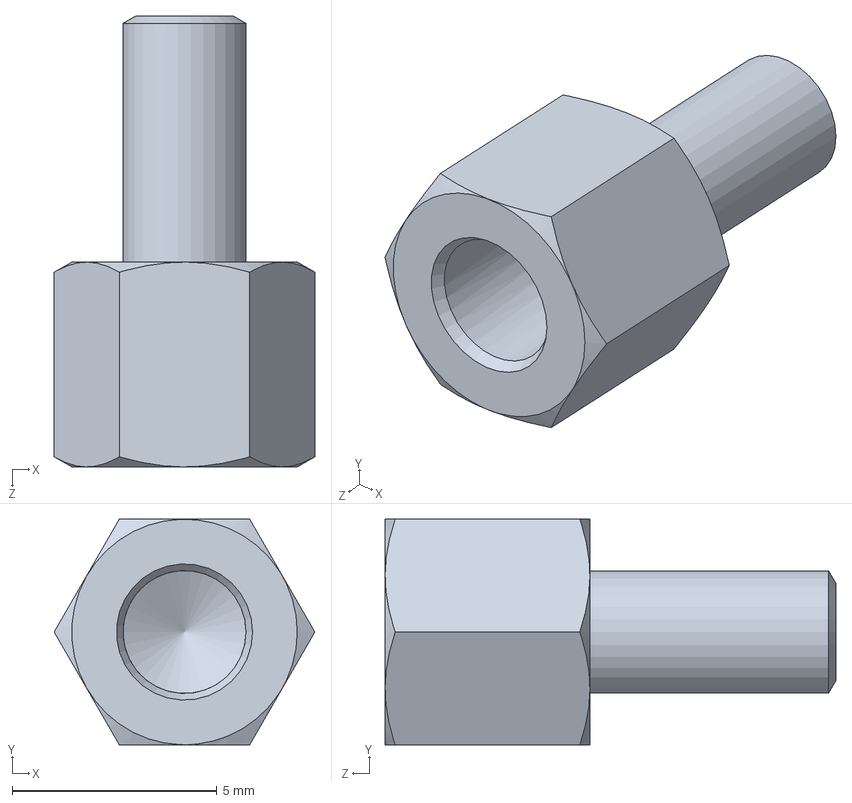
[picture p167: CAD file, 2023-02-20]
0.1.Hardware/0.1.Solidworks/hexagonal_spacer_MF_M3_H05_HEX5.5_FTD3_MTL6.step.SLDPRT
6.36 x 5.51 x 11.0 mm
