Kevinchu77/MobileRobot/0.1.Hardware/0.1.Solidworks/lm2596/LM2596 DC to DC Buck Converter 3 A/smd220uF.SLDPRT

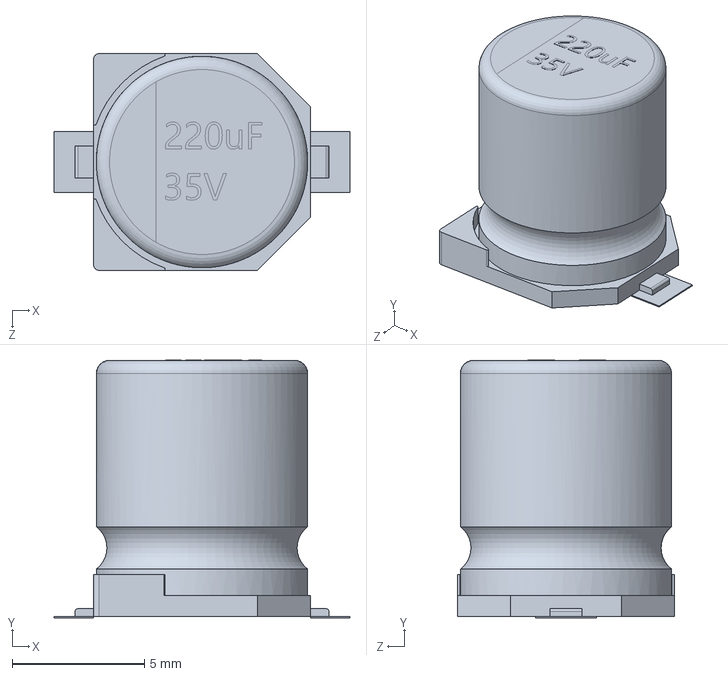
[picture p168: CAD file, 2023-02-20]
0.1.Hardware/0.1.Solidworks/lm2596/LM2596 DC to DC Buck Converter 3 A/smd220uF.SLDPRT
11.2 x 9.76 x 8.20 mm
