Kevinchu77/MobileRobot/0.1.Hardware/0.1.Solidworks/Mica/3mm_base_lot.DXF

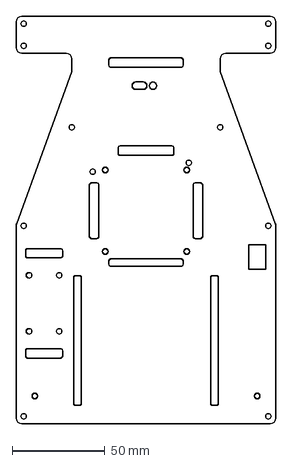
[picture p169: CAD file, 2023-02-20]
0.1.Hardware/0.1.Solidworks/Mica/3mm_base_lot.DXF
140.0 x 220.0 mm
