Kevinchu77/MobileRobot/0.1.Hardware/0.1.Solidworks/pin/Hold_18650-4p.stp

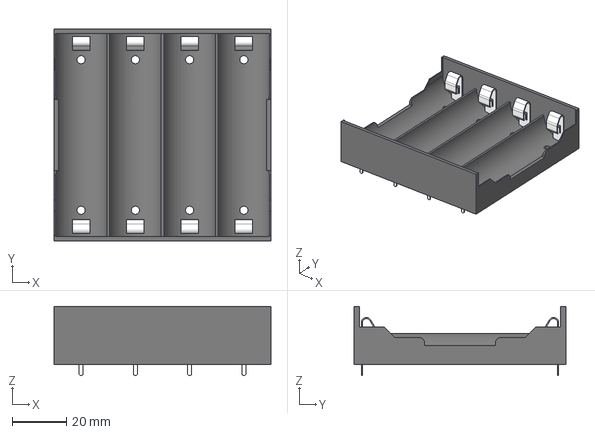
[picture p170: CAD file, 2023-02-20]
0.1.Hardware/0.1.Solidworks/pin/Hold_18650-4p.stp
80.0 x 78.0 x 25.5 mm
