Kevinchu77/MobileRobot/0.1.Hardware/0.1.Solidworks/sensor_mid/sonar/2.SLDPRT

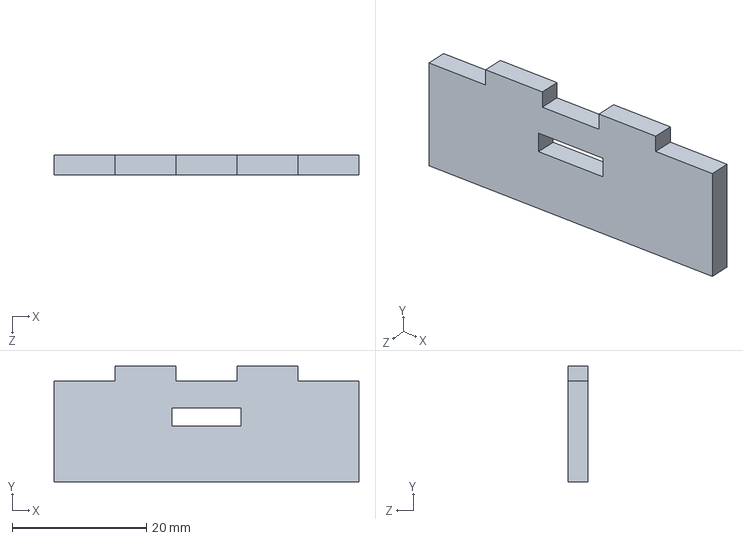
[picture p171: CAD file, 2023-02-20]
0.1.Hardware/0.1.Solidworks/sensor_mid/sonar/2.SLDPRT
45.4 x 17.2 x 3.00 mm
