Kevinchu77/MobileRobot/0.1.Hardware/0.1.Solidworks/tru_dong/hexagonal_spacer_MF_M3_H50_HEX5.5_FTD6_MTL6.step

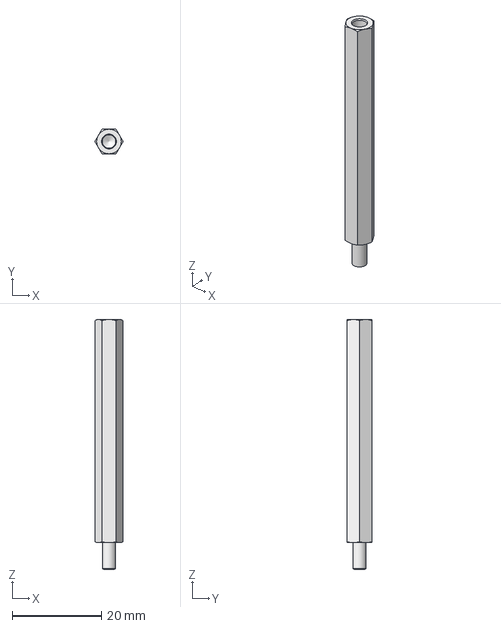
[picture p172: CAD file, 2023-02-20]
0.1.Hardware/0.1.Solidworks/tru_dong/hexagonal_spacer_MF_M3_H50_HEX5.5_FTD6_MTL6.step
6.36 x 5.51 x 56.0 mm
