Kevinchu77/MobileRobot/0.1.Hardware/0.1.Solidworks/arduino/Arduino Nano/102 RESISTOR PACK.SLDPRT

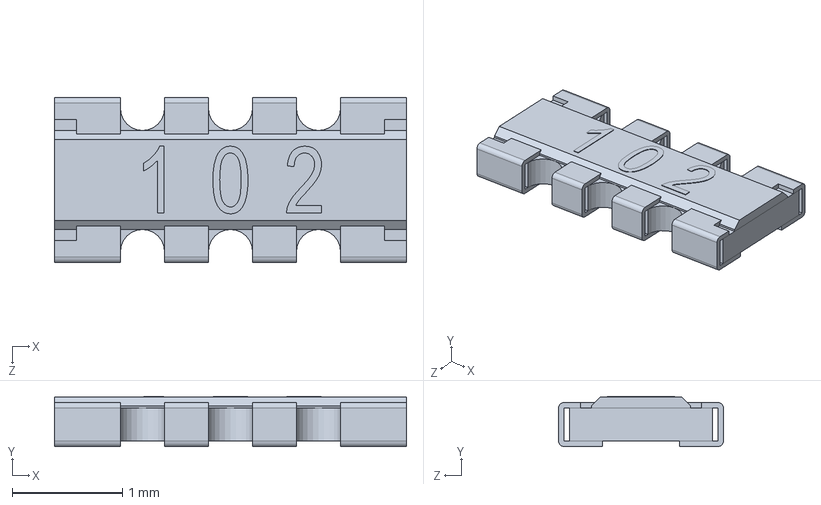
[picture p173: CAD file, 2023-02-20]
0.1.Hardware/0.1.Solidworks/arduino/Arduino Nano/102 RESISTOR PACK.SLDPRT
3.20 x 0.455 x 1.50 mm
