Kevinchu77/MobileRobot/0.1.Hardware/0.1.Solidworks/lm2596/LM2596 DC to DC Buck Converter 3 A/LM2596S.SLDPRT

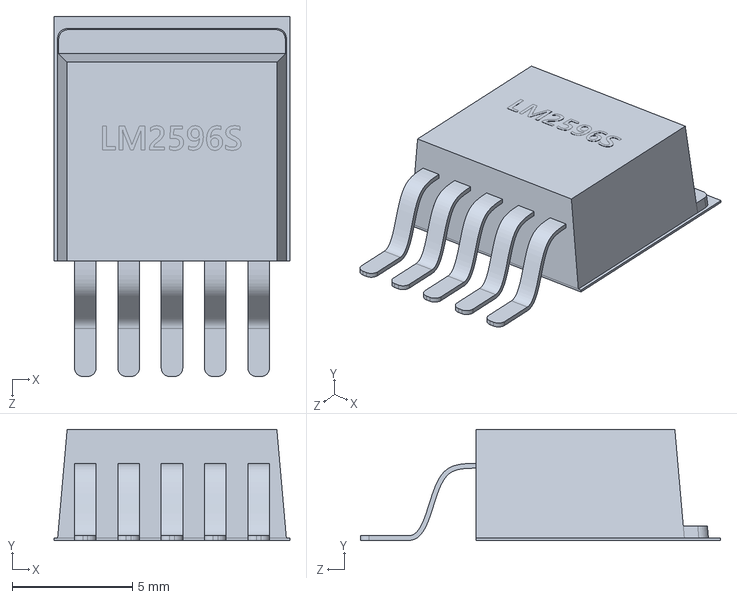
[picture p174: CAD file, 2023-02-20]
0.1.Hardware/0.1.Solidworks/lm2596/LM2596 DC to DC Buck Converter 3 A/LM2596S.SLDPRT
9.80 x 4.61 x 14.9 mm
