Kevinchu77/MobileRobot/0.1.Hardware/0.1.Solidworks/Mica/4.5mm_base_xedoline.DXF

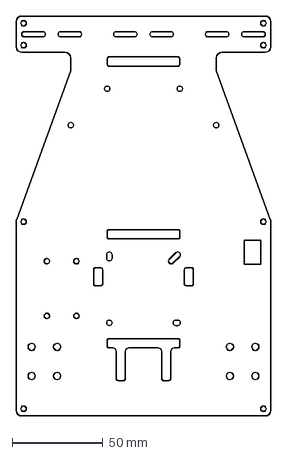
[picture p175: CAD file, 2023-02-20]
0.1.Hardware/0.1.Solidworks/Mica/4.5mm_base_xedoline.DXF
140.0 x 220.0 mm
