Kevinchu77/MobileRobot/0.1.Hardware/0.1.Solidworks/sensor_mid/sonar/1.SLDPRT

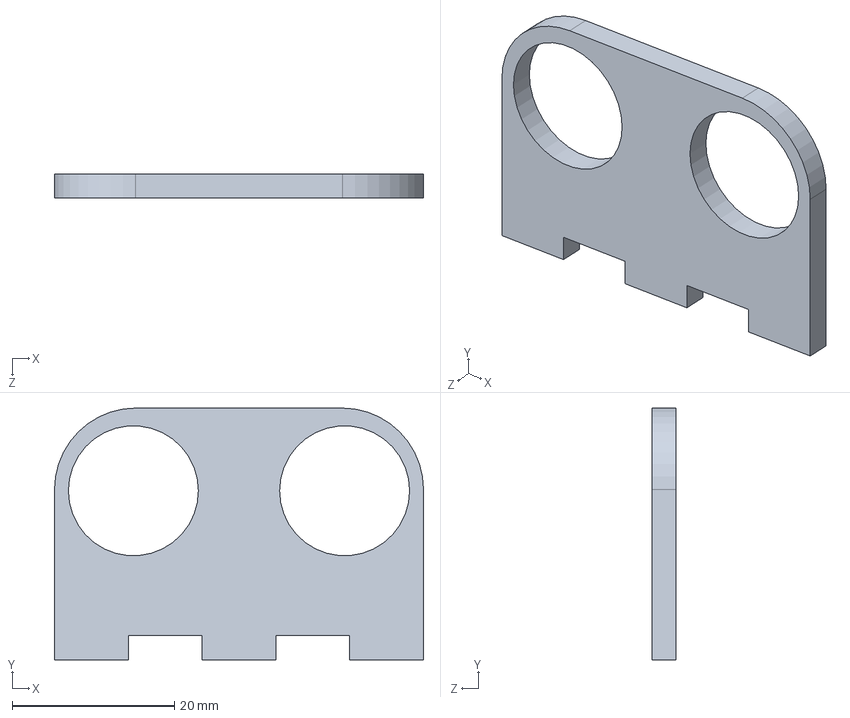
[picture p176: CAD file, 2023-02-20]
0.1.Hardware/0.1.Solidworks/sensor_mid/sonar/1.SLDPRT
45.4 x 31.0 x 3.00 mm
