Kevinchu77/MobileRobot/0.1.Hardware/0.1.Solidworks/arduino/Arduino Nano/Tantalum Capacitor 475C A3216.SLDPRT

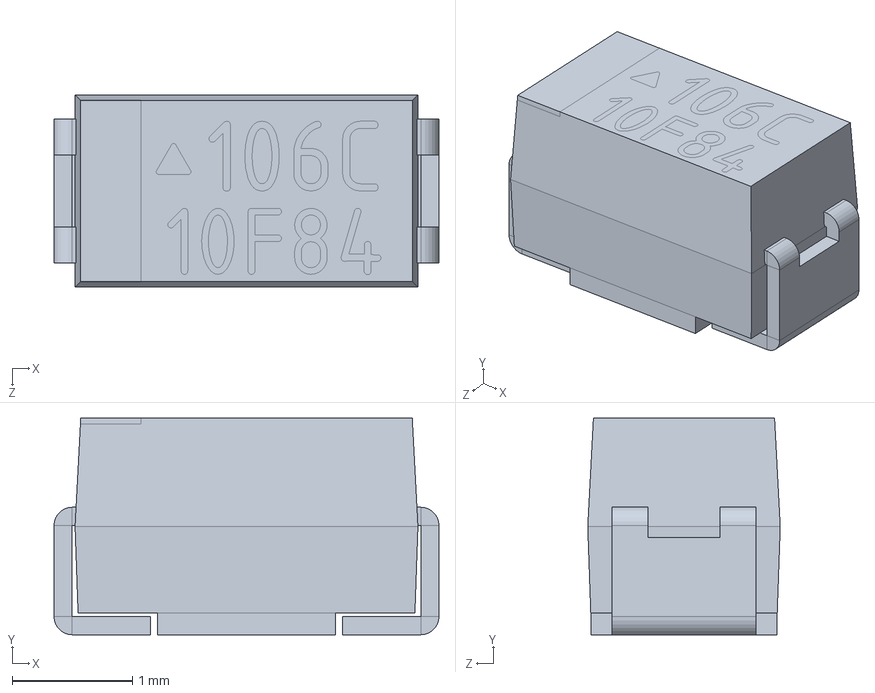
[picture p178: CAD file, 2023-02-20]
0.1.Hardware/0.1.Solidworks/arduino/Arduino Nano/Tantalum Capacitor 475C A3216.SLDPRT
3.20 x 1.80 x 1.60 mm
