Kevinchu77/MobileRobot/0.1.Hardware/0.1.Solidworks/hexagonal_spacer_MF_M3_H30_HEX5.5_FTD6_MTL6.step.SLDPRT

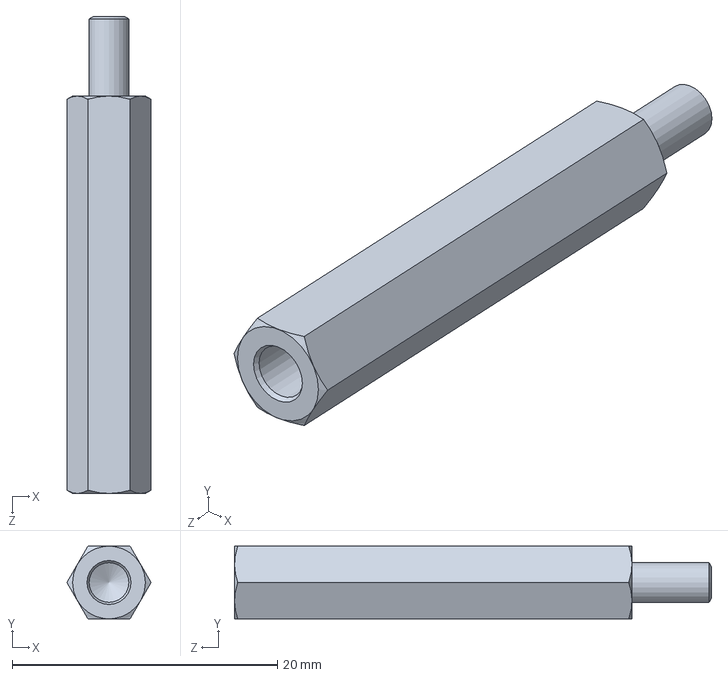
[picture p179: CAD file, 2023-02-20]
0.1.Hardware/0.1.Solidworks/hexagonal_spacer_MF_M3_H30_HEX5.5_FTD6_MTL6.step.SLDPRT
6.36 x 5.51 x 36.0 mm
