Kevinchu77/MobileRobot/0.1.Hardware/0.1.Solidworks/sensor_mid/TCRT5000mod.SLDPRT

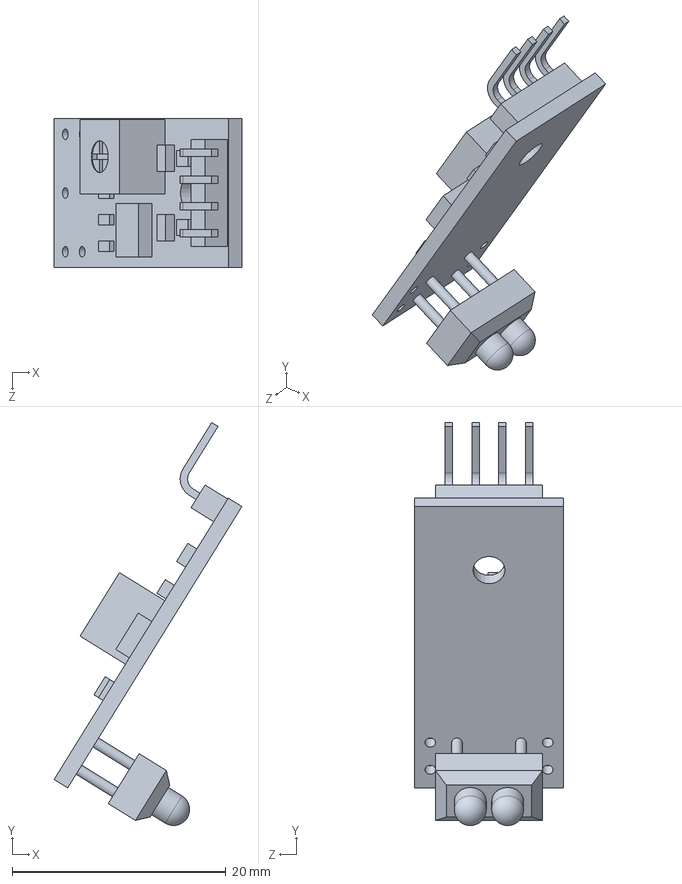
[picture p180: CAD file, 2023-02-20]
0.1.Hardware/0.1.Solidworks/sensor_mid/TCRT5000mod.SLDPRT
17.6 x 37.8 x 14.0 mm
