Kevinchu77/MobileRobot/0.1.Hardware/0.1.Solidworks/arduino/Arduino Nano/atmega328.SLDPRT

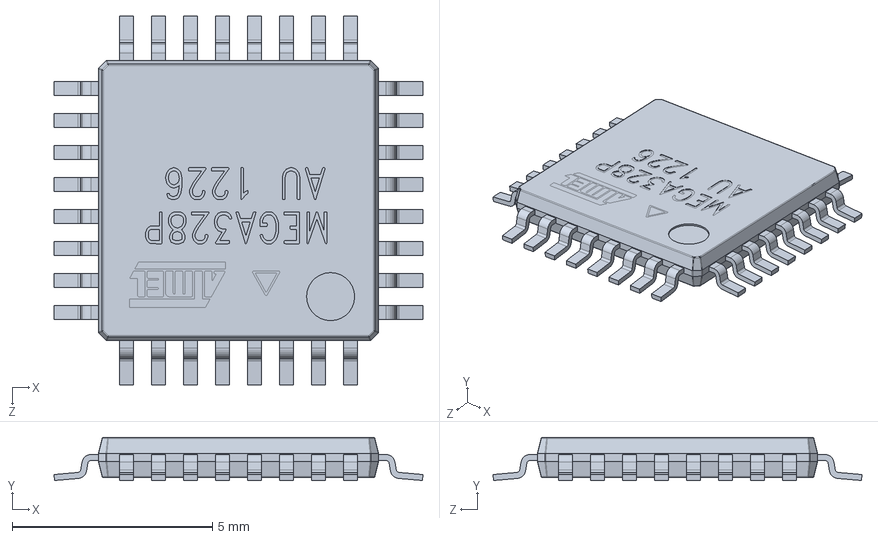
[picture p182: CAD file, 2023-02-20]
0.1.Hardware/0.1.Solidworks/arduino/Arduino Nano/atmega328.SLDPRT
9.21 x 1.07 x 9.21 mm
