Kevinchu77/MobileRobot/0.1.Hardware/0.1.Solidworks/ball castor CY 15A .step

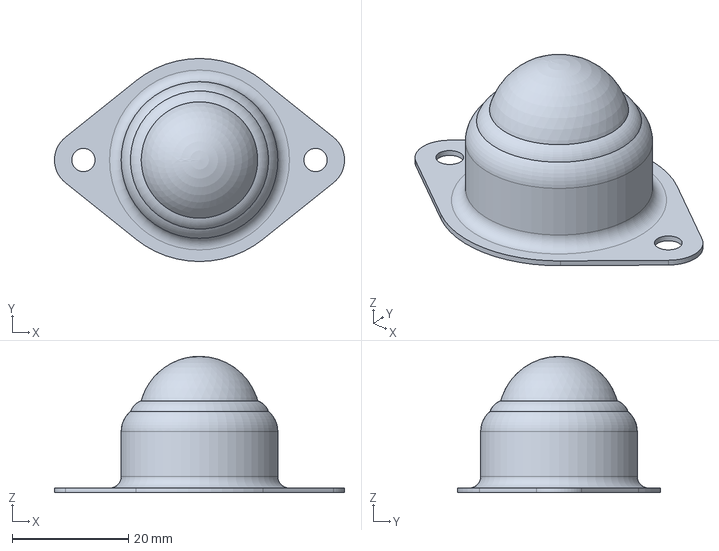
[picture p183: CAD file, 2023-02-20]
0.1.Hardware/0.1.Solidworks/ball castor CY 15A .step
50.0 x 35.0 x 23.5 mm
ball
