Kevinchu77/MobileRobot/0.1.Hardware/0.1.Solidworks/lm2596/LM2596 DC to DC Buck Converter 3 A/smbInductor470.SLDPRT

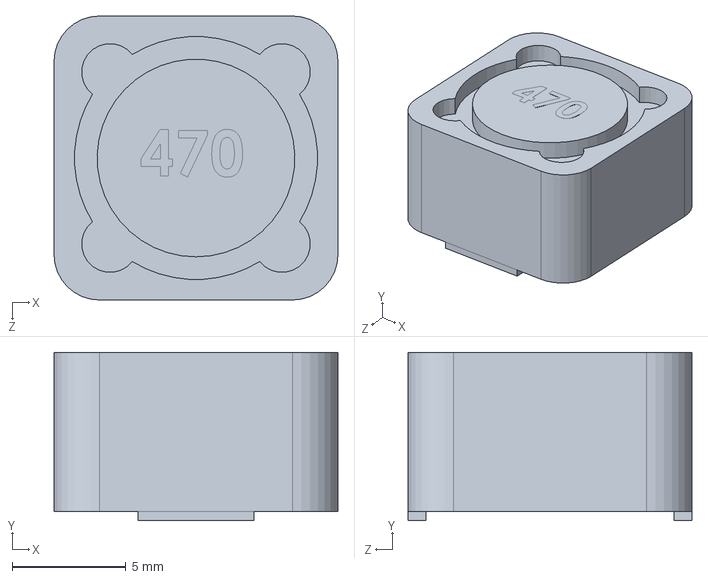
[picture p184: CAD file, 2023-02-20]
0.1.Hardware/0.1.Solidworks/lm2596/LM2596 DC to DC Buck Converter 3 A/smbInductor470.SLDPRT
12.5 x 7.41 x 12.5 mm
