Kevinchu77/MobileRobot/0.1.Hardware/0.1.Solidworks/Mica/3mm_base_sensor.DXF

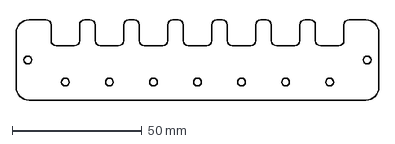
[picture p185: CAD file, 2023-02-20]
0.1.Hardware/0.1.Solidworks/Mica/3mm_base_sensor.DXF
140.0 x 31.0 mm
