Kevinchu77/MobileRobot/0.1.Hardware/0.1.Solidworks/arduino/Arduino Nano/C5 FD10 Reg.SLDPRT

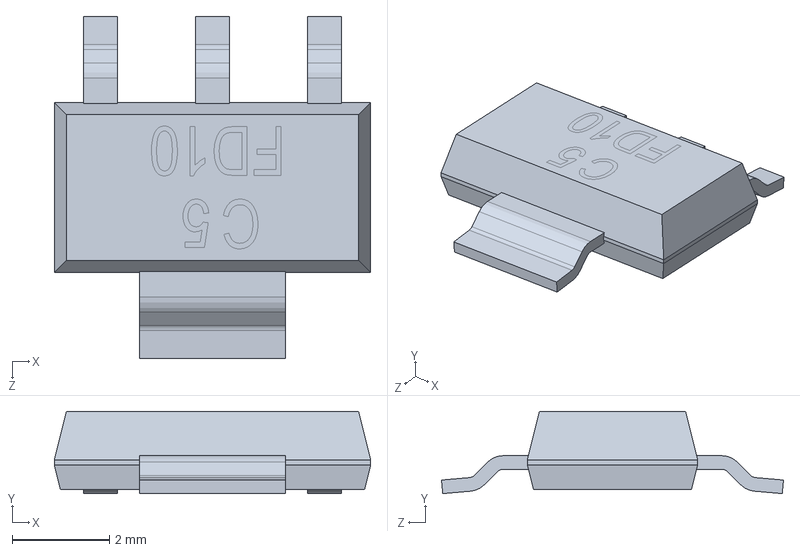
[picture p187: CAD file, 2023-02-20]
0.1.Hardware/0.1.Solidworks/arduino/Arduino Nano/C5 FD10 Reg.SLDPRT
6.50 x 1.69 x 7.02 mm
