Kevinchu77/MobileRobot/0.1.Hardware/0.1.Solidworks/lm2596/LM2596 DC to DC Buck Converter 3 A/TrimmerW203.SLDPRT

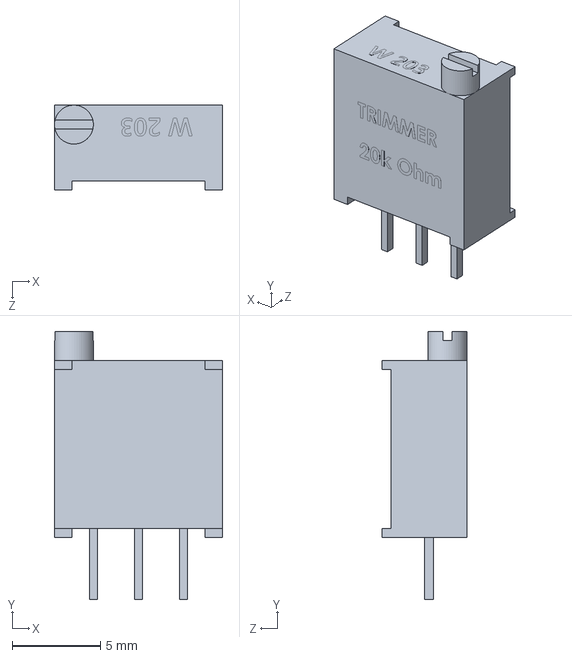
[picture p188: CAD file, 2023-02-20]
0.1.Hardware/0.1.Solidworks/lm2596/LM2596 DC to DC Buck Converter 3 A/TrimmerW203.SLDPRT
9.50 x 15.1 x 4.81 mm
