Kevinchu77/MobileRobot/0.1.Hardware/0.1.Solidworks/Mica/3mm_de.DXF

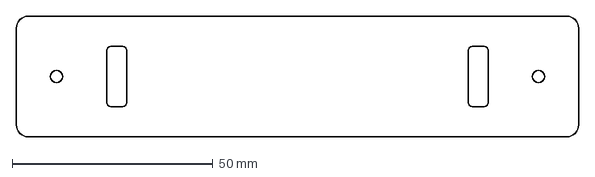
[picture p189: CAD file, 2023-02-20]
0.1.Hardware/0.1.Solidworks/Mica/3mm_de.DXF
140.0 x 30.0 mm
