Kevinchu77/MobileRobot/0.1.Hardware/0.1.Solidworks/tru_dong/hexagonal_spacer_MF_M3_H55_HEX5.5_FTD10_MTL10.step

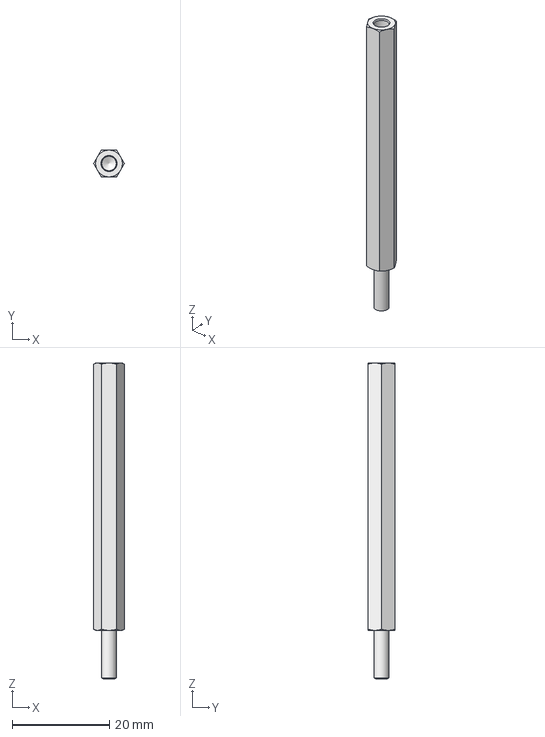
[picture p190: CAD file, 2023-02-20]
0.1.Hardware/0.1.Solidworks/tru_dong/hexagonal_spacer_MF_M3_H55_HEX5.5_FTD10_MTL10.step
6.36 x 5.51 x 65.0 mm
