Kevinchu77/MobileRobot/0.1.Hardware/0.1.Solidworks/arduino/Arduino Nano/Diode MBR0520.SLDPRT

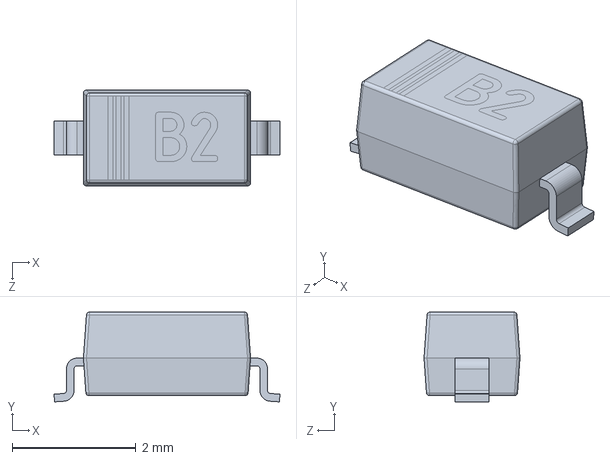
[picture p191: CAD file, 2023-02-20]
0.1.Hardware/0.1.Solidworks/arduino/Arduino Nano/Diode MBR0520.SLDPRT
3.65 x 1.45 x 1.55 mm
