Kevinchu77/MobileRobot/0.1.Hardware/0.1.Solidworks/arduino/Arduino Nano/SMD Crystal 16MHz.SLDPRT

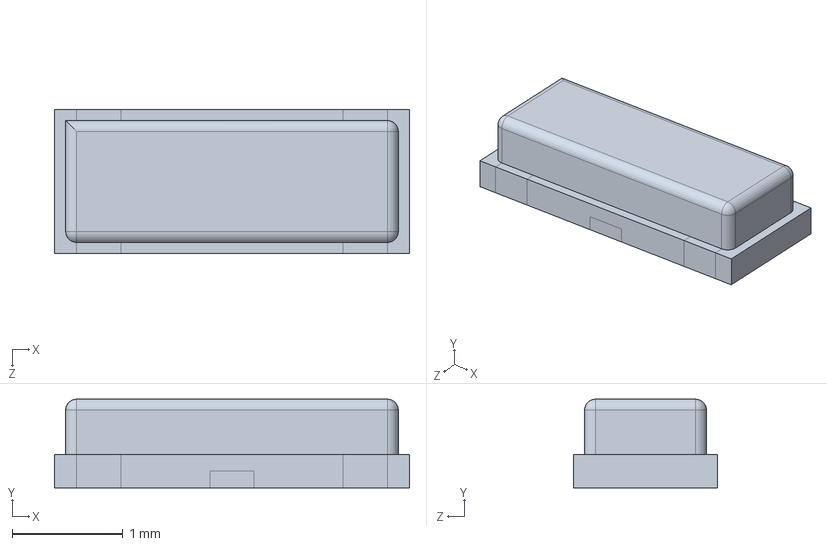
[picture p193: CAD file, 2023-02-20]
0.1.Hardware/0.1.Solidworks/arduino/Arduino Nano/SMD Crystal 16MHz.SLDPRT
3.20 x 0.8 x 1.30 mm
