Kevinchu77/MobileRobot/0.1.Hardware/0.1.Solidworks/lm2596/LM2596 DC to DC Buck Converter 3 A/smdceramiccapacitor.SLDPRT

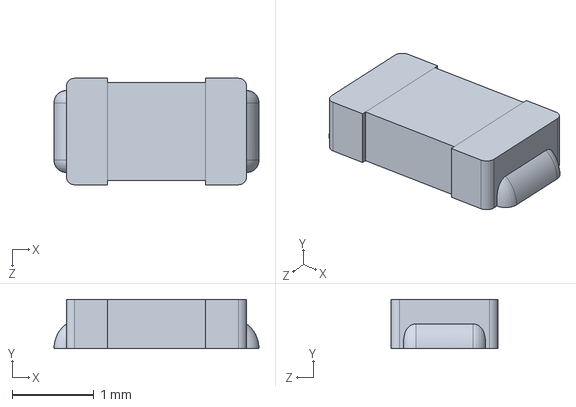
[picture p194: CAD file, 2023-02-20]
0.1.Hardware/0.1.Solidworks/lm2596/LM2596 DC to DC Buck Converter 3 A/smdceramiccapacitor.SLDPRT
2.50 x 0.6 x 1.30 mm
