Kevinchu77/MobileRobot/0.1.Hardware/0.1.Solidworks/sensor_mid/ga_sensor.SLDPRT

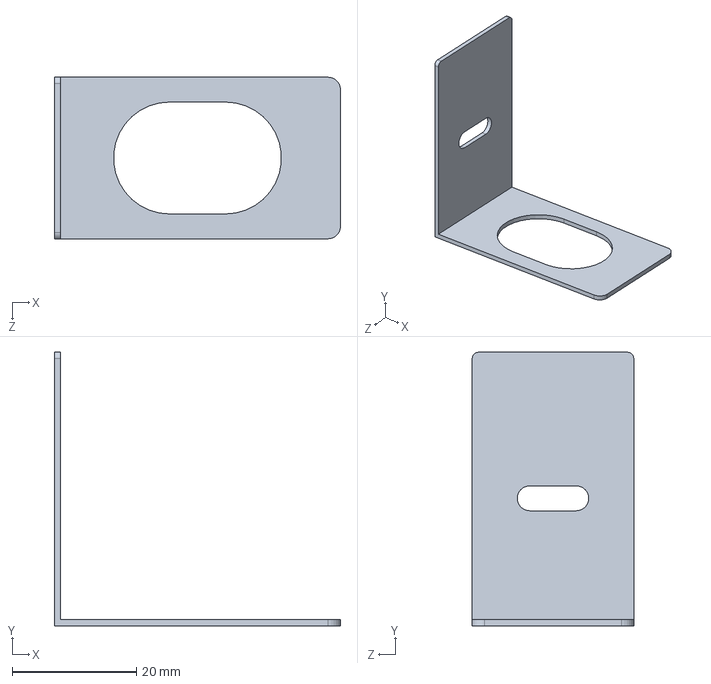
[picture p195: CAD file, 2023-02-20]
0.1.Hardware/0.1.Solidworks/sensor_mid/ga_sensor.SLDPRT
46.0 x 44.0 x 26.0 mm
