Kevinchu77/MobileRobot/0.1.Hardware/0.1.Solidworks/arduino/Arduino Nano/Mini B USB.SLDPRT

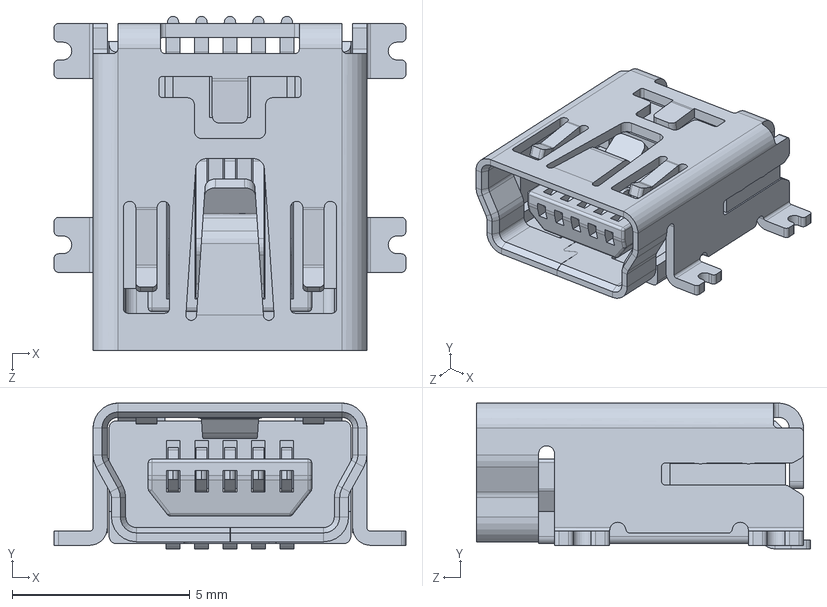
[picture p197: CAD file, 2023-02-20]
0.1.Hardware/0.1.Solidworks/arduino/Arduino Nano/Mini B USB.SLDPRT
9.90 x 4.10 x 9.40 mm
