Kevinchu77/MobileRobot/0.1.Hardware/0.1.Solidworks/arduino/Arduino Nano/PLD-2.step.SLDPRT

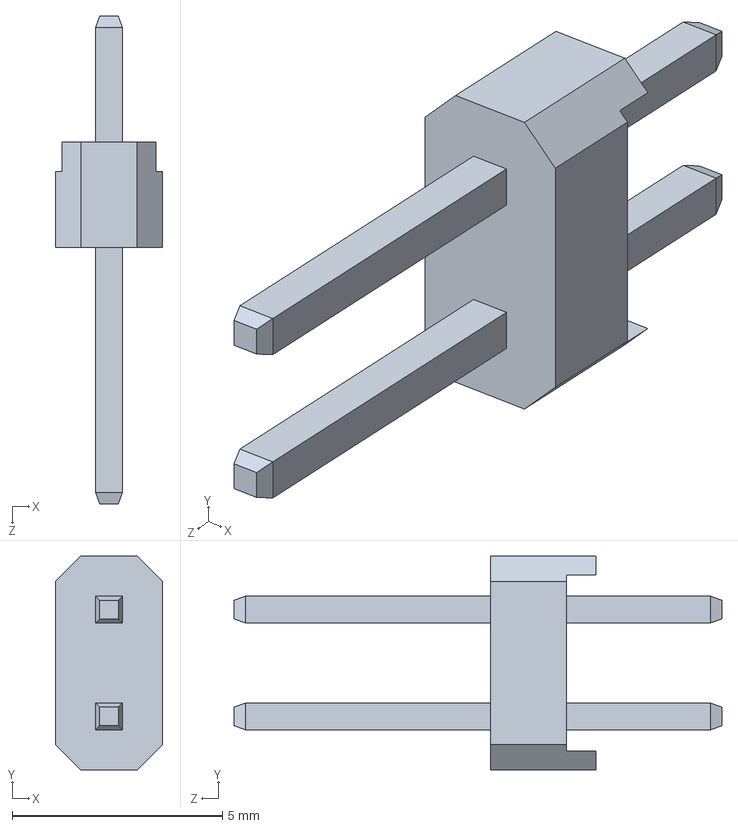
[picture p200: CAD file, 2023-02-20]
0.1.Hardware/0.1.Solidworks/arduino/Arduino Nano/PLD-2.step.SLDPRT
2.54 x 5.08 x 11.6 mm
