Kevinchu77/MobileRobot/0.1.Hardware/0.1.Solidworks/lm2596/LM2596 DC to DC Buck Converter 3 A/IC Cooler.SLDPRT

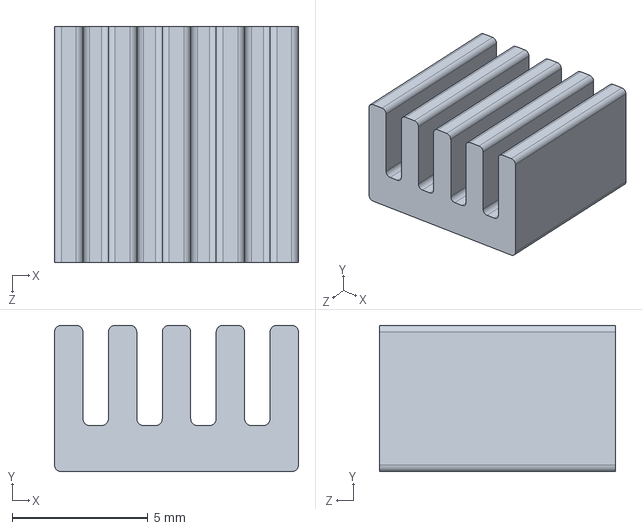
[picture p201: CAD file, 2023-02-20]
0.1.Hardware/0.1.Solidworks/lm2596/LM2596 DC to DC Buck Converter 3 A/IC Cooler.SLDPRT
9.00 x 5.40 x 8.70 mm
