Kevinchu77/MobileRobot/0.1.Hardware/0.1.Solidworks/arduino/Arduino Nano/Pushbutton3x4x2.SLDPRT

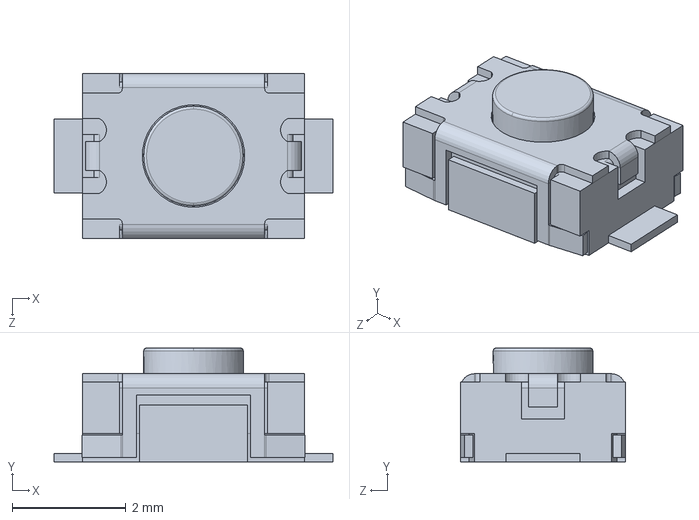
[picture p203: CAD file, 2023-02-20]
0.1.Hardware/0.1.Solidworks/arduino/Arduino Nano/Pushbutton3x4x2.SLDPRT
4.90 x 2.00 x 2.90 mm
