Kevinchu77/MobileRobot/0.1.Hardware/0.1.Solidworks/lm2596/LM2596 DC to DC Buck Converter 3 A/smdS537diode.SLDPRT

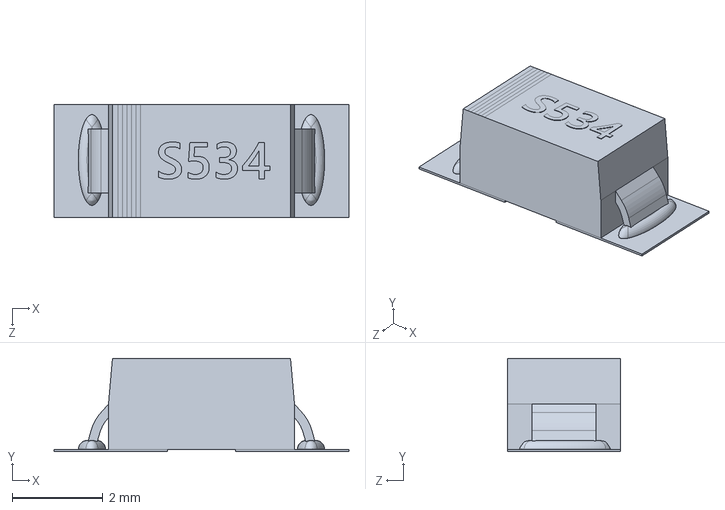
[picture p204: CAD file, 2023-02-20]
0.1.Hardware/0.1.Solidworks/lm2596/LM2596 DC to DC Buck Converter 3 A/smdS537diode.SLDPRT
6.50 x 2.06 x 2.50 mm
