Kevinchu77/MobileRobot/0.1.Hardware/0.1.Solidworks/arduino/Arduino Nano/FTDI FT232RL.SLDPRT

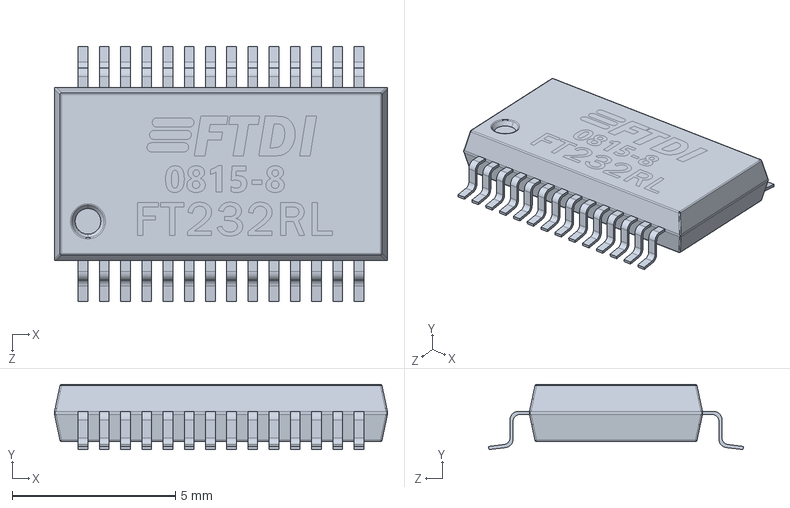
[picture p208: CAD file, 2023-02-20]
0.1.Hardware/0.1.Solidworks/arduino/Arduino Nano/FTDI FT232RL.SLDPRT
10.2 x 2.00 x 7.81 mm
