Kevinchu77/MobileRobot/0.1.Hardware/0.1.Solidworks/PASS DC SERVO GM 25-370 GEAR MOTOR.SLDPRT

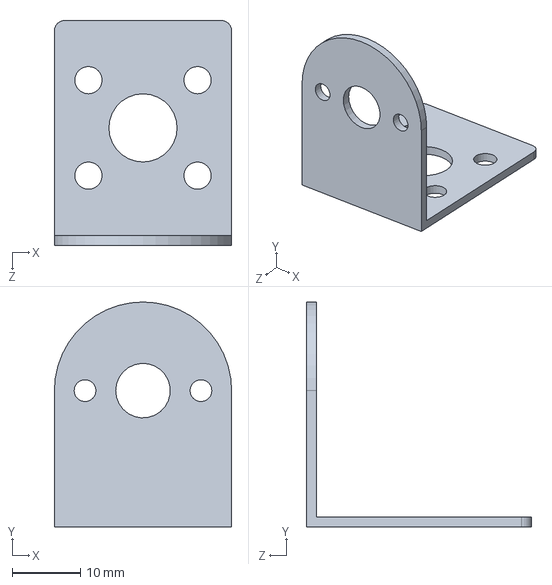
[picture p209: CAD file, 2023-02-20]
0.1.Hardware/0.1.Solidworks/PASS DC SERVO GM 25-370 GEAR MOTOR.SLDPRT
26.0 x 33.0 x 33.0 mm
