Kevinchu77/MobileRobot/0.1.Hardware/0.1.Solidworks/tru_dong/hexagonal_spacer_MF_M3_H08_HEX5.5_FTD4_MTL6.step

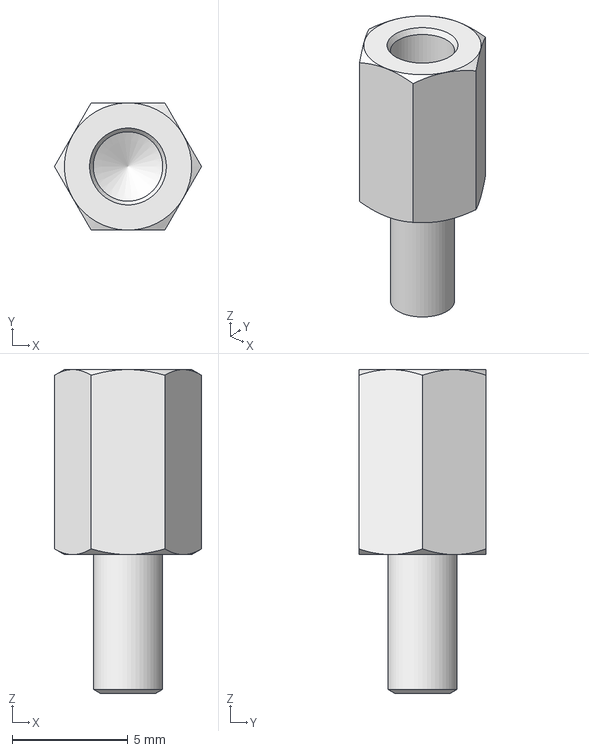
[picture p210: CAD file, 2023-02-20]
0.1.Hardware/0.1.Solidworks/tru_dong/hexagonal_spacer_MF_M3_H08_HEX5.5_FTD4_MTL6.step
6.36 x 5.51 x 14.0 mm
