Kevinchu77/MobileRobot/0.1.Hardware/0.1.Solidworks/arduino/Arduino Nano/1x15 Male Pin Header.SLDPRT

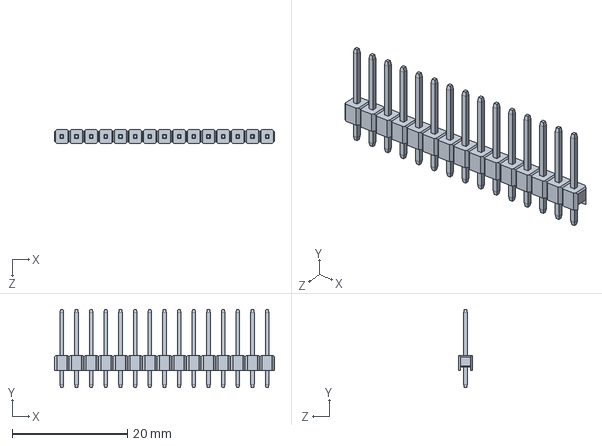
[picture p212: CAD file, 2023-02-20]
0.1.Hardware/0.1.Solidworks/arduino/Arduino Nano/1x15 Male Pin Header.SLDPRT
38.1 x 13.5 x 2.50 mm
