Kevinchu77/MobileRobot/0.1.Hardware/0.1.Solidworks/base_lot.SLDPRT

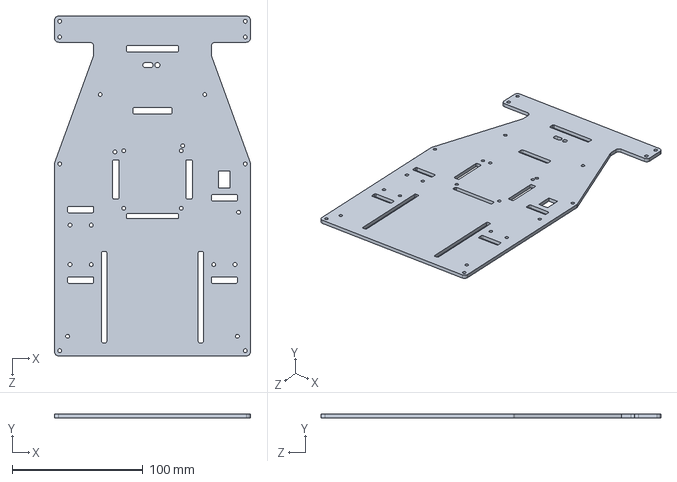
[picture p213: CAD file, 2023-02-20]
0.1.Hardware/0.1.Solidworks/base_lot.SLDPRT
150.0 x 3.00 x 260.0 mm
