Kevinchu77/MobileRobot/0.1.Hardware/0.1.Solidworks/arduino/Arduino Nano/0805 Chip SMD LED (2x1.2mm).step.SLDPRT

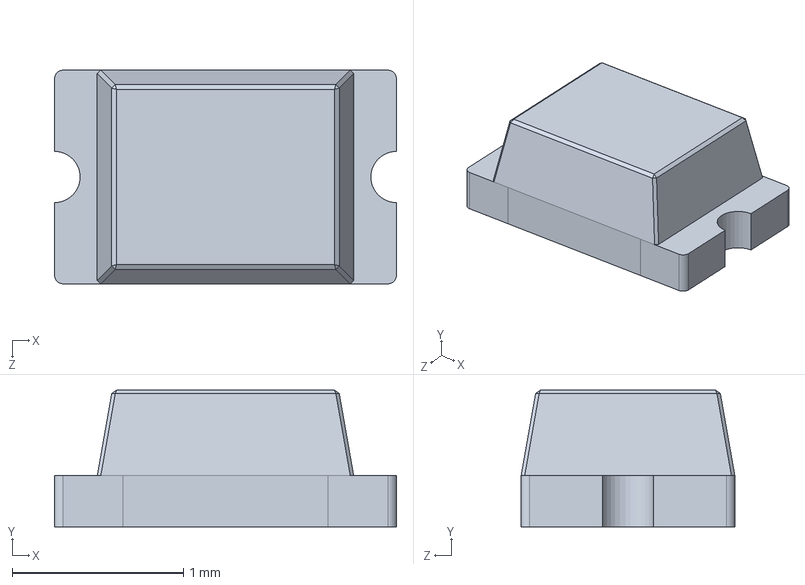
[picture p215: CAD file, 2023-02-20]
0.1.Hardware/0.1.Solidworks/arduino/Arduino Nano/0805 Chip SMD LED (2x1.2mm).step.SLDPRT
2.00 x 0.8 x 1.25 mm
