Kevinchu77/MobileRobot/0.1.Hardware/0.1.Solidworks/arduino/Arduino Nano/User Library-C0805-2.step.SLDPRT

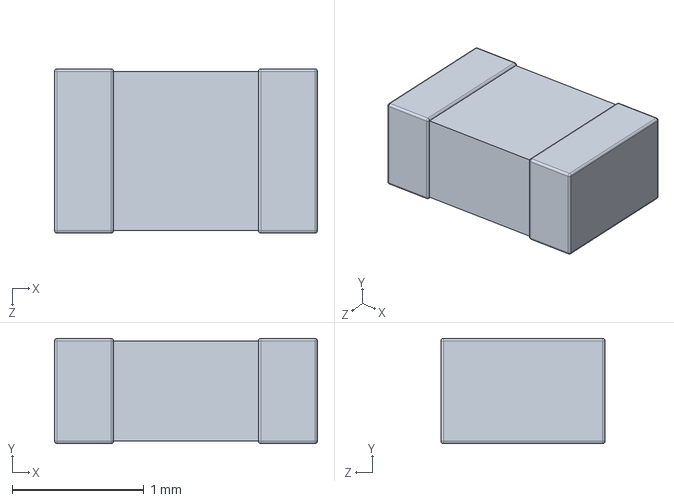
[picture p217: CAD file, 2023-02-20]
0.1.Hardware/0.1.Solidworks/arduino/Arduino Nano/User Library-C0805-2.step.SLDPRT
2.00 x 0.8 x 1.25 mm
