Kevinchu77/MobileRobot/0.1.Hardware/0.1.Solidworks/L298N Driver DC Motor, Stepper Motor.step.SLDPRT

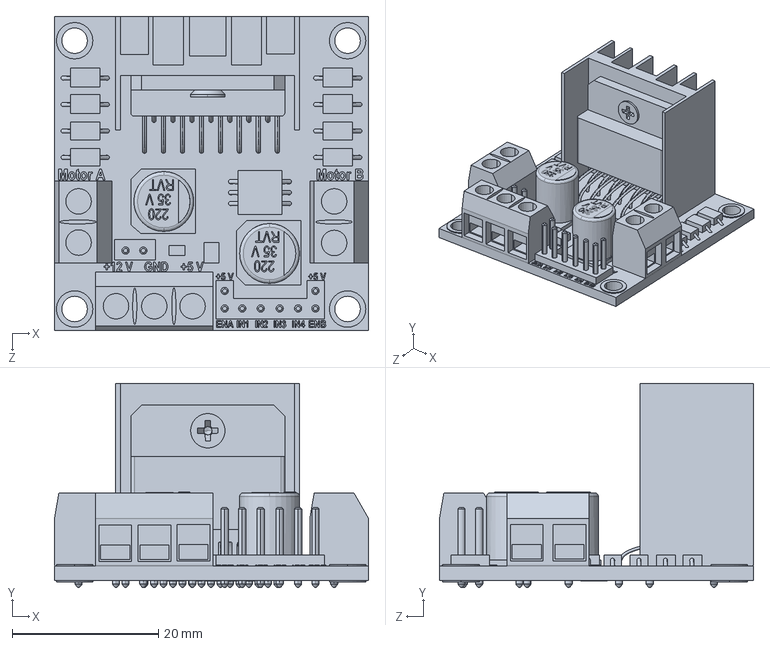
[picture p223: CAD file, 2023-02-20]
0.1.Hardware/0.1.Solidworks/L298N Driver DC Motor, Stepper Motor.step.SLDPRT
43.0 x 28.0 x 43.0 mm
