Kevinchu77/MobileRobot/0.1.Hardware/0.1.Solidworks/tru_dong/hexagonal_spacer_MF_M3_H15_HEX5.5_FTD6_MTL6.step

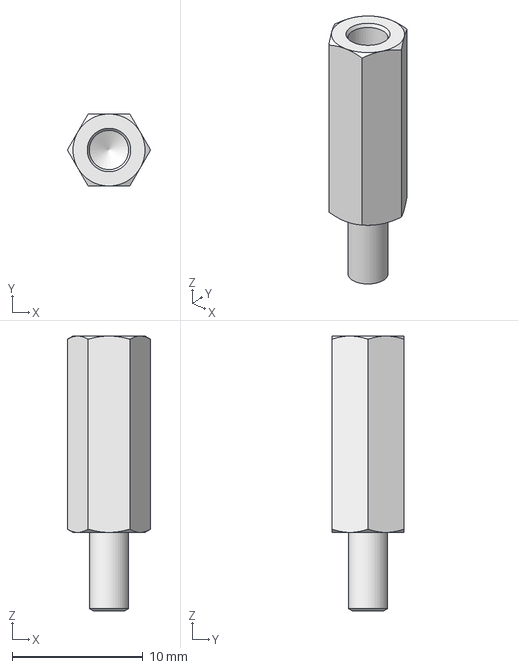
[picture p224: CAD file, 2023-02-20]
0.1.Hardware/0.1.Solidworks/tru_dong/hexagonal_spacer_MF_M3_H15_HEX5.5_FTD6_MTL6.step
6.36 x 5.51 x 21.0 mm
