Kevinchu77/MobileRobot/0.1.Hardware/0.1.Solidworks/tru_dong/hexagonal_spacer_MF_M3_H40_HEX5.5_FTD10_MTL10.step

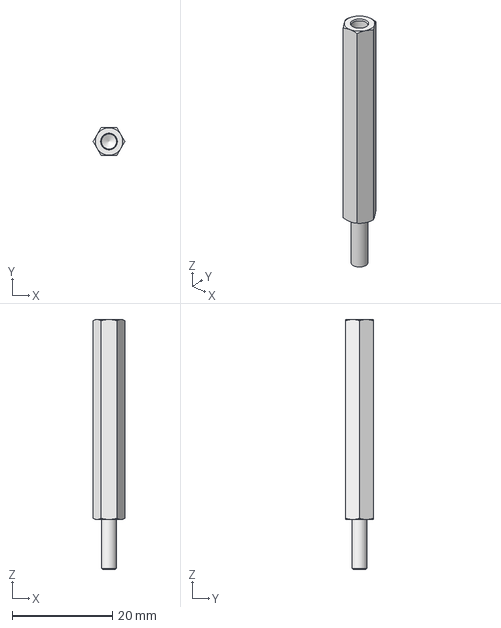
[picture p225: CAD file, 2023-02-20]
0.1.Hardware/0.1.Solidworks/tru_dong/hexagonal_spacer_MF_M3_H40_HEX5.5_FTD10_MTL10.step
6.36 x 5.51 x 50.0 mm
