Kevinchu77/MobileRobot/0.1.Hardware/0.1.Solidworks/tru_dong/hexagonal_spacer_MF_M3_H05_HEX5.5_FTD3_MTL8.step

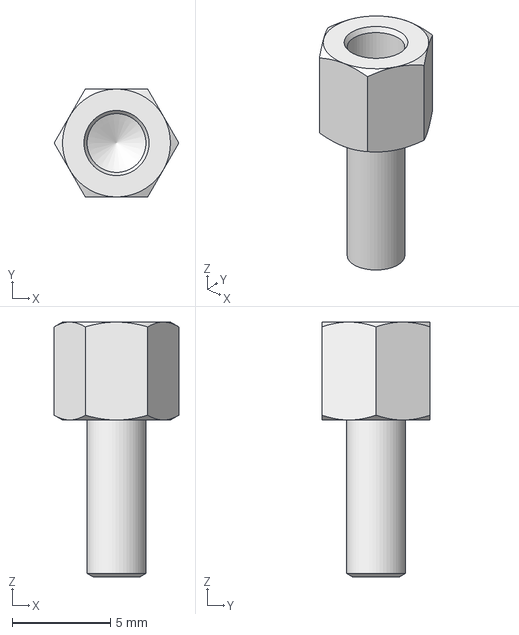
[picture p226: CAD file, 2023-02-20]
0.1.Hardware/0.1.Solidworks/tru_dong/hexagonal_spacer_MF_M3_H05_HEX5.5_FTD3_MTL8.step
6.36 x 5.51 x 13.0 mm
