Kevinchu77/MobileRobot/0.1.Hardware/0.1.Solidworks/base_sensor.SLDPRT

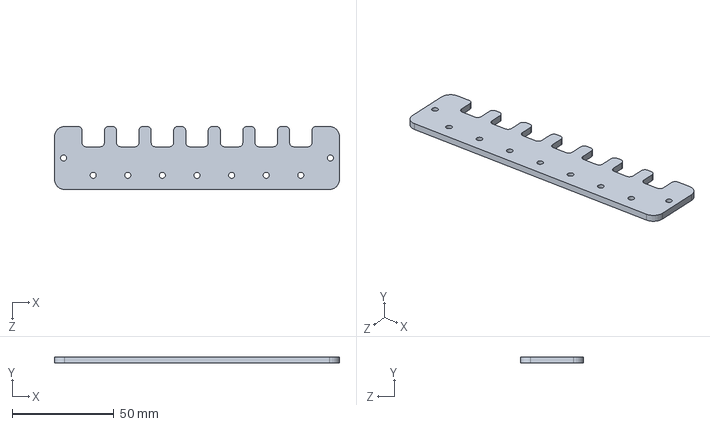
[picture p231: CAD file, 2023-02-20]
0.1.Hardware/0.1.Solidworks/base_sensor.SLDPRT
140.0 x 3.00 x 31.0 mm
