Kevinchu77/MobileRobot/0.1.Hardware/0.1.Solidworks/DONG CO dc GM25-370 SERVO GEAR.SLDPRT

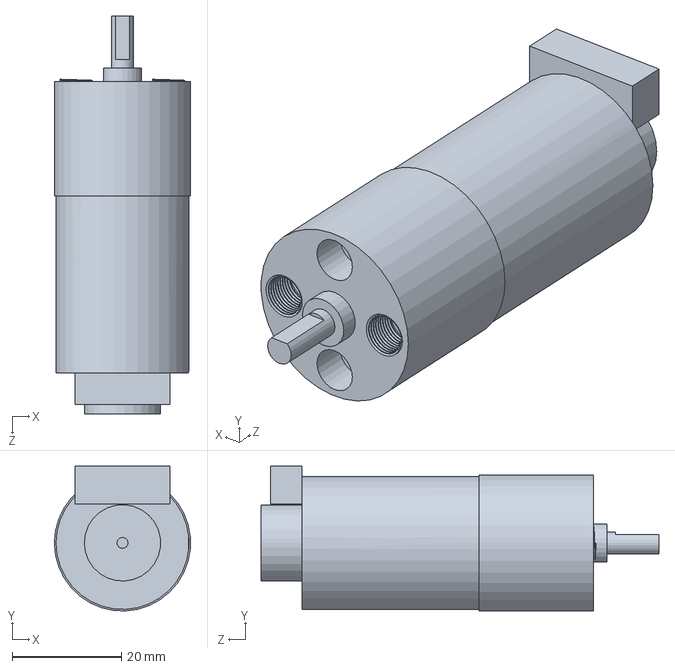
[picture p235: CAD file, 2023-02-20]
0.1.Hardware/0.1.Solidworks/DONG CO dc GM25-370 SERVO GEAR.SLDPRT
25.0 x 26.6 x 73.0 mm
