Kevinchu77/MobileRobot/0.1.Hardware/0.1.Solidworks/de.SLDPRT

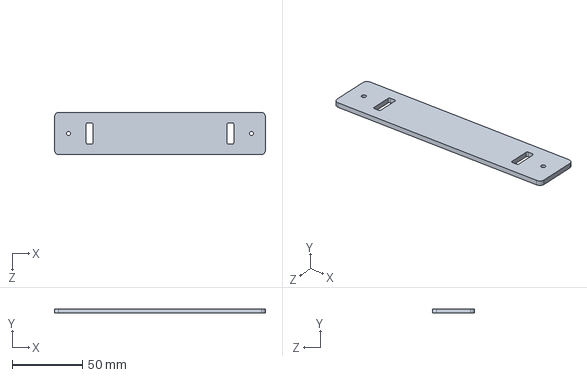
[picture p236: CAD file, 2023-02-20]
0.1.Hardware/0.1.Solidworks/de.SLDPRT
150.0 x 3.00 x 30.0 mm
