Kevinchu77/MobileRobot/0.1.Hardware/0.1.Solidworks/65mm tire.SLDPRT

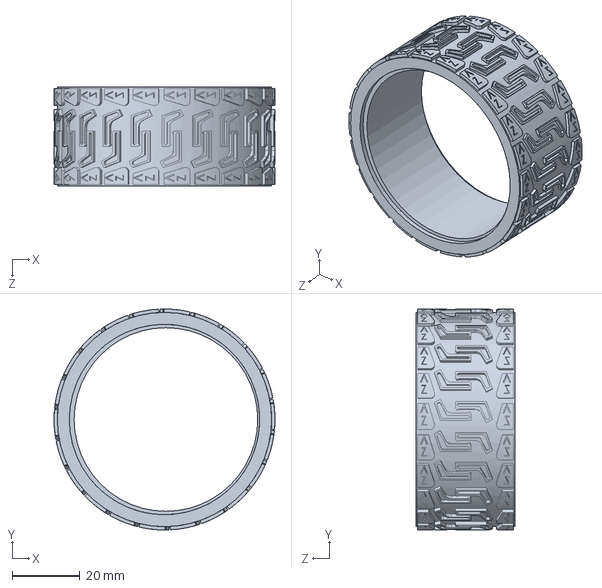
[picture p237: CAD file, 2023-02-20]
0.1.Hardware/0.1.Solidworks/65mm tire.SLDPRT
65.0 x 65.0 x 29.0 mm
