Kevinchu77/MobileRobot/0.1.Hardware/0.1.Solidworks/motor_adapter.SLDPRT

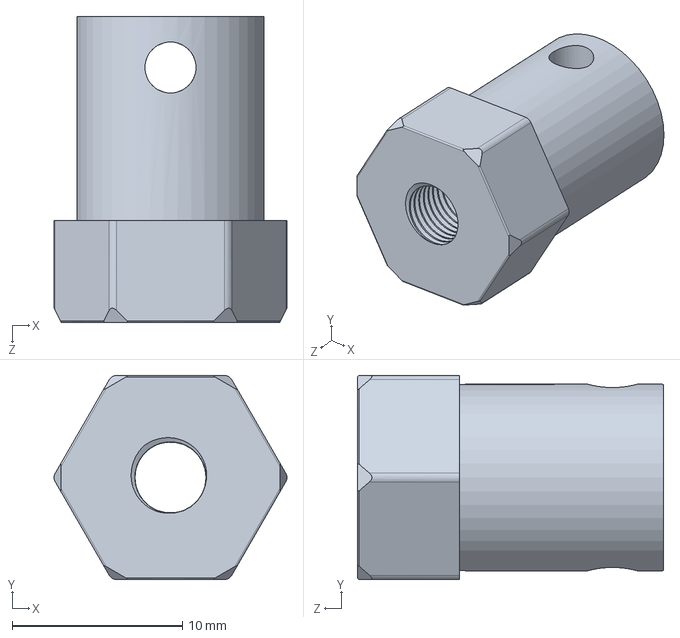
[picture p238: CAD file, 2023-02-20]
0.1.Hardware/0.1.Solidworks/motor_adapter.SLDPRT
13.7 x 12.0 x 18.0 mm
