Kevinchu77/MobileRobot/0.1.Hardware/0.1.Solidworks/blue_wheel_frame.SLDPRT

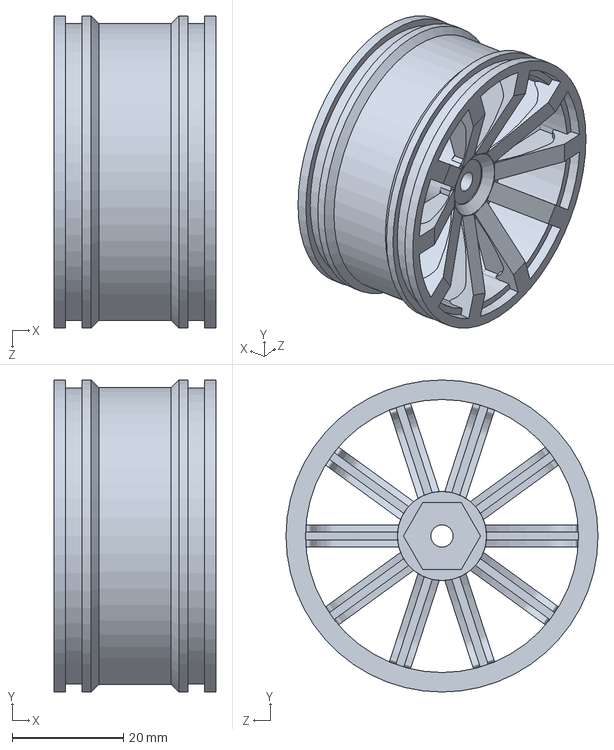
[picture p239: CAD file, 2023-02-20]
0.1.Hardware/0.1.Solidworks/blue_wheel_frame.SLDPRT
29.0 x 56.0 x 56.0 mm
