Kevinchu77/MobileRobot/0.1.Hardware/0.1.Solidworks/base_sensor_3mm.DXF

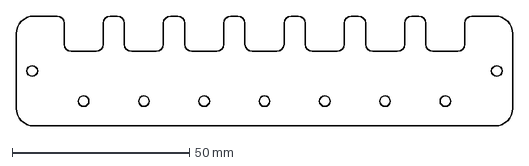
[picture p240: CAD file, 2023-02-20]
0.1.Hardware/0.1.Solidworks/base_sensor_3mm.DXF
140.0 x 31.0 mm
