Kevinchu77/MobileRobot/(list of files, cad)

Other CAD files:
0.1.Hardware/0.1.Solidworks/LineSensorAssy.step.SLDASM
0.1.Hardware/0.1.Solidworks/LM2596 DC to DC Buck Converter 3 A.STEP.SLDASM
0.1.Hardware/0.1.Solidworks/TCRT5000 v1 _1_.step.SLDASM
0.1.Hardware/0.1.Solidworks/banve-draft/MObile_Robot_01.DWG
0.1.Hardware/0.1.Solidworks/sensor_mid/LineSensor.STEP
0.1.Hardware/0.1.Solidworks/switch/kcd1.stp
0.4.Report/Lưu đồ giải thuật/Sơ đồ giải thuật.dwg
0.1.Hardware/0.1.Solidworks/banve-draft/MObile_Robot.DWG
0.1.Hardware/0.1.Solidworks/pin/Hold_18650-2p.stp
0.1.Hardware/0.1.Solidworks/smdS537diode.STEP.SLDPRT
0.1.Hardware/0.1.Solidworks/lm2596/LM2596 DC to DC Buck Converter 3 A/smd100uF.SLDPRT
0.1.Hardware/0.1.Solidworks/smdResistor331.STEP.SLDPRT
0.1.Hardware/0.1.Solidworks/sensor_mid/IRsensors.STEP
0.1.Hardware/0.1.Solidworks/C5 FD10 Reg.STEP.SLDPRT
0.1.Hardware/0.1.Solidworks/atmega328.STEP.SLDPRT
0.1.Hardware/0.1.Solidworks/SMD Crystal 16MHz.STEP.SLDPRT
0.1.Hardware/0.1.Solidworks/nano board.STEP.SLDPRT
0.1.Hardware/0.1.Solidworks/arduino/Arduino Nano/189 RESISTOR PACK.SLDPRT
0.1.Hardware/0.1.Solidworks/smdResistor102.STEP.SLDPRT
0.1.Hardware/0.1.Solidworks/tru_dong/hexagonal_spacer_MF_M3_H05_HEX5.5_FTD3_MTL6.step
0.1.Hardware/0.1.Solidworks/lm2596/LM2596 DC to DC Buck Converter 3 A/smdResistor331.SLDPRT
0.1.Hardware/0.1.Solidworks/Metal Contacts.step.SLDPRT
0.1.Hardware/0.1.Solidworks/Mini B USB.STEP.SLDPRT
0.1.Hardware/0.1.Solidworks/Pushbutton3x4x2.STEP.SLDPRT
0.1.Hardware/0.1.Solidworks/tru_dong/hexagonal_spacer_MF_M3_H16_HEX5.5_FTD6_MTL6.step
0.1.Hardware/0.1.Solidworks/tru_dong/hexagonal_spacer_MF_M3_H18_HEX5.5_FTD6_MTL6.step
0.1.Hardware/0.1.Solidworks/LEDs-1.step.SLDPRT
0.1.Hardware/0.1.Solidworks/PLD-2.step.STEP.SLDPRT
0.1.Hardware/0.1.Solidworks/User Library-C0805-2.step.STEP.SLDPRT
0.1.Hardware/0.1.Solidworks/Metal Contacts-3.step.SLDPRT
0.1.Hardware/0.1.Solidworks/tru_dong/hexagonal_spacer_MF_M3_H30_HEX5.5_FTD6_MTL6.step
0.1.Hardware/0.1.Solidworks/0805 Chip SMD LED (2x1.2mm).step.STEP.SLDPRT
0.1.Hardware/0.1.Solidworks/tru_dong/hexagonal_spacer_MF_M3_H14_HEX5.5_FTD6_MTL6.step
0.1.Hardware/0.1.Solidworks/hexagonal_spacer_MF_M3_H05_HEX5.5_FTD3_MTL8.step.SLDPRT
0.1.Hardware/0.1.Solidworks/Metal Contacts-2.step.SLDPRT
0.1.Hardware/0.1.Solidworks/tru_dong/hexagonal_spacer_MF_M3_H20_HEX5.5_FTD6_MTL6.step
0.1.Hardware/0.1.Solidworks/TrimmerW203.STEP.SLDPRT
0.1.Hardware/0.1.Solidworks/tru_dong/hexagonal_spacer_MF_M3_H30_HEX5.5_FTD10_MTL10.step.SLDPRT
0.1.Hardware/0.1.Solidworks/Tantalum Capacitor 475C A3216.STEP.SLDPRT
0.1.Hardware/0.1.Solidworks/smd220uF.STEP.SLDPRT
0.1.Hardware/0.1.Solidworks/Part 1.step.SLDPRT
0.1.Hardware/0.1.Solidworks/Diode MBR0520.STEP.SLDPRT
0.1.Hardware/0.1.Solidworks/102 RESISTOR PACK.STEP.SLDPRT
0.1.Hardware/0.1.Solidworks/LEDs.step.SLDPRT
0.1.Hardware/0.1.Solidworks/smdLED.STEP.SLDPRT
0.1.Hardware/0.1.Solidworks/shell.step.SLDPRT
0.1.Hardware/0.1.Solidworks/Hold_18650-4p-prt1.stp.SLDPRT
0.1.Hardware/0.1.Solidworks/smdceramiccapacitor.STEP.SLDPRT
0.1.Hardware/0.1.Solidworks/hexagonal_spacer_MF_M3_H10_HEX5.5_FTD6_MTL6.step.SLDPRT
0.1.Hardware/0.1.Solidworks/Metal Contacts-0.step.SLDPRT
0.1.Hardware/0.1.Solidworks/FTDI FT232RL.STEP.SLDPRT
0.1.Hardware/0.1.Solidworks/smd100uF.STEP.SLDPRT
0.1.Hardware/0.1.Solidworks/Rocker Switch_KCD1-101_3pin.stp.SLDPRT
0.1.Hardware/0.1.Solidworks/Hold_18650-2p-prt0.stp.SLDPRT
0.1.Hardware/0.1.Solidworks/smbInductor470.STEP.SLDPRT
0.1.Hardware/0.1.Solidworks/BreadBord.step.SLDPRT
0.1.Hardware/0.1.Solidworks/TCRT5000 v1.step.SLDPRT
0.1.Hardware/0.1.Solidworks/189 RESISTOR PACK.STEP.SLDPRT
0.1.Hardware/0.1.Solidworks/1x15 Male Pin Header.STEP.SLDPRT
0.1.Hardware/0.1.Solidworks/Hold_18650-2p-prt1.stp.SLDPRT
0.1.Hardware/0.1.Solidworks/Hold_18650-4p-prt0.stp.SLDPRT
0.1.Hardware/0.1.Solidworks/LM2596S.STEP.SLDPRT
0.1.Hardware/0.1.Solidworks/ball castor CY 15A (2).step
0.1.Hardware/0.1.Solidworks/ball.step.SLDPRT
0.1.Hardware/0.1.Solidworks/banve-draft/MObile_Robot.SLDDRW
0.1.Hardware/0.1.Solidworks/base_xedoline.SLDPRT
0.1.Hardware/0.1.Solidworks/hexagonal_spacer_MF_M3_H25_HEX5.5_FTD6_MTL6.step.SLDPRT
0.1.Hardware/0.1.Solidworks/lm2596/LM2596 DC to DC Buck Converter 3 A.x_t
0.1.Hardware/0.1.Solidworks/lm2596board.STEP.SLDPRT
0.1.Hardware/0.1.Solidworks/sensor_mid/senser_psd_2_asm.igs
