Kevinchu77/MobileRobot/0.4.Report/Bản vẽ Cơ Khí/Bản vẽ CK.pdf

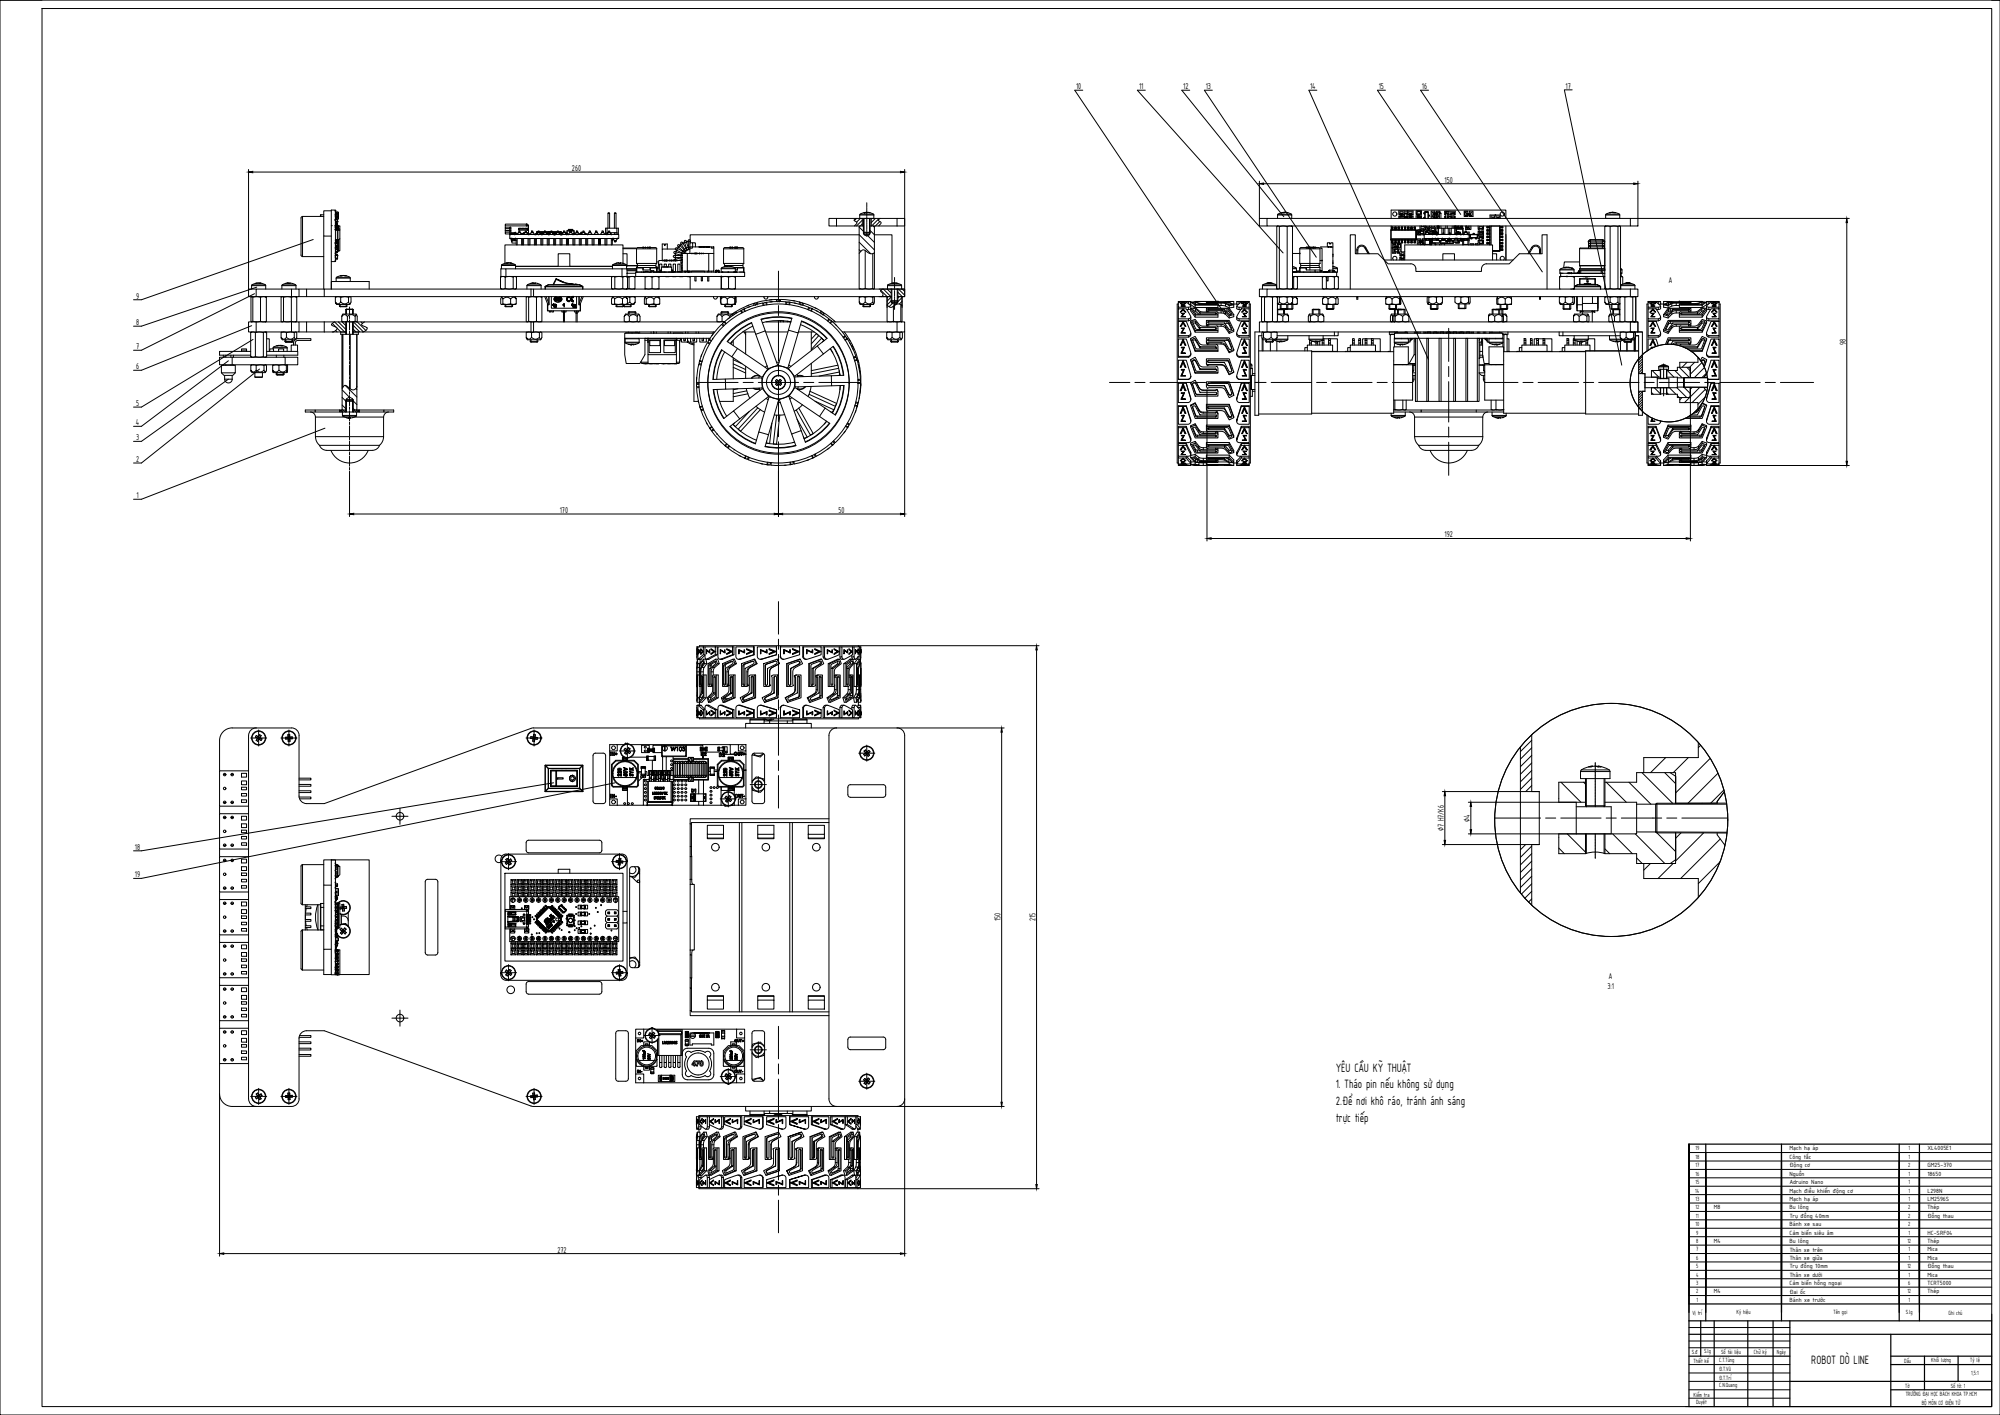
[picture p241: page 1]
Số tài liệu; Chữ ký; Ngày; Thiết kế; ROBOT DÒ LINE; Dấu; Khối lượng; Kiểm tra; Vị trí; Ký hiệu; Tên gọi; Ghi chú 1; Bánh xe trước 23; Đồng thau; Mạch hạ áp; Adruino Nano; Động cơ; Công tắc; Mạch điều khiển động cơ

YÊU CẦU KỸ THUẬT
1. Tháo pin nếu không sử dụng
2.Để nơi khô ráo, tránh ánh sáng
trực tiếp

Bu lông
Trụ đồng 40mm
Bánh xe sau
Cảm biến siêu âm
Thân xe trên
Thân xe giữa
Trụ đồng 10mm
Thân xe dưới
Cảm biến hồng ngoại
Đai ốc

TRƯỜNG ĐẠI HỌC BÁCH KHOA TP.HCM
BỘ MÔN CƠ ĐIỆN TỬ
