Kevinchu77/MobileRobot/0.4.Report/Bản vẽ Điện/Bản vẽ Điện.pdf

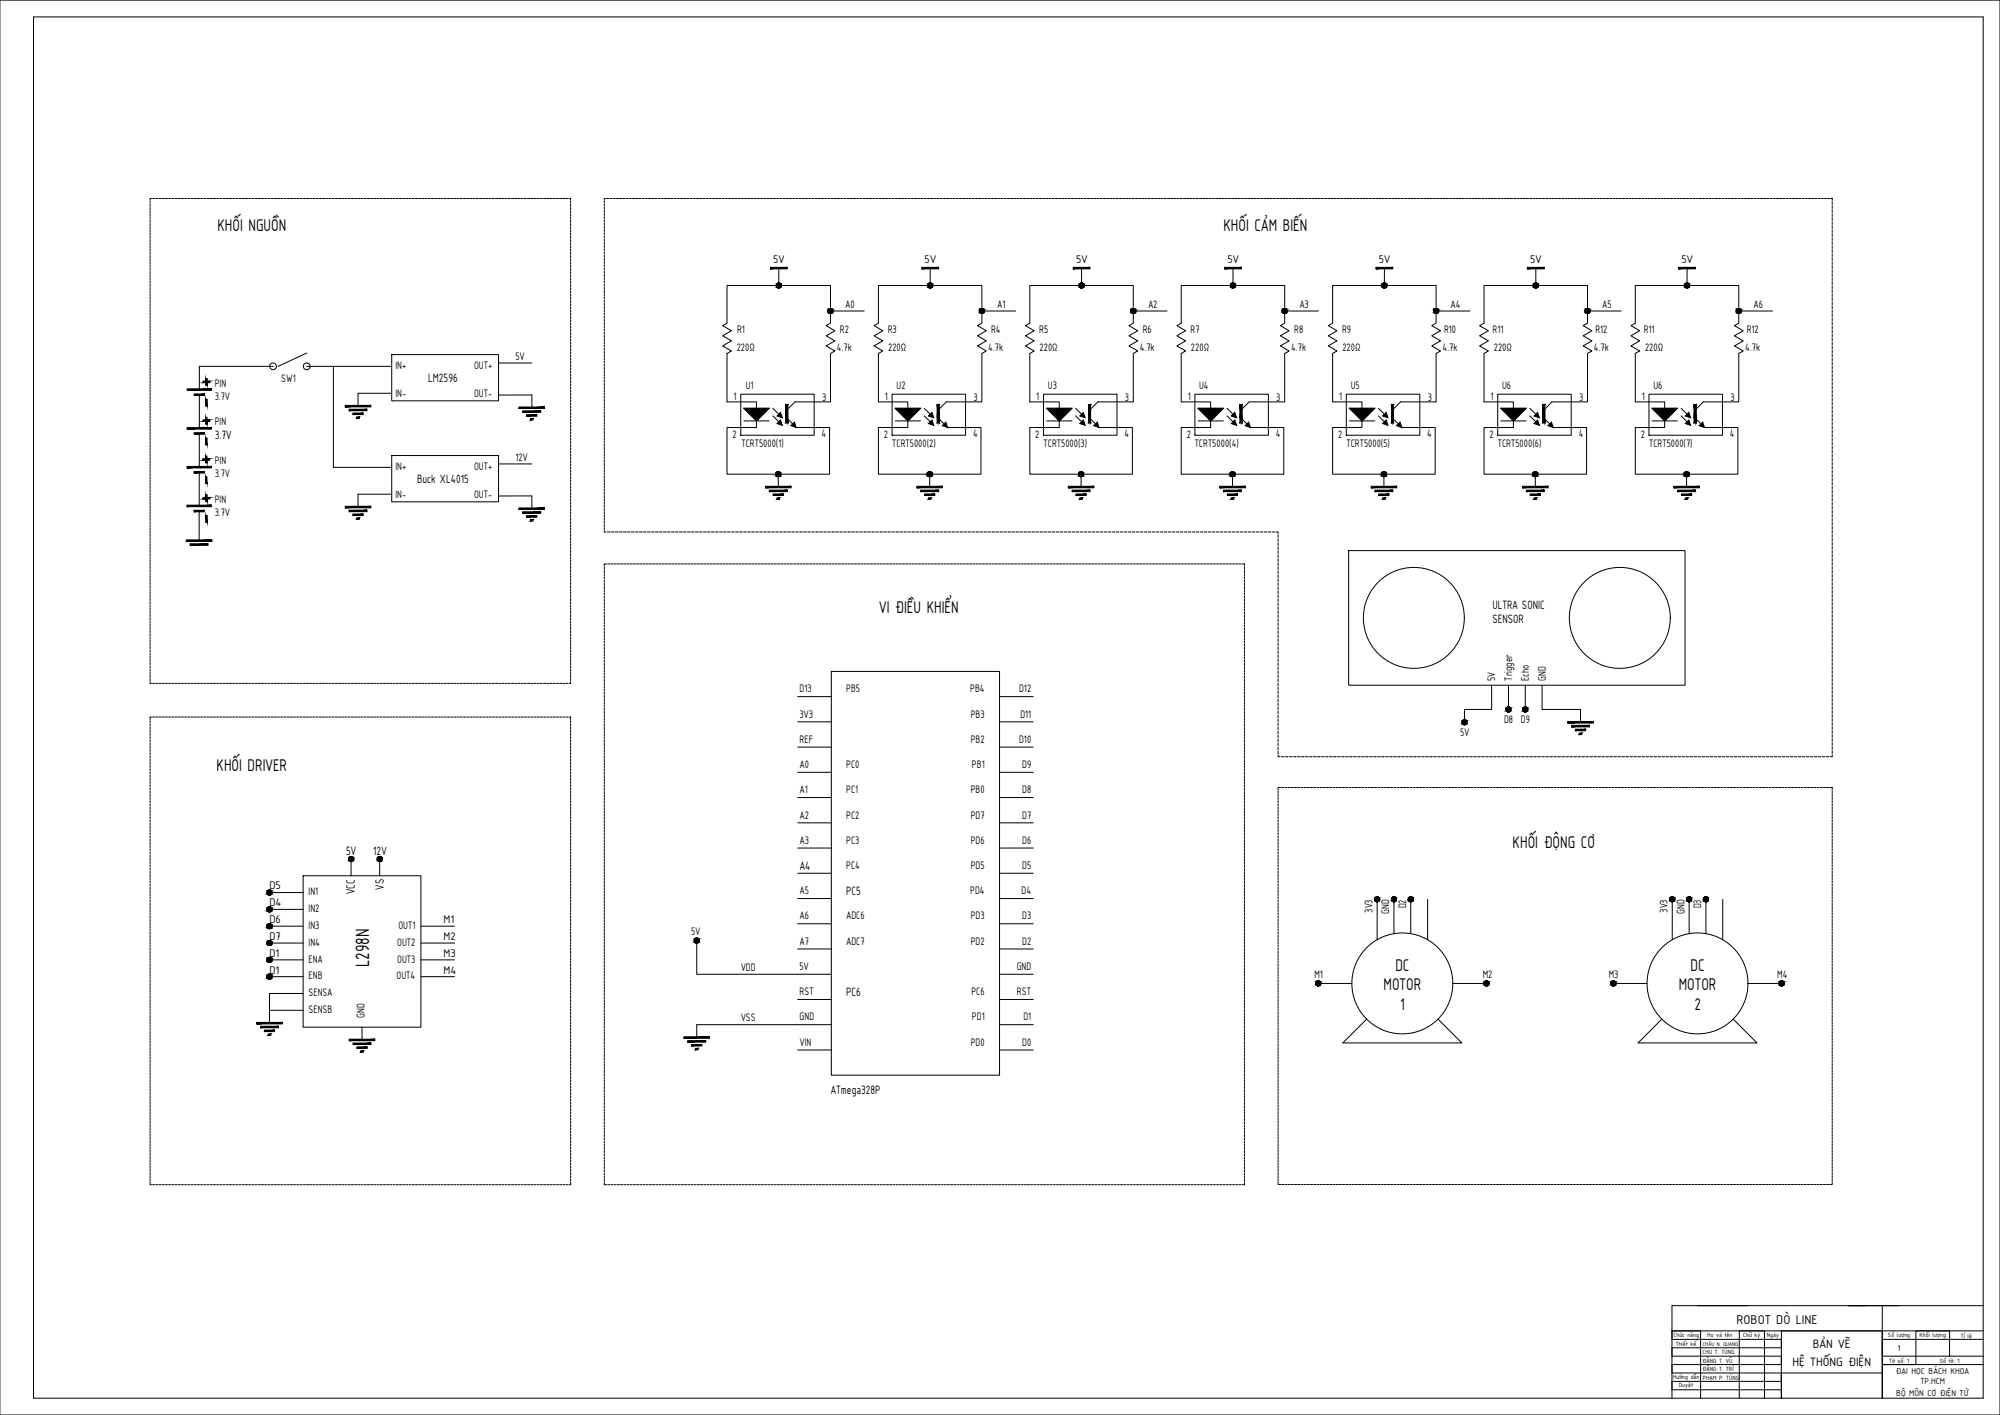
[picture p242: page 1]

GND 5V D8 D9 ULTRA SONIC SENSOR PIN 3.7V PIN 3.7V PIN 3.7V 5V 12V OUT4 OUT1 M1 M2 M3 M4 A6 R12 4.7k R11 220ΩU6 TCRT5000(7) 12 34 5V KHỐI DRIVER KHỐI ĐỘNG CƠ VI ĐIỀU KHIỂN

GND 12V Buck XL4015 IN+ IN- OUT+ OUT- D13 3V3 REF A0A1 A2A3A4A5A6A75VRST GND VIN D12 D11 D10D9D8D7D6D5 D4D3D2 GND RSTD1 D0 PB5 PC0 PC1 PC2 PC3 PC4 PC5 ADC6 ADC7 PC6 PB4 PB3 PB2 PB1 PB0 PD7 PD6 PD5 PD4 PD3 PD2 PC6 PD1 PD0 M3M4 5V VDD VSS D6D7D1 ATmega328P

D3 DC MOTOR 2 IN1 IN2 IN3 IN4 ENA ENB SENSA SENSB OUT2 OUT3

Chức năng | Họ và tên | Chữ ký | Ngày | BẢN VẼ HỆ THỐNG ĐIỆN | Số lượng | Khối lượng | Tỉ lệ
Thiết kế | CHÂU N. QUANG

CHU T. TÙNG

ĐẶNG T. TRÍ | | | | ĐẠI HỌC BÁCH KHOA TP.HCM BỘ MÔN CƠ ĐIỆN TỬ

Hướng dẫn | PHẠM P. TÙNG
Duyệt
