Kevinchu77/MobileRobot/0.4.Report/Diagram/Ban-ve-lua-chon-phuong-an.pdf

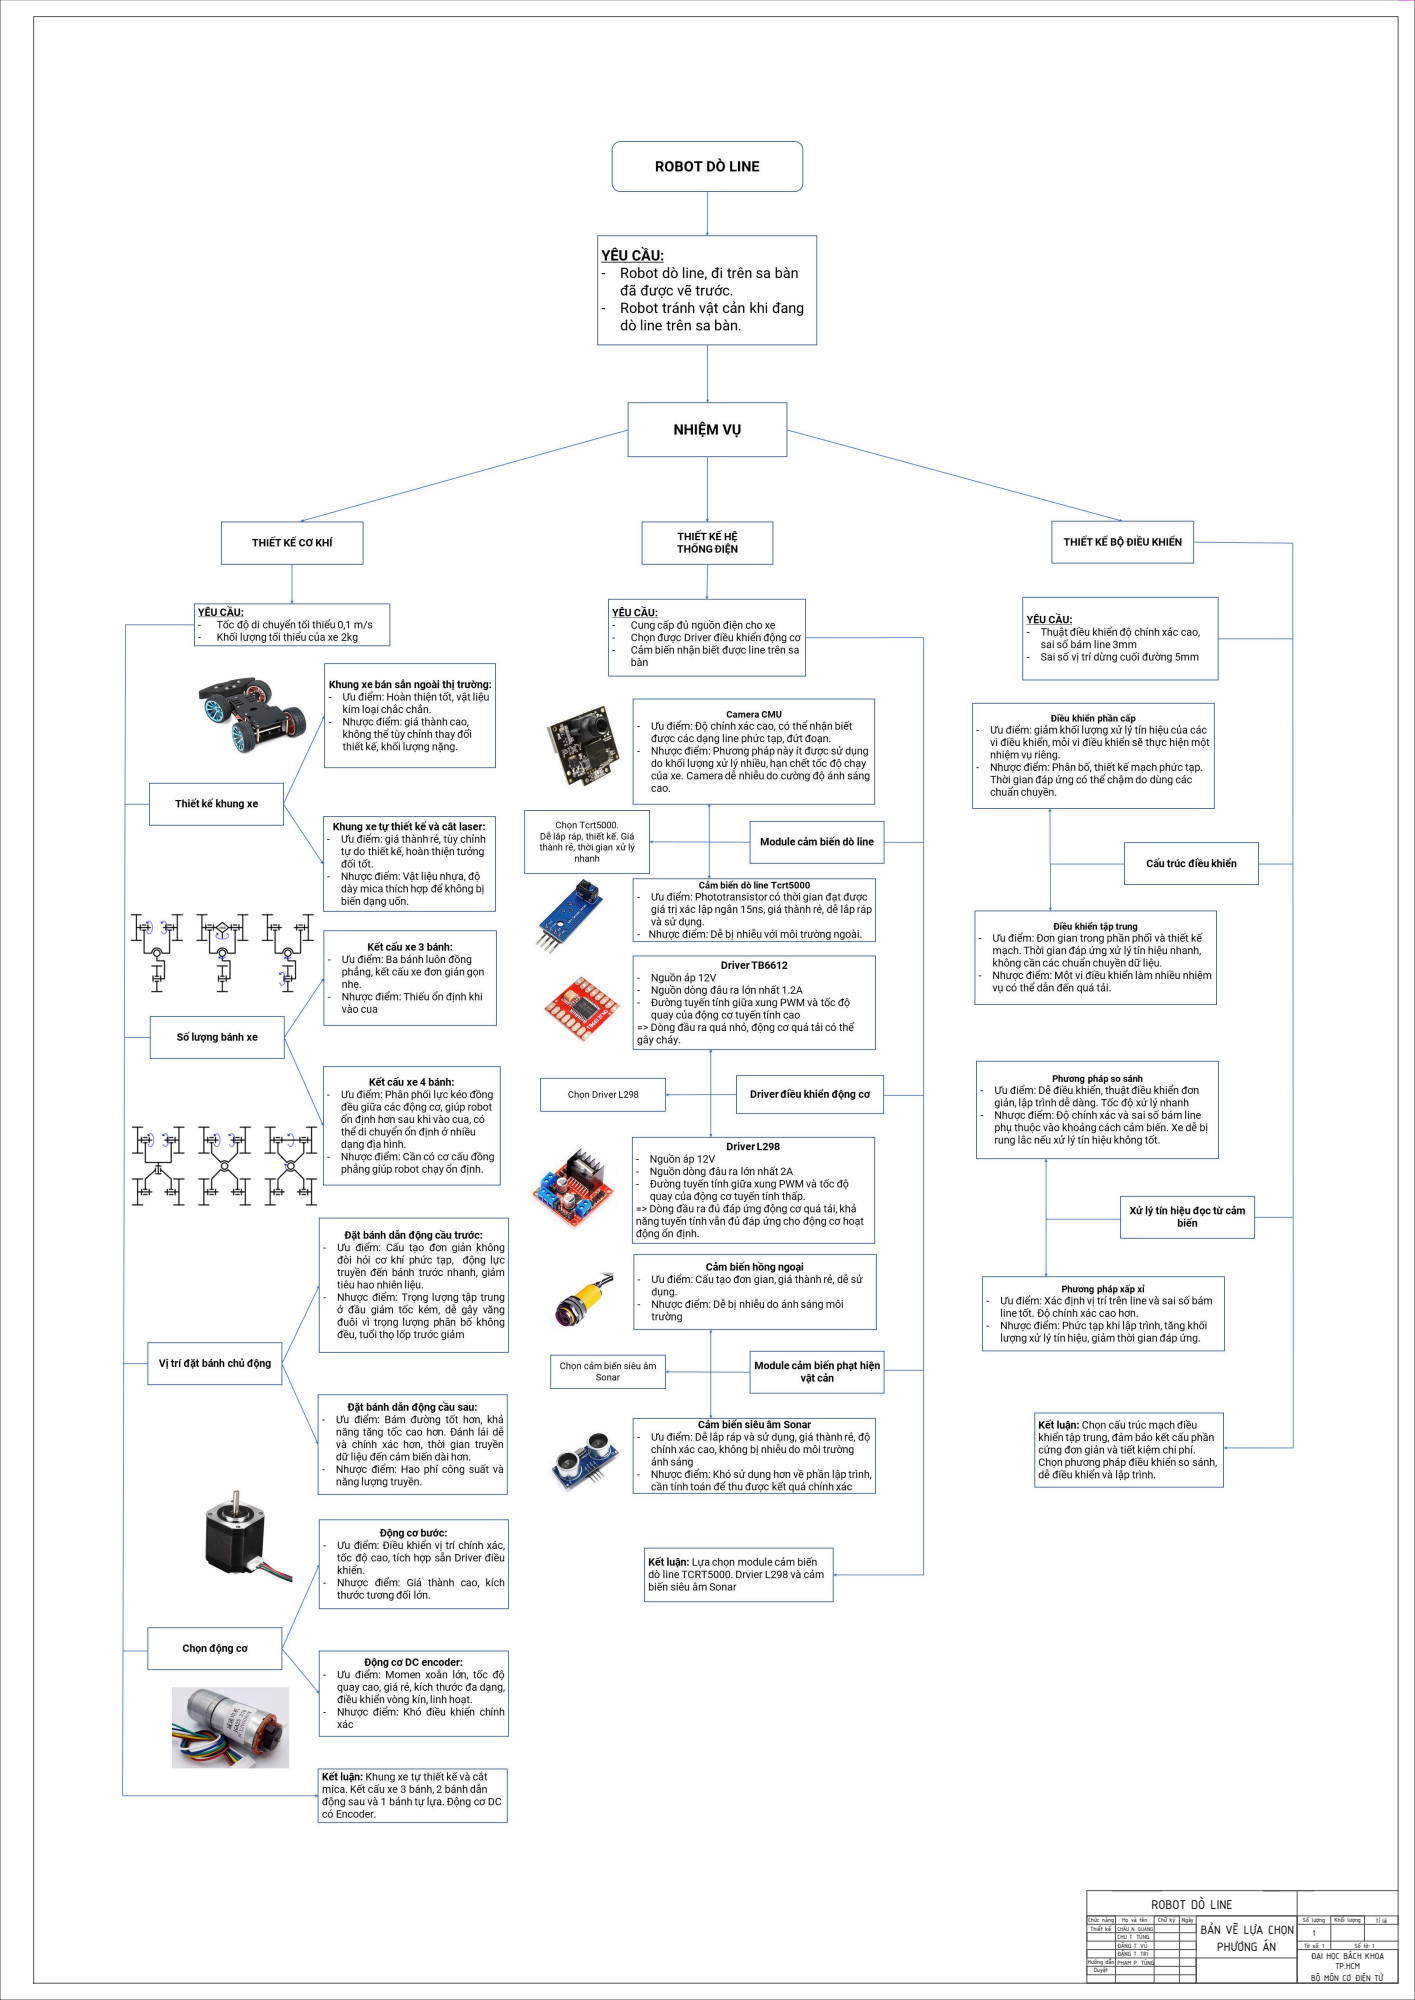
[picture p243: page 1]

ROBOT DÒ LINE

Chức năng | Họ và tên | Chữ ký | Ngày | BẢN VẼ LỰA CHỌN PHƯƠNG ÁN | Số lượng 1 | Khối lượng | Tỉ lệ
Thiết kế | CHÂU N. QUANG

CHU T. TÙNG
ĐẶNG T. VŨ | | | | Tờ số: 1 | Số tờ: 1
ĐẶNG T. TRÍ | | | | ĐẠI HỌC BÁCH KHOA TP.HCM BỘ MÔN CƠ ĐIỆN TỬ

Hướng dẫn | PHẠM P. TÙNG
Duyệt
