Kevinchu77/MobileRobot/0.4.Report/Lưu đồ giải thuật/Lưu đồ giải thuật.pdf

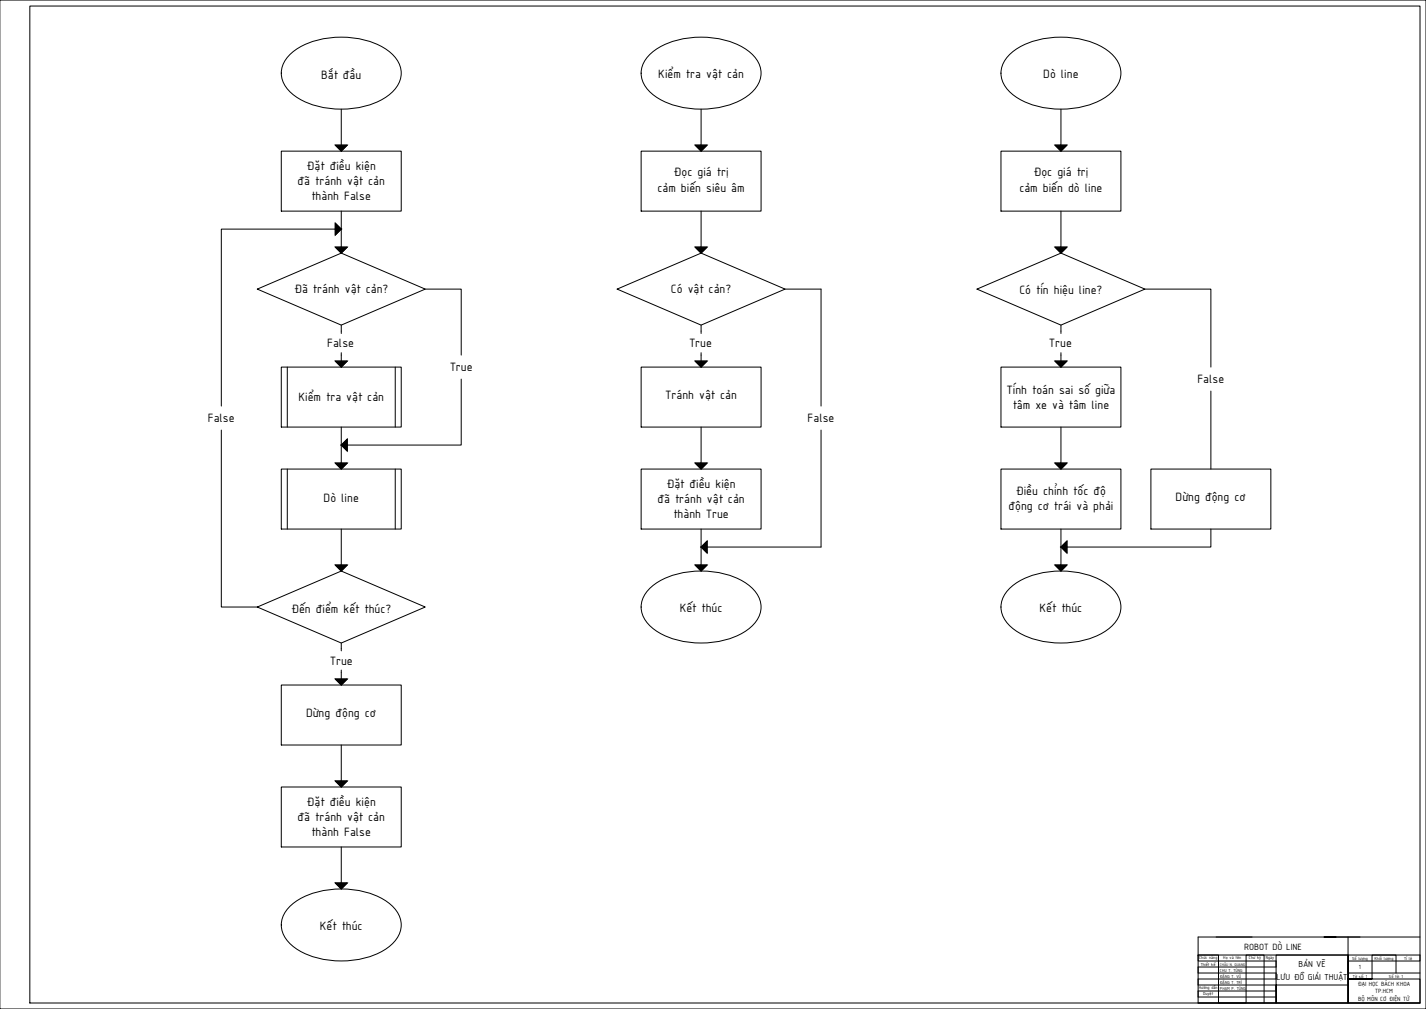
[picture p244: page 1]
Bắt đầu Đặt điều kiện đã tránh vật cản thành False Đã tránh vật cản? Đến điểm kết thúc?; True False; Kiểm tra vật cản Dò line Dừng động cơ Đặt điều kiện đã tránh vật cản thành False Kết thúc False True; Kiểm tra vật cản Đọc giá trị cảm biến siêu âm Có vật cản?; False Tránh vật cản True Đặt điều kiện đã tránh vật cản thành True Kết thúc; Dò line Đọc giá trị cảm biến dò line Có tín hiệu line? Tính toán sai số giữa tâm xe và tâm line True Điều chỉnh tốc độ động cơ trái và phải Kết thúc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
