Kevinchu77/MobileRobot/0.1.Hardware/0.1.Solidworks/banve-draft/MObile_Robot.PDF

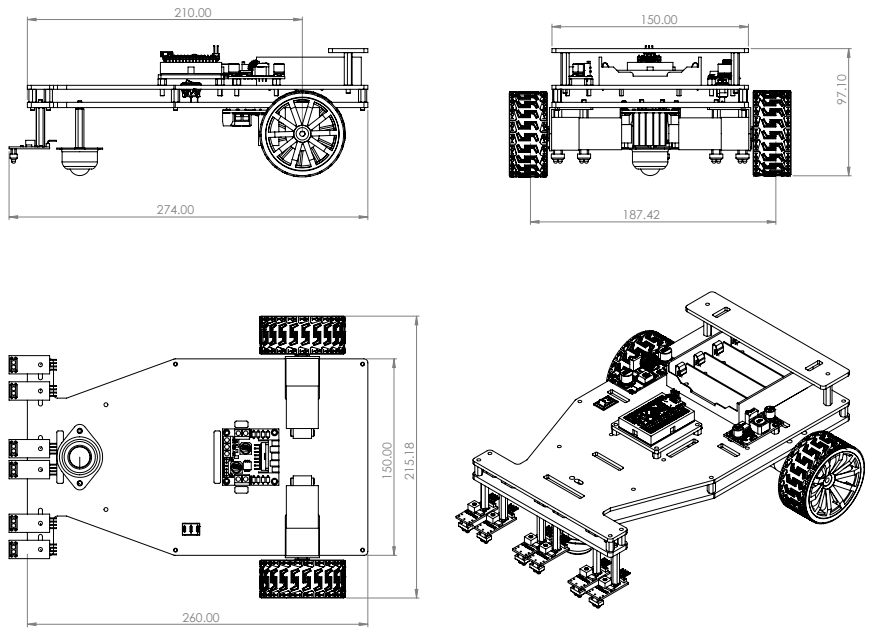
[picture p245: page 1]
